kuopinghsu/jv32.dev/fpga/README.md

# jv32 SoC — FPGA Implementation (Kintex UltraScale+ KU5P)

**Tool:** Vivado ML Standard (free licence)
**Part:** `xcku5p-ffvb676-2-i` (Kintex UltraScale+, -2I speed grade, 676-pin FFVB)
**Default debug interface:** cJTAG / 2-wire OScan1 (`USE_CJTAG=1`)

---

## Directory layout

```
fpga/
├── Makefile                        # build orchestration
├── README.md
├── images/
│   └── jv32_bd.svg                 # IP Integrator block design diagram
├── jtag/
│   ├── jv32_fpga_cjtag.cfg         # OpenOCD config – USE_CJTAG=1 (2-wire)
│   └── jv32_fpga_jtag.cfg          # OpenOCD config – USE_CJTAG=0 (4-wire)
├── rtl/
│   ├── jv32_fpga_top.sv            # FPGA top-level wrapper (IOBUF, USE_CJTAG mux)
│   └── jv32_soc_fpga.v             # Plain-Verilog BD module reference wrapper
├── constrs/
│   ├── constraints.xdc             # Shared pin / clock constraints (both modes)
│   ├── constraints_cjtag.xdc       # Implementation-only: USE_CJTAG=1 clock + I/O
│   └── constraints_jtag.xdc        # Implementation-only: USE_CJTAG=0 I/O delays
├── scripts/
│   ├── create_project.tcl          # Vivado project / synth / impl script
│   └── create_bd.tcl               # IP Integrator block design script
├── tests/
│   ├── Makefile
│   ├── fpga_stress.c               # Long-running FreeRTOS stability stress test
│   ├── mem_connect_check.gdb       # Quick JTAG smoke test (SBA path, ~30 s)
│   ├── mem_test_iram.gdb           # IRAM word pattern test (abstract mem, ~10 min)
│   ├── mem_test_dram.gdb           # DRAM word + byte/halfword test (abstract mem, ~15 min)
│   └── mem_test_progbuf.gdb        # IRAM + DRAM word pattern test (progbuf path, ~20 min)
└── build/                          # Vivado project output (git-ignored)
    ├── jv32_ku5p_cjtag.bit         # USE_CJTAG=1 bitstream (default)
    ├── jv32_ku5p_cjtag.mcs         # USE_CJTAG=1 SPI flash image
    ├── jv32_ku5p_cjtag.prm         # USE_CJTAG=1 flash programming params
    ├── jv32_ku5p_jtag.bit          # USE_CJTAG=0 bitstream
    ├── jv32_ku5p_jtag.mcs          # USE_CJTAG=0 SPI flash image
    └── jv32_ku5p_jtag.prm          # USE_CJTAG=0 flash programming params
```

---

## Prerequisites

| Requirement | Notes |
|---|---|
| Vivado ML Standard 2023.x or later | Free licence — no cost for KU5P devices |
| RISC-V GNU toolchain (`riscv64-unknown-elf-`) | For building `fpga/tests/` firmware |
| FT2232H-based JTAG/cJTAG probe | e.g. Digilent HS2, FTDI FT2232H mini-module |
| OpenOCD ≥ 0.12 with `oscan1_mode` support | Required for USE_CJTAG=1 |

Add `RISCV_PREFIX` to `env.config` if your toolchain prefix differs from the default.

---

## Quick start

```bash
cd fpga/

# Create Vivado project (cJTAG default, no synthesis yet)
make project

# Run synthesis only
make synth

# Full implementation + bitstream generation
make impl

# 4-wire JTAG variant
make impl USE_CJTAG=0
```

Bitstream and MCS files land in `build/`.

---

## Block Design

jv32 Block Design

The IP Integrator block design `jv32_bd` contains three cells:

| Cell | IP / Type | Role |
|---|---|---|
| `clk_wiz_0` | Clocking Wizard (MMCM) | 50 MHz board clock → 50 MHz clean `clk_out1`; exports `locked` |
| `proc_sys_reset_0` | Processor System Reset | Holds `rst_n` (active-low) low until MMCM `locked` asserts |
| `u_soc` | `jv32_soc_fpga` (RTL module ref) | jv32 SoC — plain-Verilog wrapper around `jv32_soc.sv` |

The `IOBUF` primitive (bidirectional TMSC pad) and the `USE_CJTAG` I/O mux are
**not** inside the block design — they live in `jv32_fpga_top.sv` because
Vivado's IP Integrator does not support inout ports on RTL module references.

The generated wrapper `jv32_bd_wrapper` is instantiated in `jv32_fpga_top.sv`,
which remains the synthesis and implementation top module.

### Block design external ports

| Port | Dir | Connected to (jv32_fpga_top.sv) |
|---|---|---|
| `clk_in1` | I | `clk_50m` (FPGA pin E18) |
| `jtag_tck_i` | I | `jtag_tck_i` port |
| `jtag_tmsc_in` | I | `tmsc_in` — IOBUF output (pad → fabric) |
| `jtag_tdi_i` | I | `jtag_tdi_i` port (muxed to `0` inside `jv32_soc_fpga` when `USE_CJTAG=1`) |
| `soc_tms_o` | O | `tmsc_out` — IOBUF input (fabric → pad, cJTAG only) |
| `soc_tms_oe` | O | `tmsc_oe_n` — IOBUF tristate (`T`), active-low |
| `soc_tdo_o` | O | `jtag_tdo_o` port (4-wire JTAG only) |
| `uart_rx_i` | I | `uart_rx_i` port |
| `uart_tx_o` | O | `uart_tx_o` port |

---

## I/O Pin Assignment

All user I/O is on the **HR (High Range) bank**, 3.3 V LVCMOS33, except the
system clock which is on an **HP (High Performance) bank**, 1.8 V LVCMOS18.

| Signal | Pin | Bank / Std | Direction | Function |
|---|---|---|---|---|
| `clk_50m` | E18 | HP / LVCMOS18 | I | 50 MHz system clock |
| `jtag_tck_i` | D11 | HR / LVCMOS33 | I | TCK (4-wire) / TCKC (cJTAG) |
| `jtag_tmsc_io` | E12 | HR / LVCMOS33 | I/O | TMS (4-wire) / TMSC (cJTAG, bidir) |
| `jtag_tdi_i` | C12 | HR / LVCMOS33 | I | TDI — 4-wire JTAG only; tie to GND in cJTAG |
| `jtag_tdo_o` | J12 | HR / LVCMOS33 | O | TDO — driven by TAP in both modes; not connected in cJTAG (TDO is read back via TMSC/E12) |
| `uart_tx_o` | G12 | HR / LVCMOS33 | O | UART TX |
| `uart_rx_i` | J14 | HR / LVCMOS33 | I | UART RX |
| `heartbeat_o` | H9 | HR / LVCMOS33 | O | LED6 — toggles every 2²⁴ retired instructions |
| `led1_o` | J11 | HR / LVCMOS33 | O | LED3 — 1 Hz blink (1 s on / 1 s off, from clk/rst_n) |
| `led2_o` | J10 | HR / LVCMOS33 | O | LED4 — invert of led1_o for cJTAG, 0 for JTAG |

---

## USE_CJTAG Configuration

`USE_CJTAG` selects the debug interface. The default is **`USE_CJTAG=1`** (2-wire cJTAG).

| `USE_CJTAG` | Interface | Wires used | `jtag_tmsc_io` (E12) | `jtag_tdi_i` (C12) | `jtag_tdo_o` (J12) |
|:---:|---|:---:|---|---|---|
| **1 (default)** | 2-wire cJTAG (IEEE 1149.7 OScan1) | TCKC + TMSC | **bidir** — IOBUF driven by SoC | tie to GND on PCB | driven by TAP (not connected in cJTAG wiring) |
| 0 | 4-wire JTAG (IEEE 1149.1) | TCK + TMS + TDI + TDO | input only — IOBUF permanently tristated | TDI data in | TDO data out |

The parameter is set at synthesis time:

```bash
make impl USE_CJTAG=1   # default: cJTAG (2-wire)
make impl USE_CJTAG=0   # 4-wire JTAG
```

Vivado passes it as a generics override on the fileset:
```tcl
set_property generic "USE_CJTAG=1'b${use_cjtag}" [current_fileset]
```

### IOBUF behaviour per mode

```
              USE_CJTAG=1 (cJTAG)          USE_CJTAG=0 (JTAG)
              ─────────────────────────    ────────────────────
IOBUF.T    =  soc_tms_oe (1=input, 0=drive)   1'b1  (always input)
IOBUF.I    =  soc_tms_o  (TMSC drive data)    1'b0  (unused)
IOBUF.O    =  tmsc_in  ──► SoC TMS/TMSC input (both modes)
jtag_tdo_o =  1'b0        (TDO unused)        soc_tdo_o
```

---

## Clock Architecture

### Shared constraints (`constraints.xdc`)

The 50 MHz system clock on E18 and the `create_clock` for it are owned by the
`clk_wiz_0` IP XDC (redefining it here would cause XDCC-1/XDCC-7 methodology
warnings).  The shared XDC only sets the pin and I/O standard, adds input
jitter, and declares the UART false paths:

```xdc
set_property PACKAGE_PIN E18 [get_ports clk_50m]
set_property IOSTANDARD LVCMOS18 [get_ports clk_50m]
set_input_jitter clk_50m 0.200

create_clock -period 100.000 -name jtag_tck [get_ports jtag_tck_i]
set_clock_groups -asynchronous \
    -group [get_clocks -include_generated_clocks clk_50m] \
    -group [get_clocks jtag_tck]
```

### USE_CJTAG=1 — `constraints_cjtag.xdc` (implementation only)

In cJTAG mode the TAP clock (`tap_tck`) is generated **inside the SoC** by
`cjtag_bridge` as a registered pulse, buffered through a `BUFG`
(`u_bufg_tck`).  The primary clock must be created on the **BUFG output pin**
to avoid TIMING-1 ("inappropriate pin for clock") and follow Xilinx UG949
recommendations for internally-generated clocks.

```xdc
create_clock -period 100.000 -name tap_tck -waveform {0.000 50.000} \
    [get_pins {u_bd/jv32_bd_i/u_soc/inst/u_soc/gen_jtag.u_jtag/
               gen_pin_mux_cjtag.u_cjtag_bridge/u_bufg_tck/O}]

set_clock_groups -asynchronous \
    -group [get_clocks tap_tck] \
    -group [get_clocks -include_generated_clocks clk_50m]

# tap_tck is downstream of clk_out1 (BUFG driven by an MMCM-clocked FF)
# → declare physically_exclusive to suppress TIMING-3 (AR#63774).
set_clock_groups -physically_exclusive \
    -group [get_clocks -include_generated_clocks clk_50m] \
    -group [get_clocks tap_tck]

set_false_path -from [get_ports jtag_tmsc_io]
set_false_path -to   [get_ports jtag_tmsc_io]
set_false_path -from [get_ports jtag_tdi_i]
set_false_path -to   [get_ports jtag_tdo_o]
```

Maximum TCKC frequency: **50 MHz ÷ 6 ≈ 8.3 MHz** (cjtag_bridge requirement:
`f_sys ≥ 6 × f_tckc`).  The OpenOCD config uses **5 MHz** for margin.

### USE_CJTAG=0 — `constraints_jtag.xdc` (implementation only)

In 4-wire JTAG mode the external `jtag_tck_i` pin is the primary clock source
(declared in `constraints.xdc`).  TDI is captured on the rising edge of TCK;
TDO is launched on the **falling** edge.

```xdc
set_false_path -from [get_ports jtag_tmsc_io]
set_false_path -to   [get_ports jtag_tmsc_io]

set_input_delay  -clock jtag_tck -max 10.0            [get_ports jtag_tdi_i]
set_input_delay  -clock jtag_tck -min  0.0 -add_delay [get_ports jtag_tdi_i]

set_output_delay -clock jtag_tck -clock_fall -max 10.0            [get_ports jtag_tdo_o]
set_output_delay -clock jtag_tck -clock_fall -min  0.0 -add_delay [get_ports jtag_tdo_o]
```

Maximum TCK frequency: **10 MHz** (100 ns period, `constraints.xdc`).
The OpenOCD config uses **10 MHz**; reduce to 1 MHz if signal integrity is poor.

### Clock domain summary

| Clock | Source | Frequency | Domain |
|---|---|---|---|
| `clk_out1_*` (system) | MMCM (`clk_wiz_0`) from E18 | 50 MHz | `jv32_soc`, AXI peripherals, UART, CLIC |
| `tap_tck` | Internal BUFG in `cjtag_bridge` | ≤ 8.3 MHz | TAP, DTM (`USE_CJTAG=1`) |
| `jtag_tck` | External pin D11 | ≤ 10 MHz | TAP, DTM (`USE_CJTAG=0`) |

The two clock domains are fully asynchronous; CDC is handled by the
multi-stage synchroniser chains in `jv32_dtm`.

---

## Vivado project variables

| Variable | Default | Description |
|---|---|---|
| `VIVADO` | `vivado` | Path to Vivado executable |
| `PROJ_NAME` | `jv32_ku5p` | Vivado project name |
| `PROJ_DIR` | `fpga/build` | Project output directory (repo-relative) |
| `TOP_MODULE` | `jv32_fpga_top` | Synthesis/implementation top module |
| `FPGA_PART` | `xcku5p-ffvb676-2-i` | Xilinx device part number |
| `JV32_CLK_HZ` | `50000000` | System clock frequency (Hz) — passed to SoC |
| `FLASH_PART` | `mt25qu256-spi-x1_x2_x4` | SPI flash part for MCS generation |
| `USE_CJTAG` | **`1`** | `1` = 2-wire cJTAG (default); `0` = 4-wire JTAG |

RTL `define` macros enabled in Vivado:

| Macro | Effect |
|---|—|
| `XILINX_URAM` | Selects UltraRAM inference path in `sram_1rw.sv` (XCKU5P has URAMs) |

---

## Connecting a debug probe

### Physical wiring (FPGA board)

The physical connector on the FPGA board exposes all four JTAG signals on a
standard 2×5 or 1×5 header.  **The same four-wire connection is used for both
JTAG and cJTAG on this FPGA board** — just select the matching OpenOCD config.

```
 FT2232H                         XCKU5P (LVCMOS33)
 Channel A

 ADBUS0 ──── TCK / TCKC ────────► D11  jtag_tck_i
 ADBUS1 ──── TDI        ────────► C12  jtag_tdi_i   (unused / don't-care in cJTAG)
 ADBUS2 ◄─── TDO        ◄──────── J12  jtag_tdo_o
 ADBUS3 ──── TMS / TMSC ◄──────►  E12  jtag_tmsc_io (IOBUF: input-only in JTAG,
 GND    ──── GND                   GND               bidir in cJTAG)
```

| ADBUS | Signal | Dir | FPGA pin | Note |
|---|---|---|---|---|
| ADBUS0 | TCK / TCKC | → | D11 | clock |
| ADBUS1 | TDI | → | C12 | JTAG data in; ignored in cJTAG |
| ADBUS2 | TDO | ← | J12 | TAP TDO in both modes |
| ADBUS3 | TMS / TMSC | ↔ | E12 | input-only in JTAG; bidir IOBUF in cJTAG |

---

### Mode 1 — 4-wire JTAG (`USE_CJTAG=0` bitstream)

```bash
openocd -f fpga/jtag/jv32_fpga_jtag.cfg
```

Standard IEEE 1149.1.  E12 IOBUF is permanently tristated (input only).

---

### Mode 2 — cJTAG OScan1 on FPGA (`USE_CJTAG=1` bitstream)

```bash
openocd -f fpga/jtag/jv32_fpga_cjtag.cfg
```

IEEE 1149.7 OScan1.  `cjtag_bridge.sv` drives TMSC (E12) and handles all
activation/escape sequencing.  ADBUS3 drives TMSC; ADBUS2 reads TDO from J12.

> **FPGA emulation only — no board modification needed.**
> `jv32_fpga_top.sv` routes `soc_tdo_o` to J12 even in cJTAG mode so that a
> standard four-wire probe can read TDO on ADBUS2/J12 directly.  This is an
> FPGA verification convenience; a real cJTAG silicon device does **not** have
> a separate TDO pin.

---

### Connecting to a real cJTAG chip (silicon)

On actual silicon, TDO is not available on a separate pin — it is embedded in
the TMSC bit stream (OScan1 phase 2).  Two options:

**Option A — Native cJTAG DTS (recommended)**

Use a debug tool station (DTS) with built-in IEEE 1149.7 support.  Only two
wires are needed:

```
 DTS / cJTAG probe

 TCKC ───────────────────────────  TCKC pin of target
 TMSC ◄──────────────────────────► TMSC pin of target (bidir)
 GND  ───────────────────────────  GND
```

**Option B — FT2232H probe board modification**

FTDI MPSSE hardwires TDO capture to ADBUS2 (cannot be remapped in software).
In OScan1 mode TDO is on the TMSC line, so ADBUS2 must be connected to TMSC.
Bridge ADBUS2 and ADBUS3 together on the probe board, both to the TMSC pin:

```
 FT2232H (modified probe)         Target chip
 Channel A

 ADBUS0 ──── TCKC ──────────────► TCKC
             TMSC ◄─────────────► TMSC (bidir)
 ADBUS3 ─────┘ ↑  drive nTDI/TMS
 ADBUS2 ───────┘    read TDO       (ADBUS2 + ADBUS3 bridged on probe board)
 GND    ──── GND  ───────────────  GND
```

Use `fpga/jtag/jv32_fpga_cjtag.cfg` with this wiring (the OpenOCD config is
the same; the difference is only on the probe board).

---

## Debugging with GDB on FPGA

The GDB test scripts in `openocd/` work against the FPGA unchanged. The only
difference from the VPI simulation tests is the adapter: use the FPGA OpenOCD
config instead of `jv32.cfg` (which targets the VPI TCP socket).

**1. Start OpenOCD with GDB server enabled**

```bash
# cJTAG (default bitstream)
openocd -f fpga/jtag/jv32_fpga_cjtag.cfg \
        -c "gdb port 3333" \
        -c "tcl port disabled" \
        -c "telnet port disabled" \
        -c init

# 4-wire JTAG (USE_CJTAG=0 bitstream)
openocd -f fpga/jtag/jv32_fpga_jtag.cfg \
        -c "gdb port 3333" \
        -c "tcl port disabled" \
        -c "telnet port disabled" \
        -c init
```

**2. Connect GDB**

```bash
# Interactive session
riscv64-unknown-elf-gdb -ex "target extended-remote :3333" -ex "load" build/hello.elf

# Run a test script non-interactively (same scripts as the VPI tests)
riscv64-unknown-elf-gdb --batch \
    -ex "set pagination off" \
    -ex "set confirm off" \
    -ex "set remotetimeout 30" \
    -ex "target extended-remote :3333" \
    -ex "load" \
    -x openocd/test_gdb_breakpoint.gdb \
    build/hello.elf
```

**3. Required GDB session setup**

Two settings must be applied at the start of every interactive GDB session (the
`openocd/test_gdb_*.gdb` scripts already include them):

```
# (a) Allow GDB to access memory outside the ELF LOAD segments.
#     Without this, any access to DRAM, bare IRAM scratch, or stack
#     regions not covered by the ELF fails with
#     "Cannot access memory at address 0x...".
set mem inaccessible-by-default off
mem 0x80000000 0x80020000 rw    # IRAM  128 KB
mem 0x90000000 0x90020000 rw    # DRAM  128 KB

# (b) Switch OpenOCD to progbuf memory-access mode.
#     The config files default to "sysbus abstract" mode.  progbuf mode
#     is required for: software breakpoints, "load", "set {int}addr = val",
#     and any GDB memory-write packet.  Register read/write and hardware
#     breakpoints work in any mode.
monitor riscv set_mem_access progbuf
```

Recommended interactive session startup:

```bash
riscv64-unknown-elf-gdb \
    -ex "set mem inaccessible-by-default off" \
    -ex "mem 0x80000000 0x80020000 rw" \
    -ex "mem 0x90000000 0x90020000 rw" \
    -ex "target extended-remote :3333" \
    -ex "monitor riscv set_mem_access progbuf" \
    build/hello.elf
```

**4. Notes**

- All `openocd/test_gdb_*.gdb` scripts work against the FPGA without modification;
  they already include both settings above.
- If your FT2232H probe has a non-default VID/PID (e.g. Digilent HS2 uses
  `0x0403 0x6014`), update the `ftdi vid_pid` line in the relevant `.cfg` file.
- The GDB port (`3333`) and VPI port (`5555`) are only used in simulation;
  on FPGA there is no VPI process to start.

---

## Loading firmware via OpenOCD

```bash
# Load and run ELF (built by make -C fpga/tests)
openocd -f fpga/jtag/jv32_fpga_cjtag.cfg \
        -c "program build/fpga-stress.elf verify reset exit"
```

UART output is on `uart_tx_o` (G12), **921600 8N1**:

```bash
# Linux
stty -F /dev/ttyUSBx 921600 raw && cat /dev/ttyUSBx
# Windows / macOS: PuTTY / CoolTerm at 921600 8N1
```

---

## FPGA stress test

`fpga/tests/fpga_stress.c` is a long-running FreeRTOS stability test designed
to run for days/weeks on the FPGA, exercising CPU execution, memory, UART,
queues, semaphores, event groups, and a recursive mutex.

```bash
make -C fpga/tests          # build/fpga-stress.elf (output goes to top-level build/)
openocd -f fpga/jtag/jv32_fpga_cjtag.cfg \
        -c "program build/fpga-stress.elf verify reset exit"
```

One status line is printed over UART every 5 seconds:
```
[HHH:MM:SS] A=<cpu_iters> B=<q_sent> C=<ev_rounds> D=<sem_rounds>
            E=<mtx_iters> F=<mem_allocs> err=<total> heap=<free> wdf=<wdog_faults>
```

---

## JTAG connection verification

Three GDB scripts in `fpga/tests/` verify the JTAG debug path after programming
a new bitstream, without requiring any firmware to be built.

| Script | Path tested | Region | Time |
|---|---|---|---|
| `mem_connect_check.gdb` | **SBA** (`SBADDRESS0`/`SBDATA0`) | 8 words × 2 @ end of IRAM/DRAM | ~30 s |
| `mem_test_iram.gdb` | **Abstract memory** (`CMD_ACCESS_MEM`) | 4 KB @ `0x8001E000` | ~10 min |
| `mem_test_dram.gdb` | **Abstract memory** + byte/hw lanes | 4 KB + 64 B @ `0x9001E000` | ~15 min |
| `mem_test_progbuf.gdb` | **Program buffer** (hart-executed lw/sw) | 4 KB each: IRAM + DRAM | ~20 min |

Run them in order — `mem_connect_check` first to confirm basic connectivity,
then the pattern tests to exercise the full memory path.

```bash
# Terminal 1 — start OpenOCD (pick the matching config for your bitstream)
openocd -f fpga/jtag/jv32_fpga_jtag.cfg     # USE_CJTAG=0 bitstream
# or
openocd -f fpga/jtag/jv32_fpga_cjtag.cfg    # USE_CJTAG=1 bitstream (default)

# Terminal 2 — run the scripts
riscv64-unknown-elf-gdb -q -x fpga/tests/mem_connect_check.gdb
riscv64-unknown-elf-gdb -q -x fpga/tests/mem_test_iram.gdb
riscv64-unknown-elf-gdb -q -x fpga/tests/mem_test_dram.gdb
riscv64-unknown-elf-gdb -q -x fpga/tests/mem_test_progbuf.gdb
```

Each script halts the hart, runs its tests, prints a `[PASS]` / `[FAIL]` summary,
and exits with code 0 on success or 1 on failure.  The hart is left halted.

### What each test covers

**`mem_connect_check.gdb`** — Uses `monitor mww` / `monitor mdw` (OpenOCD SBA
commands) to write and read back 8 fixed patterns in IRAM and DRAM.  Also reads
`misa` and `mhartid` CSRs and warns if they do not match the expected values
(`0x40001105` = RV32IMAC, `0x00000000`).

**`mem_test_iram.gdb`** — Uses GDB native `{unsigned int}addr` memory access
(routes through the abstract memory command in `jv32_dtm`) to run six patterns
over a 4 KB window at `0x8001E000` (last 8 KB of the 128 KB IRAM):

| Phase | Pattern | Words | Passes | Detects |
|---|---|---|---|---|
| 1 | Walking-1 | 32 | 1 | Stuck-at-0 bit faults |
| 2 | Walking-0 | 32 | 1 | Stuck-at-1 bit faults |
| 3 | Address unique | 1024 | 4 | Address aliasing / stuck address lines |
| 4 | Checkerboard | 1024 | 4 | Inter-cell coupling |
| 5 | Inv-address | 1024 | 1 | Complement of address pattern |
| 6 | Pseudo-random | 1024 | 1 | Broad data pattern coverage (XOR-shift hash) |

**`mem_test_dram.gdb`** — Same six word patterns over `0x9001E000`, then two
additional sub-tests at `0x9001F000` that exercise the byte-enable generation
logic in `jv32_dtm` (the `CMD_ACCESS_MEM` aamsize field):

| Phase | Access | Region | What is verified |
|---|---|---|---|
| 1–6 | Word (`{int}`) | 4 KB @ `0x9001E000` | Same six patterns as IRAM |
| 7 | Byte (`{char}`) | 64 B @ `0x9001F000` | All 4 byte lanes: write one lane, confirm others are zero, read back byte (16 words) |
| 8 | Halfword (`{short}`) | 64 B @ `0x9001F000` | Both halfword lanes: write one lane, confirm other is zero, read back halfword (16 words) |

**`mem_test_progbuf.gdb`** — Forces `monitor riscv set_mem_access progbuf` after
halt, then runs the same six word patterns over both IRAM and DRAM.  This
exercises the hart-executed path (OpenOCD writes `lw`/`sw` + `ebreak` into the
2-word program buffer) rather than the DM-internal abstract command or SBA
paths.  Memory access is restored to `sysbus abstract` on exit.

| Region | Base | Phases | Words |
|---|---|---|---|
| IRAM | `0x8001E000` | 6 (same patterns as `mem_test_iram.gdb`) | 1024 |
| DRAM | `0x9001E000` | 6 (same patterns as `mem_test_iram.gdb`) | 1024 |
