kuopinghsu/jv32.dev/docs/jv32_soc_datasheet.adoc

= JV32 System-on-Chip Datasheet
:doctype: book
:author: JV32 Development Team
:revnumber: 1.4
:revdate: 2026-09-15
:toc: left
:toclevels: 4
:sectnums:
:sectnumlevels: 4
:icons: font
:source-highlighter: rouge
:table-caption: Table
:figure-caption: Figure
:appendix-caption: Appendix
:title-logo-image: JV32 Logo

[abstract]
--
JV32 is a compact 32-bit RISC-V System-on-Chip (SoC) for RTL simulation and FPGA prototyping. It integrates a single-issue 3-stage processor core, instruction and data TCM, AXI4-Lite interfaces, UART, a project-specific local interrupt controller with CLINT-style timer/software-interrupt registers, simulation support, and JTAG/cJTAG debug connectivity.

This datasheet describes the implemented RTL behavior. Unless stated otherwise, addresses, reset values, timing, and feature descriptions refer to the default RTL parameters.
--

<<<

== Introduction

=== SoC Overview

The JV32 SoC is a compact embedded processor system. The default configuration implements RV32IMAC with M-mode (M-mode). The main blocks are:

* **Processor core** (`jv32_core`): single-issue 3-stage pipeline (IF → EX → WB), RVC expansion, configurable multiply/divide/shift units, branch prediction, and atomic-operation support
* **Tightly Coupled Memories (TCM)**: 128 KB IRAM at `0x8000_0000` and 128 KB DRAM at `0x9000_0000` by default, with 1-cycle read latency
* **Merged AXI4-Lite Master**: Out-of-TCM accesses from both I-fetch and D-bus share one master port; D-bus has priority over I-fetch
* **AXI4-Lite Slave**: External agents (debug master, testbench DPI) can read/write TCM; core has absolute priority
* **Peripheral Subsystem** (4-target AXI crossbar): UART, local interrupt controller, Magic device, external catch-all
* **Interrupt System**: local interrupt controller with CLINT-style 64-bit timer (`mtime`/`mtimecmp`), software interrupt (`msip`), and 16 prioritized external interrupt lines. The register model is implementation-specific and must not be described as full RISC-V CLIC compliance.

=== Document Conventions

This datasheet describes the behavior implemented by the supplied RTL. Unless a section explicitly states otherwise:

* Address ranges and reset values refer to the default RTL parameters unless explicitly marked as parameter-dependent.
* `R/O`, `R/W`, and `W/O` mean read-only, read/write, and write-only.
* Multi-byte values use little-endian byte order.
* AXI response names use the AXI4-Lite encodings `OKAY`, `SLVERR`, and `DECERR`.
* Signal names and RTL parameter names are shown in monospace, for example `ext_irq_i` and `IRAM_SIZE`.
* Optional features are identified by the RTL parameter that enables them.
* Software must not rely on undocumented or reserved register bits. Unless explicitly stated otherwise, software should write zero to reserved bits and ignore reserved bits when reading.
* “Implemented” means that an active RTL path provides the stated behavior; a declared constant or unused encoding alone is not treated as an implemented feature.
* `must` identifies a software or integration requirement. `should` identifies a recommended practice. Descriptive statements define RTL behavior.
* Reset values apply to the corresponding RTL state after reset has been asserted. Software-visible state may change immediately after reset is released as counters, timers, or execution begin.

=== Scope and Implementation Notes

The datasheet is an RTL functional specification. It does not define FPGA- or ASIC-specific timing closure, maximum clock frequency, power, area, or electrical characteristics. Those values depend on the target technology, synthesis constraints, and physical implementation.

Unless stated otherwise, sizes, counts, base addresses, and enabled features use the RTL default parameters. If an integration changes a parameter, the corresponding feature, memory size, or ISA capability may also change.

Behavior outside the documented address ranges, register encodings, access sizes, or enabled feature set is not part of the software interface unless the relevant section explicitly defines it.

Microarchitectural details such as pipeline timing, arbitration timing, and internal state transitions describe the current RTL implementation. Software must not depend on cycle-exact behavior unless a section explicitly defines that behavior as part of the interface.

=== Compliance Status and Verification Boundary

This revision distinguishes *implemented behavior* from *standards conformance*. The RTL was statically reviewed against the programmer-visible requirements described in this datasheet and against the relevant RISC-V architectural concepts. Static source review can establish what the RTL decodes and exposes, but it cannot prove complete ISA, privileged-architecture, debug, AXI, or cJTAG compliance.

The following terminology is used throughout this document:

* **Implemented** — directly supported by the supplied RTL.
* **RISC-V architectural behavior** — behavior intended to follow the cited RISC-V ISA or privileged architecture.
* **Subset / implementation-specific** — only the documented functions are provided; software must not assume unimplemented optional features.
* **Compliance not established** — requires directed testbenches, architectural compliance suites, protocol assertions, or external debugger interoperability tests.

Important implementation boundaries found during review:

* `axi_clic` is a JV32 local interrupt controller with CLINT-style timer/software-interrupt registers and a compact external-interrupt array. It is **not documented as a complete standard CLIC implementation**.
* The debug block implements a useful subset of RISC-V Debug Specification 1.0 behavior, but this datasheet does **not** claim formal Debug Spec compliance.
* `AMO_EN=0` makes all AMO-opcode instructions illegal, including LR.W and SC.W. Verified by `sw/amo_config` in both atomic configurations and by the disabled-decoder sweep; the RTL parameter comment matches this behavior.
* AXI4-Lite behavior is implementation-specific to the documented channels and ordering restrictions. Protocol compliance should be verified with AXI assertions/testbench coverage.

=== Default Configuration

The table below summarizes the principal RTL defaults. Parameters remain the authoritative source when an integration overrides these values.

[cols="2,2,4"]

.Default RTL Configuration
|===
|Item |Default |Notes

|XLEN
|32
|32-bit RISC-V implementation.

|Privilege mode
|M-mode
|The core implements M-mode operation.

|Base ISA
|RV32I
|RV32E can be selected when enabled by the corresponding RTL parameter.

|ISA extensions enabled by default
|M, A, C, Zicsr, Zifencei, Zba, Zbb, Zbs, Zcmp
|`RV32M_EN`, `AMO_EN`, `RV32B_EN`, and `ZCMP_EN` control parameterized extension groups. C, Zicsr, and Zifencei are implemented by the supplied core configuration.

|System clock parameter
|100 MHz
|Functional default only; not a defined implementation Fmax.

|External interrupts
|16
|Handled by the local interrupt-controller path.

|UART
|115200 baud
|Reset/default baud rate; software can change the divisor at runtime.
|===

=== Key Features

[cols="1,3"]
|===
|Feature |Specification

|ISA
|Default configuration: RV32IMAC with Zicsr, Zifencei, Zba, Zbb, Zbs, and Zcmp enabled. `misa = 0x4000_1105` reports the standard MISA-visible I/M/A/C capabilities; Zba/Zbb/Zbs and Zcmp are controlled separately by RTL parameters.

|Pipeline
|Single-issue 3-stage in-order (Fetch, Execute, Writeback); WB→EX same-cycle forwarding; 1-cycle load-use stall; optional single-slot non-blocking MUL scoreboard (`SCOREBOARD_EN`); BTFNT static branch predictor (`BP_EN=1`): no EX-stage correction flush on correct prediction, one EX-stage correction/flush cycle on misprediction

|Instruction Memory
|128 KB IRAM (TCM, 1-cycle access); out-of-TCM I-fetch via shared AXI4-Lite master

|Data Memory
|128 KB DRAM (TCM, 1-cycle access); IRAM is also D-accessible (IRAM address range); out-of-TCM via shared AXI4-Lite master

|Privilege Modes
|Machine (M-mode) only

|Bus Protocol
|AXI4-Lite (32-bit address, 32-bit data)

|Clock Frequency
|100 MHz default; parameterized

|Boot Address
|`0x8000_0000` (IRAM base, parameterized)

|TCM Sizes
|128 KB IRAM, 128 KB DRAM (each independently parameterized, power-of-2)

|Peripherals
|UART (8N1, 16-deep FIFOs), local interrupt controller (CLINT-style timer/software interrupt plus 16 external IRQs), Magic (simulation I/O)

|Interrupts
|Machine timer, machine software, and 16 local-controller external interrupt lines (`ext_irq_i[15:0]`)

|Multiply Latency
|1 cycle (`FAST_MUL=1`), 1–32 cycles (`FAST_MUL=0`, CLZ-reduced on multiplier)

|Divide Latency
|1 cycle (`FAST_DIV=1`), 1–32 cycles (`FAST_DIV=0`, CLZ-reduced on dividend)

|Implementation
|RTL simulation (Verilator), FPGA synthesis supported
|===

<<<

== System Architecture

=== Block Diagram

[ditaa, format="svg", width=400, font="Arial", align="center"]
....
 +------------------------------------------------------------------------+
 |                        JV32 SoC Top Level                              |
 |                                                                        |
 |  +-------------------------------------------------------------------+ |
 |  |                        jv32_top                                   | |
 |  |                                                                   | |
 |  |  +------------+  I fetch  +===========+                           | |
 |  |  |            +---------->| IRAM TCM  |<-+ D access (IRAM range)  | |
 |  |  | jv32_core  |           | (128 KB)  |  |                        | |
 |  |  |            |           +===========+  |                        | |
 |  |  |  3 stage   +--D access-----------+----+                        | |
 |  |  |  pipeline  |                     |                             | |
 |  |  |            |                     +-->+===========+             | |
 |  |  |            |                         | DRAM TCM  | (128 KB)    | |
 |  |  |            |  out of TCM miss        +===========+             | |
 |  |  |            +----------I fetch------->+----------+              | |
 |  |  |            +----------D access------>| AXI Mstr |              | |
 |  |  +------------+       D > I priority    +-----+----+              | |
 |  |                                               |                   | |
 |  |  s_axi <-- AXI Slave (debug/DPI TCM access)   |                   | |
 |  +-----------------------------------------------+-------------------+ |
 |                                                  |  m_axi              |
 |                                         +--------v---------+           |
 |                                         |   AXI4 Lite      |           |
 |                                         |   Crossbar (1:4) |           |
 |                                         +--+---+---+-------+           |
 |                                            |   |   |                   |
 |                 Slave 0: UART  0x2001_0000-+   |   |                   |
 |                   +--------------------------+ |   |                   |
 |                   | TX/RX FIFOs (16 deep)    | |   |                   |
 |                   | 8N1, prog baud rate      |---->uart_tx             |
 |                   | irq (rx/tx FIFO level)   |<----uart_rx             |
 |                   | uart_irq (IRQ output)    +-+   |                   |
 |                   +--------------------------+ |   |                   |
 |                                                |   |                   |
 |                 Slave 1: CLIC  0x0200_0000-----+   |                   |
 |                   +--------------------------+     |                   |
 |                   | mtime / mtimecmp (64 bit)|     |                   |
 |                   | msip (software IRQ)      +---->timer_irq           |
 |                   | 16 ext IRQ lines         +---->software_irq        |
 |                   +--------------------------+---->external_irq        |
 |                     ^  ^                           |                   |
 |                     |  +-- uart_irq (ORed [0])     |                   |
 |                     +----- ext_irq_i[15:0]         |                   |
 |                 Slave 2: Magic  0x4000_0000--------+                   |
 |                   +--------------------------+                         |
 |                   | Console stdout write     |                         |
 |                   | Simulation exit control  |                         |
 |                   +--------------------------+                         |
 |                 Slave 3: External (catch-all)                          |
 |                   ext_axi_* ---- forwarded to SoC top-level ports      |
 |                                                                        |
 +------------------------------------------------------------------------+
    External Pins:
      clk, rst_n
      uart_tx_o, uart_rx_i
      ext_irq_i[15:0]
      s_tcm_axi_* (optional debug/DMA slave access to TCM)
....

=== System Components

==== Processor and Memory Integration

The processor and integrated memory-mapped interfaces use little-endian byte ordering. Bit numbering follows the RISC-V convention: bit 0 is the least-significant bit. Addresses are byte addresses.

The `jv32_core` processor implements a single-issue 3-stage in-order pipeline:

* **Instruction Fetch (IF)**: PC generation, RVC expansion, instruction fetch request
* **Execute (EX)**: Decode, register read, ALU, address calculation, CSR operations, hazard detection
* **Writeback (WB)**: Memory result, register writeback, branch redirect, exception handling

The core supports:

* Single-issue in-order execution; Slot-A all instructions; no dual-issue
* WB→EX same-cycle forwarding for RAW hazard resolution
* 1-cycle load-use stall (EX→WB stall + IF hold)
* 1-cycle branch/jump flush (EX squashes IF on misprediction or unconditional redirect)
* Multi-cycle stall for slow divide/shift and for multiply when scoreboard dispatch is not active
* Optional single-slot non-blocking scoreboard (`SCOREBOARD_EN`) for multi-cycle `MUL`: independent younger instructions may issue while preserving in-order retirement
* AMO (LR/SC and AMO operations) via a 3-state machine (IDLE → LOAD_WAIT → STORE_WAIT)
* Configurable branch predictor (`BP_EN`, static not-taken fallback when disabled)
* CLIC-aware CSR unit with CLIC interrupt-level threshold (`mintthresh`), current level (`mintstatus`), vectored-trap base (`mtvt`), next-interrupt fast-claim (`mnxti`), and hardware tail-chaining on `mret`

==== TCM: IRAM and DRAM (`jv32_top`)

Both TCM regions are instantiated inside `jv32_top` as a single 32-bit wide `sram_1rw` primitive per region, with byte-enable write support:

* **IRAM**: instance `u_iram`, base `IRAM_BASE` (default `0x8000_0000`), size `IRAM_SIZE` (default 128 KB); 32-bit data word, 4-bit write-byte-enable
* **DRAM**: instance `u_dram`, base `DRAM_BASE` (default `0x9000_0000`), size `DRAM_SIZE` (default 128 KB); same arrangement
* **1-cycle read latency**: Address presented at cycle N returns data at cycle N+1
* **Contention resolution**: When I-fetch and D-access both target IRAM, D-access wins; I-fetch stalls 1 cycle
* **SRAM arbitration priority**: Core-D > Core-I > AXI Slave

==== Merged AXI4-Lite Master

Out-of-TCM accesses from I-fetch and D-bus share one AXI4-Lite master (`m_axi_*`):

* D-bus has priority over I-bus when both miss TCM simultaneously
* Both are served sequentially (not simultaneously)
* I-fetch AXI transaction is cancelled/replaced if a branch redirect arrives during the outstanding fetch

==== AXI4-Lite Slave

External agents (debug master, pre-simulation ELF loader via DPI) access TCM through the slave port (`s_axi_*`):

* Core has absolute priority; slave stalls until the target SRAM is idle for the current cycle
* The slave read-data register latches SRAM output on the first granted cycle and holds it until the bus handshake completes
* For pre-simulation ELF loading, the recommended method is DPI `mem_write_byte` (direct SRAM array access), which is faster than AXI slave transactions

==== Peripheral AXI Crossbar

A 1-to-4 AXI4-Lite crossbar routes out-of-TCM transactions from `jv32_top`'s merged master to three named peripheral slaves (UART, CLIC, Magic) plus a fourth external catch-all slave. Address decode uses base/mask comparison (see <<_memory_map>>).

<<<

=== Register Table Conventions

Register tables use byte offsets relative to the peripheral base address unless an absolute address is explicitly shown. Reset values describe the RTL reset state before software modifies the register. For reserved fields, software should write zero and ignore the read value unless a section explicitly defines different behavior.

== Memory Map

=== Address Space Overview

The JV32 SoC implements a 32-bit address space (4 GB). The table lists the default address map. TCM region sizes follow the `IRAM_SIZE` and `DRAM_SIZE` parameters. The `0x6000_0000` and `0x7000_0000` regions are aliases of the canonical IRAM and DRAM regions; they do not provide additional storage. Software should normally use the canonical `0x8000_0000` and `0x9000_0000` addresses unless an alias is specifically required by the integration or debug flow.

[cols="2,2,1,4"]
.Default Memory Map
|===
|Address Range |Device |Size |Description

|`0x0200_0000` – `0x021F_FFFF`
|CLIC
|2 MB
|Project-specific local interrupt controller with CLINT-style timer/software-interrupt offsets; only the implemented offsets in the first 64 KB are meaningful

|`0x2001_0000` – `0x2001_00FF`
|UART
|256 B
|Serial communication peripheral (8N1, 16-deep FIFOs); 7 registers used (0x00–0x18); 0x1C–0xFF return `SLVERR`

|`0x4000_0000` – `0x4FFF_FFFF`
|Magic Device
|256 MB (aperture)
|Simulation console and exit control; only two 32-bit registers are implemented at offsets `0x0000` and `0x0004`

|`0x6000_0000` – `0x6001_FFFF`
|IRAM alias
|128 KB
|Alias of the default IRAM TCM region; internally mapped to `0x8000_0000` – `0x8001_FFFF`

|`0x7000_0000` – `0x7001_FFFF`
|DRAM alias
|128 KB
|Alias of the default DRAM TCM region; internally mapped to `0x9000_0000` – `0x9001_FFFF`

|`0x8000_0000` – `0x8001_FFFF`
|IRAM (TCM)
|128 KB
|Tightly-coupled instruction + data RAM (inside `jv32_top`)

|`0x9000_0000` – `0x9001_FFFF`
|DRAM (TCM)
|128 KB
|Tightly-coupled data RAM (inside `jv32_top`)
|===

NOTE: The canonical TCM regions and their aliases are decoded before the peripheral crossbar. They are decoded inside `jv32_top` before the AXI master port. Only accesses that miss TCM are forwarded to the crossbar.

=== Address Decode Rules

==== TCM Decode (inside `jv32_top`)

TCM is decoded combinatorially using power-of-2 masking:

[cols="1,2,3"]
.TCM Address Decode Functions
|===
|Region |Condition |Default

|IRAM
|`(addr & ~(IRAM_SIZE-1)) == IRAM_BASE`
|`IRAM_BASE=0x8000_0000`, `IRAM_SIZE=131072`

|DRAM
|`(addr & ~(DRAM_SIZE-1)) == DRAM_BASE`
|`DRAM_BASE=0x9000_0000`, `DRAM_SIZE=131072`
|===

The SoC also accepts the default alias windows at `0x6000_0000` (IRAM) and `0x7000_0000` (DRAM). Alias accesses are converted to the corresponding canonical TCM address. Accesses that do not match a canonical or alias TCM region are forwarded to the merged AXI master and peripheral crossbar.

==== Peripheral Crossbar Decode

The AXI crossbar (`axi_xbar`) decodes using base/mask:

[cols="1,1,1,1,3"]
.Peripheral Crossbar Address Decode
|===
|Slave |Device |Base |Mask |Notes

|0
|UART
|`0x2001_0000`
|`0xFFFF_FF00`
|256-byte aperture; 7 registers (DATA, STATUS, IE, IS, LEVEL, CTRL, CAPABILITY at 0x00–0x18)

|1
|Local interrupt controller
|`0x0200_0000`
|`0xFFE0_0000`
|2 MB aperture; CLINT-style timer/software registers plus implementation-specific external-interrupt array

|2
|Magic
|`0x4000_0000`
|`0xF000_0000`
|256 MB aperture; only two 32-bit registers are implemented (`0x0000` and `0x0004`)

|3
|External catch-all
|`0x0000_0000`
|`0x0000_0000`
|Matches all addresses not decoded by UART, CLIC, or Magic and forwards them to the `ext_axi_*` SoC ports. The final response is provided by the connected external target.
|===

In the default SoC map, addresses outside the internal TCM and named peripheral regions are forwarded to the external AXI target. They do not automatically produce `DECERR`; the external target determines the response.

<<<

== Processor Core Specification

=== Data Representation

The core uses 32-bit little-endian data representation. Bit 0 is the least-significant bit, and all addresses are byte addresses. Instruction alignment follows the enabled RISC-V compressed-instruction configuration.

=== ISA Support

=== RV32E Configuration

When `RV32E_EN=1`, the architectural integer register set is reduced to x0–x15. The decoder checks register fields according to the instruction format rather than blindly checking every encoded five-bit field:

* `rs1` is checked only for formats that actually use `rs1`.
* `rs2` is checked for OP, STORE, BRANCH, and AMO formats.
* `rd` is checked only when the decoded instruction writes a GPR.

An instruction that actually references x16–x31 is illegal. Immediate fields that happen to contain bit 4 in the same bit positions are not incorrectly rejected.

The core also forces Zba/Zbb/Zbs inactive and disables the RAS and instruction prefetch buffer when `RV32E_EN=1`. Compressed register-prime encodings use x8–x15 and remain within the RV32E register set.

[cols="1,4"]
.Supported ISA Extensions
|===
|Extension |Description

|RV32I
|Base integer instruction set (32-bit)

|M
|Integer multiply and divide, including MULH, MULHU, MULHSU, DIV, DIVU, REM, REMU

|A
|Atomic instructions: LR.W/SC.W, AMO{SWAP,ADD,XOR,AND,OR,MIN,MAX,MINU,MAXU}.W

|C (Zca)
|16-bit compressed base instructions; expanded to 32-bit by `jv32_rvc` before the Execute stage

|Zcb-style compressed operations
|`jv32_rvc` also expands the implemented compressed byte/halfword load/store and compact ALU encodings controlled by its internal `RVM23_EN=1` configuration. These operations are part of the supplied RTL configuration; individual expanded instructions still depend on the corresponding base/M capability being enabled.

|Zcmp (optional, `ZCMP_EN=1`)
|Implements `cm.push`, `cm.pop`, `cm.popret`, `cm.popretz`, `cm.mvsa01`, and `cm.mva01s`; enabled in the default configuration

|Zicsr
|CSR access instructions: CSRRW, CSRRS, CSRRC, CSRRWI, CSRRSI, CSRRCI

|Zifencei
|Instruction-fetch fence (`FENCE.I`): flushes the IF stage and re-fetches from PC+4

|Zba (optional, `RV32B_EN=1`)
|Address generation: `SH1ADD`, `SH2ADD`, `SH3ADD` — shift-and-add for scaled pointer arithmetic

|Zbb (optional, `RV32B_EN=1`)
|Basic bit manipulation: `CLZ`, `CTZ`, `CPOP`, `ANDN`, `ORN`, `XNOR`, `MIN`/`MAX`/`MINU`/`MAXU`, `SEXT.B`, `SEXT.H`, `ZEXT.H`, `REV8`, `ORC.B`, `ROL`, `ROR`, `RORI`

|Zbs (optional, `RV32B_EN=1`)
|Single-bit instructions: `BCLR`, `BEXT`, `BINV`, `BSET` and their immediate variants (`BCLRI`, `BEXTI`, `BINVI`, `BSETI`)
|===

NOTE: M-mode (M-mode) only. User mode and Supervisor mode are not implemented.

=== Pipeline Architecture

The core uses a single-issue 3-stage in-order pipeline:

[cols="1,2,4"]
.Pipeline Stages
|===
|Stage |Name |Function

|IF
|Instruction Fetch
|Generate PC; present address to TCM or AXI master; pass fetched instruction through `jv32_rvc` RVC expander

|EX
|Execute
|Decode opcode; read register file; execute ALU/branch/load-address/store-address/CSR; detect hazards; compute branch target; AMO state machine

|WB
|Writeback
|Receive memory response; write result to register file; handle exceptions; redirect pipeline on branch/jump/exception/MRET/interrupt
|===

=== Forwarding and Hazards

[cols="1,1,3"]
.Pipeline Hazard Handling
|===
|Hazard |Type |Description

|RAW (register read-after-write)
|Forwarding
|WB result forwarded to EX operand inputs in the same cycle. No stall required for ALU→ALU dependency.

|Load-use
|Stall (1 cycle)
|Load in EX presents address; data arrives in WB. The following EX-stage instruction must stall 1 cycle waiting for WB to complete. IF is also held.

|Branch / Jump misprediction
|Flush (1 cycle)
|When EX detects a taken branch or unconditional jump, the IF instruction in flight is squashed (1 pipeline bubble).

|Multi-cycle ALU (mul/div/shift)
|Stall / partial overlap
|Without scoreboard dispatch, multi-cycle operations stall EX/IF until completion. With scoreboard active (`SCOREBOARD_EN=1` and multiply actually multi-cycle), one outstanding `MUL` can run in a dedicated slot while younger independent, non-commit-sensitive instructions continue. `DIV/REM` remain blocking.

|Scoreboard issue gating (`MUL` non-blocking path)
|Issue stall (selective)
|Issue is blocked on RAW (`rs1`/`rs2` busy), WAW (`rd` busy), structural (slot already occupied), or commit-sensitive younger instruction while slot is active. Retirement remains strictly in-order through WB arbitration.

|AMO (LR/SC, AMO operations)
|Stall
|Two-phase read-modify-write sequence: EX issues AXI read, waits for response (LOAD_WAIT), then issues AXI write, waits for B-channel (STORE_WAIT). Pipeline stalls throughout.

|FENCE / FENCE.I
|No-op / Fetch synchronization
|`FENCE` is decoded but treated as a no-op. `FENCE.I` redirects to the sequential PC, flushes the RVC/instruction-prefetch path, discards an in-flight stale AXI instruction response, and suppresses the first stale registered TCM response after the redirect.
|===

NOTE: `FENCE.I` is the instruction-fetch synchronization mechanism implemented by this core. `jv32_top` contains a FENCE.I-specific stale-response suppressor so that an IRAM instruction modified by a preceding TCM store is re-fetched instead of consuming the registered pre-write SRAM response. `FENCE.I` does not add general data-memory ordering semantics; `FENCE` remains a no-op. `sw/fencei_smc` verifies that every store before `FENCE.I` — including sub-word writes and writes issued while the TCM store queue is full — is visible to the subsequent instruction fetch. `sw/mem_ordering` verifies that `FENCE` never needs to add ordering on the current configuration (program order is already preserved across TCM↔TCM and TCM↔MMIO).

NOTE: `WFI` is also decoded but treated as a no-op in `jv32_core`. It does not stall the hart or enter a physical low-power state.

=== Atomic Operation Semantics

When `AMO_EN=1`, the decoder accepts the AMO opcode with `funct3=010` and the core executes LR.W, SC.W, and the implemented AMO.W operations through the atomic state machine.

==== LR/SC Reservation

The RTL uses a single reservation consisting of `lr_valid` and the exact 32-bit address captured when LR.W completes successfully.

* LR.W returns the loaded word and records the LR address.
* SC.W succeeds only when `lr_valid=1` and the SC address exactly matches the saved LR address.
* Successful SC.W returns `0`.
* SC.W without a matching reservation returns `1` and does not issue the store.
* Executing *any* SC.W invalidates the reservation, whether it succeeds or fails. A failing SC.W (address mismatch, or no live reservation) clears `lr_valid` in the same cycle; a matching SC.W clears it when the store transaction completes. This matches the RISC-V A-extension requirement that "regardless of success or failure, executing an SC.W instruction invalidates any reservation held by this hart".
* Ordinary loads, stores, traps, interrupts, and unrelated AMO operations by the hart itself do not clear `lr_valid`. For a single-hart system this is a legal implementation choice; a later SC.W is still bounded because the first SC.W in program order clears the reservation.
* A debug-module memory write — SBA or an abstract Access Memory command — to the reserved word invalidates the reservation on the next cycle, so an SC.W paired with an LR.W that the debugger overwrote fails. The comparison is word-granular and on canonical (de-aliased) addresses.

`aq` / `rl` bits on atomics are decoded but do not change core behaviour: the in-order single-issue pipeline and store queue already retire memory and I/O operations in an order at least as strong as every acquire/release case on this single-hart configuration (verified by `sw/mem_ordering`).

==== AMO Encoding Scope

The supported AMO.W operations are `AMOSWAP`, `AMOADD`, `AMOXOR`, `AMOAND`, `AMOOR`, `AMOMIN`, `AMOMAX`, `AMOMINU`, and `AMOMAXU`, plus LR.W and SC.W.

The decoder validates `AMO_EN`, requires `funct3=010`, and WARL-checks `funct5`: only the eleven architecturally defined encodings above are accepted. Every other `funct5` value under the AMO opcode raises an illegal-instruction exception and issues no memory transaction.

==== Atomic Alignment

All implemented atomic operations are word operations and require a naturally aligned 32-bit address. A misaligned LR.W / SC.W / AMO.W address is detected in the EX stage and raises an address-misaligned exception before any memory transaction is issued: cause 4 (load address misaligned) for LR.W, and cause 6 (store/AMO address misaligned) for SC.W and every AMO.W. `mtval` holds the faulting address.

=== Control-Flow Prediction

When `BP_EN=1` (default), the front end combines static BTFNT conditional-branch prediction, one-entry last-branch reuse, JAL predecode, and the optional Return Address Stack (RAS). `BP_EN=0` disables these speculative front-end redirects.

==== Conditional Branch Prediction

For a conditional branch, the front end applies the following prediction rules:

. A valid one-entry last-branch (`L0`) hit for the same branch PC reuses the most recently resolved taken target.
. Otherwise, a backward branch (negative B-immediate) is predicted taken.
. A forward branch is predicted not taken.
. EX resolves the actual branch condition. A mismatch between the prediction and the resolved result redirects the fetch PC and flushes the speculative path.

The L0 entry is updated whenever a branch resolves and records that branch PC, resolved target, and whether the branch was taken. This allows a recently observed forward-taken branch to be predicted taken even though the normal BTFNT rule predicts forward branches as not taken.

When `BP_EN=0`, conditional branches are predicted not taken and a taken branch redirects from EX.

==== JAL

The front end recognizes JAL after RVC expansion and computes its PC-relative target before the instruction reaches EX. When front-end prediction is active, the fetch path redirects directly to that target. EX still computes the architectural JAL target and link value.

The architectural link address is `PC + 2` for a compressed call expanded by the RVC front end and `PC + 4` for a 32-bit JAL/JALR instruction.

==== JALR

JALR computes the architectural target in EX as:

----
target = (rs1 + immediate) & ~1
----

Bit 0 of the target is therefore always cleared.

A general JALR is not target-predicted by BTFNT. Eligible return patterns can instead be predicted by the RAS. If a RAS prediction is absent or does not match the EX-computed target, EX redirects to the computed JALR target.

==== Return Address Stack

The RAS is active only when `BP_EN=1`, `RAS_EN=1`, and `RV32E_EN=0`. It is a two-entry circular structure.

* **Push**: JAL or JALR with `rd` equal to `x1` (`ra`) or `x5` (`t0`) pushes the sequential return address.
* **Pop**: JALR with `rs1` equal to `x1` or `x5` and `rd` not equal to either link register uses and removes the current RAS top when the stack is non-empty.
* **Push + pop**: a JALR pattern that both reads and writes a link register is treated as a coroutine-style operation; the current top entry is replaced while the RAS pointer is unchanged.
* **Empty RAS**: no speculative return redirect is made.
* **Non-speculative redirect**: exception, MRET, or interrupt redirect clears the RAS state.
* **Branch correction and FENCE.I**: these redirects do not clear the RAS.

A RAS prediction is only speculative. EX always computes the JALR target and corrects the fetch path if the predicted return address is wrong.

=== RTL Operation Timing

The following timing statements are derived from the current RTL. They are not benchmark results and do not define a system-level performance guarantee.

[cols="2,4"]
.RTL Operation Timing
|===
|Operation |RTL Behavior

|TCM read
|The SRAM uses a registered read path. A granted read returns data on the following clock cycle.

|Load-use dependency
|The dependent instruction incurs one pipeline stall cycle.

|Conditional branch
|A correct BTFNT prediction requires no EX-stage correction flush. A misprediction causes one EX-stage correction/flush cycle.

|`BP_EN=0` taken branch
|A taken branch requires an EX-stage redirect because no taken prediction is made.

|Multiply
|`FAST_MUL=1` selects the fast multiply datapath. `FAST_MUL=0` selects the iterative implementation. `MUL_MC` further controls the fast multiply implementation.

|Divide
|`FAST_DIV=1` selects the fast divide datapath. `FAST_DIV=0` selects the iterative implementation.

|Shift
|`FAST_SHIFT=1` selects the barrel shifter. `FAST_SHIFT=0` selects the iterative shifter.

|IRAM contention
|A D-side IRAM access has priority over instruction fetch when both require the shared IRAM port.

|External AXI transaction
|No fixed latency is specified. Completion depends on the connected interconnect and target.
|===

This datasheet does not define typical CPI, benchmark performance, interrupt-entry latency, or maximum clock frequency. Those values depend on the selected RTL parameters, software workload, memory placement, external-system latency, synthesis target, and physical implementation.

=== CSR (Control and Status Registers)

CSR instructions are checked by the decoder before execution. Access to an unknown CSR is illegal. A write attempt to a read-only CSR is illegal; CSRRS/CSRRC and their immediate forms remain read-only accesses when the source value is zero. The core implements only the CSR addresses listed in this datasheet.

The core implements M-mode CSRs and CLIC-related CSRs. `misa` reports the MISA-visible base/standard extension bits implemented by `jv32_csr`; separately parameterized Zba/Zbb/Zbs and Zcmp support is not encoded in `misa`.

[cols="1,2,1,3"]
.Implemented CSRs
|===
|Address |Name |Access |Description

|0x300
|mstatus
|R/W
|Machine status: MIE[3], MPIE[7], MPP[12:11]=11 (M-mode always)

|0x301
|misa
|R/O
|ISA and extensions. Default value: `0x4000_1105` (RV32IMAC). The value changes with the configured ISA parameters.

|0x304
|mie
|R/W
|Machine interrupt-enable. Only MSIE[3], MTIE[7], and MEIE[11] are writable; other bits read as zero.

|0x305
|mtvec
|R/W
|Machine trap-handler base. The RTL preserves only mode bit 0: `0` = Direct and `1` = Vectored. Bit 1 is forced to zero. CLIC vectoring uses `mtvt` independently.

|0x307
|mtvt
|R/W
|CLIC vector table base address. The RTL forces bits [5:0] to zero, giving 64-byte alignment.

|0x310
|mstatush
|R/O
|Upper machine-status view; returns zero in this RV32 implementation

|0x320
|mcountinhibit
|R/W
|Counter control: CY[0] inhibits `mcycle`; IR[2] inhibits `minstret`

|0x340
|mscratch
|R/W
|Machine scratch register (software use)

|0x341
|mepc
|R/W
|Machine exception program counter. Bit 0 is forced to zero on CSR writes.

|0x342
|mcause
|R/W
|Machine trap cause: bit[31]=interrupt flag, bits[30:0]=cause code

|0x343
|mtval
|R/W
|Machine trap value (faulting address for memory exceptions, 0 otherwise)

|0x344
|mip
|R/O
|Machine interrupt-pending: MSIP[3], MTIP[7], MEIP[11]

|0x345
|mnxti
|R/W
|CLIC next-interrupt: reads the vector address (`mtvt + 4*id`) of the highest-priority pending CLIC interrupt with level > `mintthresh`; returns 0 if no such interrupt is pending. A write (e.g. `csrrsi mnxti, 0`) also atomically claims the interrupt: updates `mcause`, sets `mintstatus.mil`, and re-enables `MIE`, allowing the handler to branch directly to the returned address (software-assisted tail-chain).

|0x347
|mintthresh
|R/W
|CLIC interrupt threshold (8-bit): only CLIC interrupts with level > mintthresh are taken

|0xB00
|mcycle
|R/W
|Machine cycle counter (lower 32 bits)

|0xB02
|minstret
|R/W
|Machine instructions-retired counter (lower 32 bits)

|0xB80
|mcycleh
|R/W
|Machine cycle counter (upper 32 bits)

|0xB82
|minstreth
|R/W
|Machine instructions-retired counter (upper 32 bits)

|0xC00
|cycle
|R/O
|Unprivileged alias of mcycle (lower 32 bits)

|0xC01
|time
|R/O
|Unprivileged alias (lower 32 bits; maps to CLIC mtime)

|0xC02
|instret
|R/O
|Unprivileged alias of minstret (lower 32 bits)

|0xC80
|cycleh
|R/O
|Unprivileged alias of `mcycleh`

|0xC81
|timeh
|R/O
|Upper 32 bits of CLIC `mtime`

|0xC82
|instreth
|R/O
|Unprivileged alias of `minstreth`

|0xF11
|mvendorid
|R/O
|Vendor ID (returns `0x0000_0000`)

|0xF12
|marchid
|R/O
|Architecture ID (returns `0x0000_0000`)

|0xF13
|mimpid
|R/O
|Implementation ID (returns `0x0000_0001`)

|0xF14
|mhartid
|R/O
|Hardware thread ID (returns `0x0000_0000`)

|0xFB1
|mintstatus
|R/O
|CLIC interrupt status: bits[31:24] = mil (machine interrupt level currently servicing)
|===

=== Exception and Interrupt Handling

==== Exception Types

The table lists exceptions that are actively generated by the current RTL. The core uses 16-bit instruction alignment when compressed instructions are enabled.

[cols="1,2,4"]
.Exception Causes (mcause[31]=0)
|===
|Code |Name |Description

|1
|Instruction access fault
|I-fetch AXI error response (`SLVERR` or `DECERR` from the AXI master)

|2
|Illegal instruction
|Undefined, unsupported, disabled-by-parameter, or otherwise rejected instruction encoding. `mtval` receives `orig_instr`; for compressed instructions this preserves the original compressed encoding supplied by the RVC front end.

|3
|Breakpoint
|EBREAK instruction executed

|4
|Load address misaligned
|Load address not naturally aligned to the access size, including a misaligned LR.W address

|5
|Load access fault
|Load AXI error response

|6
|Store address misaligned
|Store address not naturally aligned to the access size, including a misaligned SC.W or AMO.W address

|7
|Store/AMO access fault
|Store, SC, or AMO write-side AXI error response. Atomic read-side failures are reported through the memory-fault path based on the active AMO transaction phase.

|11
|Environment call from M-mode
|ECALL executed in M-mode
|===

Instruction-address-misaligned exceptions cannot arise from ordinary control transfers in the supported configurations: compressed instructions are always present (`IALIGN=16`), JAL/branches encode halfword offsets, and JALR clears bit 0. Integrators must provide a halfword-aligned reset vector. The CSR test separately verifies cause-0 trap-state capture.

NOTE: The EX-stage misalignment check covers normal loads and stores and, in this RTL, also LR.W / SC.W / AMO.W. A misaligned atomic raises cause 4 (LR.W) or cause 6 (SC.W, AMO.W) with `mtval` = faulting address, and no memory transaction is issued.

==== Exception Detection Priority

For an instruction reaching EX, the core checks synchronous conditions in this order:

. instruction-fetch access fault;
. illegal instruction (includes reserved AMO `funct5` encodings);
. EBREAK that is not redirected into Debug Mode;
. ECALL;
. load/store/AMO address misalignment (normal loads and stores, and LR.W / SC.W / AMO.W).

The first matching condition is recorded in the EX/WB pipeline state. Data-memory AXI faults are detected later in WB and become load/store access-fault exceptions. Because illegal-instruction ranks above the misalignment check, a reserved AMO encoding with a misaligned address reports illegal instruction.

==== Redirect and Trap Priority

At the WB redirect point, the current RTL applies the following priority:

. synchronous exception or data-memory access fault;
. MRET;
. pending interrupt;
. EX-stage control-flow redirect such as a branch correction, JALR correction, or FENCE.I.

A pending interrupt therefore does not override an older synchronous exception or an MRET already in WB. When an interrupt is accepted, the WB instruction is canceled rather than retired; its PC is saved as the interrupt `mepc` so that it is re-executed after MRET.

During single-step execution, normal interrupt acceptance is suppressed while the step is pending. CLIC MRET tail chaining is handled separately: if MRET executes while a CLIC interrupt above `mintthresh` is pending, the core redirects directly to the next CLIC vector instead of first returning to `mepc`.

==== Interrupt Types

[cols="1,2,4"]
.Interrupt Causes (mcause[31]=1)
|===
|Code |Name |Source

|3
|Machine software interrupt
|CLIC MSIP register (`msip[0]`)

|7
|Machine timer interrupt
|CLIC: `mtime >= mtimecmp`

|11
|Machine external interrupt
|CLIC: any enabled pending external IRQ (`ext_irq_i[15:0]`) with level > `mintthresh`
|===

==== Trap Handling Sequence

On exception or interrupt:

1. `mstatus.MPIE ← mstatus.MIE`; `mstatus.MIE ← 0` (disable interrupts)
2. `mstatus.MPP ← 2'b11` (M-mode)
3. `mepc ← PC of interrupted/excepted instruction`
4. `mcause ← {1'b1/1'b0, cause_code}`
5. `mtval ← faulting_address` (or 0)
6. PC redirected to `mtvec` (direct mode) or `mtvec + 4*cause` (vectored mode)

CLIC vectored interrupts redirect to `mtvt + 4*clic_id` (vector table indexed by the winning interrupt's ID) and set `mintstatus.mil` to the claimed interrupt level.

Normal MRET restores: `mstatus.MIE ← mstatus.MPIE`; `mstatus.MPIE ← 1`; PC ← `mepc`.

==== Tail-Chaining (Hardware)

If, at the moment `mret` retires, a CLIC external interrupt is pending with level > `mintthresh`, the core performs a **tail-chain** rather than a full context restore:

* Fetch is redirected to `mtvt + 4*clic_id` (the next handler) — zero overhead cycles.
* `mstatus.MIE` remains 0 (already in a new handler).
* `mstatus.MPIE` is set to 1 (so the eventual chain-terminating `mret` re-enables MIE).
* `mepc` is unchanged (still holds the preempted task's return address).
* `mcause` is updated to `0x8000_000B` (machine external interrupt).
* `mintstatus.mil` is updated to the new interrupt's level.

Tail-chaining eliminates the push/pop overhead between consecutive ISRs of equal or lower priority and is fully transparent to software: the same trap handler is re-entered for each chained interrupt.

==== Software-Assisted Tail-Chain (`mnxti`)

Within a CLIC handler, software can voluntarily tail-chain to the next pending interrupt by reading `mnxti`:

[source,c]
----
uintptr_t next_pc = csr_swap(mnxti, 0);
if (next_pc) goto (void *)next_pc;   // chain to next handler
----

When `mnxti` is written (any write, e.g. `csrrsi mnxti, 0`) and a qualifying interrupt is pending:

* `mcause` and `mintstatus.mil` are atomically updated to the new interrupt.
* `mstatus.MIE` is re-enabled (nested interrupt within the handler).
* The read value is `mtvt + 4*clic_id` of the newly claimed interrupt (or 0 if none).

Software branches to the returned address to begin serving the next interrupt without an `mret`/re-entry cycle.

<<<

== TCM Specification

=== Overview

Both IRAM and DRAM are physically located inside `jv32_top` as a single 32-bit wide `sram_1rw` instance per region, with 4-bit byte-enable write support:

[cols="1,3"]
.TCM Configuration
|===
|Parameter |Default Value

|IRAM base address
|`IRAM_BASE = 32'h8000_0000`

|IRAM size
|`IRAM_SIZE = 131072` bytes (128 KB); power-of-2

|DRAM base address
|`DRAM_BASE = 32'h9000_0000`

|DRAM size
|`DRAM_SIZE = 131072` bytes (128 KB); power-of-2

|Read latency
|1 cycle (registered output: addr at cycle N → data at cycle N+1)

|Write behavior
|Selected byte lanes are written on the active clock edge. `sram_1rw` uses NO_CHANGE read-during-write behavior: the registered read output is not updated on a write cycle.

|Data width
|32 bits; 4-bit byte-enable write (`we[3:0]`); each byte lane independently writable

|DPI hierarchy (IRAM)
|`u_soc.u_jv32.u_iram.mem[word_index]` (byte access: `[byte_lane*8+:8]`, lane = 0..3)

|DPI hierarchy (DRAM)
|`u_soc.u_jv32.u_dram.mem[word_index]` (byte access: `[byte_lane*8+:8]`, lane = 0..3)
|===

=== Access Priorities

When multiple requestors target the same SRAM in the same cycle:

[cols="1,1,3"]
.SRAM Arbitration Priority
|===
|Priority |Requestor |Notes

|1 (highest)
|Core D-path
|D-access (load, store, AMO) always wins

|2
|Core I-path (I-fetch)
|If D-path does not need the SRAM this cycle

|3 (lowest)
|AXI Slave
|Only granted when neither I-path nor D-path accesses the target SRAM
|===

=== TCM Timing

[cols="1,3"]
.Timing Summary
|===
|Transaction |Behaviour

|I-fetch (IRAM hit)
|Addr presented at cycle N; instruction available at cycle N+1 (1-cycle latency)

|D-read (IRAM or DRAM hit)
|Addr presented at cycle N; data available at cycle N+1; pipeline inserts 1-cycle load stall

|Core D-write (IRAM or DRAM hit)
|Selected byte lanes are written on the active clock edge. This is a core-local TCM access, not an AXI transaction.

|IRAM contention (D + I both need IRAM)
|D-path wins; I-fetch stalls 1 extra cycle

|Stale I-fetch after redirect
|`imem_flush` signal (= `rvc_flush`) gates the TCM response; cycle N+1 response is suppressed when a branch/exception redirect occurred at cycle N
|===

=== TCM AXI Slave Semantics

The TCM slave path uses `axi_ram_ctrl` and the shared single-port SRAM.

* AW and W may arrive independently; each channel is held until both parts of the write transaction are available.
* `WSTRB[3:0]` directly controls the four SRAM byte write enables.
* The address presented to SRAM is `addr >> 2`; low address bits `[1:0]` are not checked. Software and external masters must therefore issue naturally aligned accesses.
* A read returns AXI `OKAY`; no address-alignment error is generated by `axi_ram_ctrl`.
* If a RAM controller instance is configured with `WR_EN=0`, writes return `SLVERR`; writable TCM instances return `OKAY`.
* SRAM contents are not initialized by `sram_1rw` reset. Program/data initialization is supplied by the simulation/FPGA integration flow.

=== ELF Loading (Pre-Simulation)

For Verilator simulation, program images are loaded directly into TCM SRAM arrays via DPI-C before simulation starts. The testbench `tb_jv32_soc.cpp` calls `load_program()` from `elfloader.cpp`:

[source,cpp]
----
// Load ELF into TCM via DPI mem_write_byte
void mem_write_byte(uint32_t addr, uint8_t data) {
    if (addr >= IRAM_BASE && addr < IRAM_BASE + IRAM_SIZE) {
        uint32_t offset = addr - IRAM_BASE;
        uint32_t word   = offset >> 2;
        uint32_t bank   = offset & 3;
        // Writes: u_soc.u_jv32.u_iram.mem[word][bank*8+:8]
    } else if (addr >= DRAM_BASE && addr < DRAM_BASE + DRAM_SIZE) {
        uint32_t offset = addr - DRAM_BASE;
        uint32_t word   = offset >> 2;
        uint32_t bank   = offset & 3;
        // Writes: u_soc.u_jv32.u_dram.mem[word][bank*8+:8]
    }
}
----

<<<

== Peripheral Specifications

=== UART (Universal Asynchronous Receiver/Transmitter)

==== UART Overview

The UART peripheral provides serial communication with configurable baud rate and 8N1 format.

[cols="1,3"]
.UART Features
|===
|Feature |Specification

|Base Address
|`0x2001_0000`

|Aperture
|256 B (`0x2001_0000`–`0x2001_00FF`); valid register offsets are `0x00`–`0x18`. Accesses from `0x1C` to `0xFF` return `SLVERR`.

|Data Format
|8 bits, no parity, 1 stop bit (8N1)

|Baud Rate
|The reset/default baud rate is selected by `CLK_FREQ` and `BAUD_RATE`. Software can change the runtime divisor by writing offset `0x10`.

|TX FIFO Depth
|16 entries (parameterized: `FIFO_DEPTH`, must be power-of-2)

|RX FIFO Depth
|16 entries (same as TX)

|Interrupt
|Level-triggered; asserted when `(IE & IS) != 0`
|===

==== UART Register Map

Reset clears IE, CTRL, and FIFO counts. STATUS reads zero and IS reads `0x2` (TX empty). BAUDDIV resets to `CLK_FREQ / BAUD_RATE - 1`; CAPABILITY reflects the configured FIFO depth and version 1. Reading an empty DATA register does not provide a defined byte.

[cols="1,2,1,4"]
.UART Registers (base `0x2001_0000`)
|===
|Offset |Name |Access |Description

|0x00
|DATA
|R/W
|**Write**: pushes `wdata[7:0]` to the TX FIFO only when `WSTRB[0]=1` and the FIFO is not full. A write while the FIFO is full is silently dropped and still receives `OKAY`. +
**Read**: returns the byte at the RX FIFO read pointer and pops it only when the RX FIFO is non-empty. Software must check `STATUS.rx_ready` before reading DATA; the value returned while the FIFO is empty is not a defined data value.

|0x04
|STATUS
|R/O
|**[0]** `tx_busy` — TX FIFO full / cannot accept data (same signal as `tx_full`) +
**[1]** `tx_full` — TX FIFO full flag +
**[2]** `rx_ready` — RX FIFO has data available (not empty) +
**[3]** `rx_full` — RX FIFO full. An incoming received byte is silently dropped while this condition is true.

NOTE: bits[1:0] reflect the same underlying `txf_full` signal. Bit 0 is therefore not a transmitter-shift-register busy indication; it only indicates that the TX FIFO cannot accept another byte.

|0x08
|IE (Interrupt Enable)
|R/W
|**[0]** `rx_ready_ie` — enable RX-ready interrupt +
**[1]** `tx_empty_ie` — enable TX empty interrupt. +
Only `WSTRB[0]` enables an IE write; the implemented value is `wdata[1:0]`.

|0x0C
|IS (Interrupt Status)
|R/O
|**[0]** `rx_ready` — RX FIFO not empty (level-triggered) +
**[1]** `tx_empty` — TX FIFO empty (level-triggered)

|0x10
|LEVEL / BAUDDIV
|R/W
|**Read**: **[15:0]** `rx_count` — number of bytes in RX FIFO; **[31:16]** `tx_count` — number of bytes in TX FIFO. +
**Write**: **[15:0]** runtime baud-rate divisor (`CLKS_PER_BIT − 1`); upper 16 bits are ignored. `WSTRB[0]` enables bits [7:0] and `WSTRB[1]` enables bits [15:8]; a zero-strobe write leaves the divisor unchanged. The divisor takes effect immediately, so changing it during an active TX or RX character can corrupt that character.

|0x14
|CTRL
|R/W
|**[0]** `loopback_en` — internal TX→RX loopback. Only `WSTRB[0]` enables a CTRL write.

|0x18
|CAPABILITY
|R/O
|**[7:0]** TX FIFO depth (= `FIFO_DEPTH` parameter, default 16) +
**[15:8]** RX FIFO depth (= `FIFO_DEPTH` parameter, default 16) +
**[31:16]** UART version (`0x0001`); combined: `{16'h0001, 8'(FIFO_DEPTH), 8'(FIFO_DEPTH)}`
|===

NOTE: Interrupt asserts when `(IE & IS) != 0`. There is no explicit interrupt-clear register; the interrupt de-asserts automatically when the FIFO condition clears (e.g. RX FIFO drained, TX FIFO refilled).

NOTE: The UART performs range checking using address bits `[7:2]`. Software should use the documented naturally aligned word offsets. Misaligned addresses within a valid word range are not part of the programming interface and may return `OKAY` without accessing the intended register.

==== Baud Rate Configuration

The reset value of the baud-rate divisor is derived at elaboration time:

----
CLKS_PER_BIT = CLK_FREQ / BAUD_RATE
baud_div_r   = CLKS_PER_BIT - 1
----

After reset, software may change `baud_div_r` by writing the lower 16 bits of UART offset `0x10`. The new bit period is `baud_div_r + 1` system-clock cycles.

**RTL elaboration constraint**: `CLKS_PER_BIT >= 4`. The non-synthesis assertion in `axi_uart.sv` rejects smaller values.

This datasheet does not define a production baud-rate margin beyond that RTL constraint. Board-level clock tolerance, UART peer tolerance, and implementation timing must be verified for the target system.

[cols="1,1,1"]
.Common Baud Rates at 100 MHz
|===
|Baud Rate |CLKS_PER_BIT |Notes

|9600
|10417
|Very slow, large margin

|115200
|868
|Standard; large margin

|921600
|109
|Fast; good margin

|1 Mbaud
|100
|Round number; good margin

|12.5 Mbaud
|8
|Example configuration

|25 Mbaud
|4
|Minimum divisor accepted by the RTL elaboration check
|===

WARNING: Configurations with `CLKS_PER_BIT < 4` violate the RTL elaboration constraint.

==== Interrupt Behavior

* **RX interrupt** (`IS[0]`): Fires whenever RX FIFO is non-empty. Stays asserted until all bytes are consumed.
* **TX interrupt** (`IS[1]`): Fires whenever TX FIFO is empty. Stays asserted until software writes more data.

==== External Pins

[cols="1,1,4"]
.UART Pins
|===
|Signal |Direction |Description

|`uart_tx_o`
|Output
|UART transmit data

|`uart_rx_i`
|Input
|UART receive data (asynchronous to system clock)
|===

---

=== Local Interrupt Controller (`axi_clic`)

==== Overview

The `axi_clic` block combines CLINT-style timer/software-interrupt registers with a 16-line implementation-specific external interrupt controller. It provides the internal sideband signals required by JV32 (`clic_irq`, `clic_id`, `clic_level`, and `clic_prio`), but it does not implement the complete standard RISC-V CLIC memory-mapped register model. Software should use the register map defined in this datasheet, not a generic CLIC driver.

[cols="1,3"]
.CLIC Features
|===
|Feature |Specification

|Base Address
|`0x0200_0000`

|Aperture
|2 MB crossbar aperture. The RTL implements MSIP, MTIME, MTIMECMP, and `NUM_IRQ` CLICINT words; with the default `NUM_IRQ=16`, only CLICINT[0]–CLICINT[15] are implemented.

|Timer/software-interrupt layout
|Implements the JV32 `msip`, `mtime`, and `mtimecmp` offsets documented below; treat these as the platform ABI for this RTL

|Timer Counter
|64-bit free-running `mtime`, increments every clock cycle

|Timer Compare
|64-bit `mtimecmp`; timer IRQ fires when `mtime >= mtimecmp`

|Software Interrupt
|`msip[0]`: write 1 to assert, write 0 to clear

|External Interrupt Lines
|16 (`NUM_IRQ=16`), routed from `ext_irq_i[15:0]`, each with individual enable/level/priority via `CLICINT[n]`

|Interrupt Outputs
|`timer_irq_o`, `software_irq_o`, `clic_irq_o` (aggregated external), `clic_level_o[7:0]`, `clic_prio_o[7:0]`, `clic_id_o[4:0]` (winning IRQ index; used by CPU to compute `mtvt + 4*id`)
|===

==== Register Map

[cols="1,2,1,4"]
.Local Interrupt Controller Registers (base `0x0200_0000`)
|===
|Offset |Name |Access |Description

|0x0000
|MSIP
|R/W
|Machine Software Interrupt Pending. `[0]=msip`: write 1 to assert software interrupt; write 0 to clear. A write changes this bit only when `WSTRB[0]=1`; other byte lanes and zero-strobe writes leave it unchanged. Verified by `tb_clic`.

|0x4000
|MTIME_LO
|R/W
|`mtime[31:0]` — lower 32 bits of 64-bit free-running timer

|0x4004
|MTIME_HI
|R/W
|`mtime[63:32]` — upper 32 bits

|0x4008
|MTIMECMP_LO
|R/W
|`mtimecmp[31:0]` — lower 32 bits of timer compare

|0x400C
|MTIMECMP_HI
|R/W
|`mtimecmp[63:32]` — upper 32 bits. Timer IRQ fires when `mtime >= mtimecmp`.

|0x1000 + n×4
|CLICINT[n] (n=0..15)
|R/W
|Per-interrupt control word (32-bit): +
**[0]** `ip` (read-only) — interrupt pending; reflects `ext_irq_i[n]` (ORed with `uart_irq` for n=0) +
**[1]** `ie` — interrupt enable (1=enabled) +
**[7:2]** reserved — read as 0, writes ignored +
**[15:8]** reserved — read as 0, writes ignored (CLIC `attr` field **not implemented** in this RTL) +
**[23:16]** `ctl` — interrupt control value (8-bit; higher value wins arbitration and is also reported as the current level/priority) +
**[31:24]** reserved — read as 0. +
Writes to `ie` are applied only when `WSTRB[0]=1`; writes to `ctl` are applied only when `WSTRB[2]=1`.
|===

NOTE: MSIP, MTIME, and MTIMECMP use the familiar single-hart CLINT-style offsets used by this design.

NOTE: `axi_clic` always returns AXI `OKAY` for reads and writes. Unsupported offsets read as zero and writes have no effect. Software therefore must not use the AXI response code to discover whether a CLIC offset is implemented.

==== Timer Operation

The 64-bit `mtime` counter increments by 1 every system clock cycle. The timer interrupt fires when `mtime >= mtimecmp` (unsigned 64-bit comparison), **unless `mtimecmp` equals its reset sentinel value `0xFFFF_FFFF_FFFF_FFFF`** (startup guard — prevents a spurious interrupt before software programs a compare value). Software clears the timer interrupt by writing a new, larger value to `mtimecmp`. MTIME and MTIMECMP writes honor byte strobes. A zero-strobe MTIME write does not pause the counter. These behaviors are checked by `tb_clic`.

[source,c]
----
// Coherent 64-bit read on RV32; retry if the low word rolls over.
uint32_t hi, lo, hi_again;
do {
    hi = CLIC_MTIME_HI;
    lo = CLIC_MTIME_LO;
    hi_again = CLIC_MTIME_HI;
} while (hi != hi_again);
uint64_t now = ((uint64_t)hi << 32) | lo;
uint64_t cmp = now + 100000;   // 1 ms at 100 MHz
// Comparator write order exercised by tb_clic:
CLIC_MTIMECMP_LO = 0xFFFFFFFFu;
CLIC_MTIMECMP_HI = (uint32_t)(cmp >> 32);
CLIC_MTIMECMP_LO = (uint32_t)cmp;
----

Use volatile MMIO accesses. The low-word sentinel, high-word update, and final
low-word update avoid exposing a partially assembled compare value. Changing
an already expired deadline does not erase an interrupt already accepted by
the processor.

==== Software Interrupt Operation

Write `MSIP[0] = 1` to assert machine software interrupt immediately, `0` to clear.

==== External Interrupt Operation

Each `ext_irq_i[n]` input is gateable via `CLICINT[n].ie`. When any enabled and pending external interrupt has `ctl` (priority level) greater than the current `mintthresh` CSR value, `clic_irq_o` is asserted to the core as an M-mode external interrupt.

When a CLIC interrupt is eligible (`clic_irq` asserted above `mintthresh`) and global machine interrupts are enabled, the CSR interrupt selector gives the CLIC path precedence over the conventional MEI/MTI/MSI inputs. The CLIC asserts `clic_id_o[4:0]` with the index of the winning pending enabled interrupt. Arbitration scans interrupt IDs in ascending order and replaces the current winner only when a strictly greater `clicint_ctl` value is found. Therefore, when two pending interrupts have the same `ctl` value, the lower interrupt ID wins. Both `clic_level_o[7:0]` and `clic_prio_o[7:0]` carry the same `clicint_ctl[winner]` value; this RTL does not implement separate level and priority fields. The CPU uses this to compute the handler address as `mtvt + 4*clic_id` (where `mtvt` is programmed to a 4-byte-pointer table). This happens automatically on interrupt entry and on hardware tail-chain at `mret`; software can also perform the same lookup by reading `mnxti`.

[NOTE]
**UART IRQ routing**: the UART `irq` output (asserted when `(IE & IS) != 0`) is OR'd into `ext_irq_i[0]` inside `jv32_soc` before being presented to the CLIC. The effective `CLICINT[0].ip` thus reflects `ext_irq_i[0] | uart_irq`. Software must enable `CLICINT[0].ie` and configure `CLICINT[0].ctl` to receive UART interrupts. The external `ext_irq_i[0]` SoC pin is still available and is ORed with the UART interrupt.

=== Magic Device (Simulation Only)

==== Magic Device Overview

The Magic Device provides simulation console I/O and simulation exit control.

WARNING: The Magic Device is for simulation only. It must not be synthesized for FPGA/ASIC production.

[cols="1,3"]
.Magic Device Features
|===
|Feature |Specification

|Base Address
|`0x4000_0000`

|Console Write
|Offset `0x0000`: write byte (bits[7:0]) to host `stdout`

|Exit Control
|Offset `0x0004`: HTIF-encoded exit. Write `(exit_code << 1) \| 1` to exit with the given code; `1` = pass (exit code 0). The RTL calls `sim_request_exit(value >> 1)`. Writing `0` is ignored.
|===

==== Magic Device Register Map

[cols="1,2,1,4"]
.Magic Device Registers (base `0x4000_0000`)
|===
|Offset |Name |Access |Description

|0x0000
|CONSOLE
|W/O
|Write character (low byte) to simulation `stdout`. Reads return 0.

|0x0004
|EXIT
|W/O
|HTIF-encoded exit control: `sim_request_exit(value >> 1)` is called when any non-zero value is written. Write `1` = pass (exit code 0); write `(code << 1) \| 1` = fail with `code`. Writing `0` has no effect.
|===

==== AXI Response Behavior

`axi_magic` compares addresses after clearing bits `[1:0]`; byte addresses within the 32-bit CONSOLE or EXIT word therefore select the same magic register. Recognized reads return zero with `OKAY`; unrecognized addresses return zero with `SLVERR`.

For writes, a one-hot `WSTRB` selects the corresponding byte from `WDATA`. Other strobe patterns use `WDATA[7:0]` for console-character extraction. EXIT uses the selected byte for one-hot byte writes and the full 32-bit `WDATA` for other write-strobe patterns.

==== Usage Example

[source,c]
----
#define MAGIC_CONSOLE  (*(volatile uint32_t *)0x40000000)
#define MAGIC_EXIT     (*(volatile uint32_t *)0x40000004)

void print_str(const char *s) {
    while (*s) MAGIC_CONSOLE = *s++;
}

void sim_pass(void) { MAGIC_EXIT = 1; }   // exit(0)
void sim_fail(int code) { MAGIC_EXIT = (code << 1) | 1; }
----

<<<

== AXI Interconnect and Bus Protocol

=== Protocol Scope

The integrated AXI interfaces implement the transaction behavior exposed by the supplied RTL. This datasheet documents the supported integration contract and does not imply support for AXI features that are absent from the module ports or control logic.

=== AXI4-Lite Overview

The JV32 SoC uses AXI4-Lite throughout (32-bit address, 32-bit data, no burst, no ID).

[cols="1,3"]
.AXI Protocol Summary
|===
|Feature |Specification

|Protocol
|AXI4-Lite (AMBA 4 subset: single-beat, no ARLEN/AWLEN/ARBURST, no IDs)

|Data Width
|32 bits

|Address Width
|32 bits

|Write Strobes
|4 bits (byte granularity)

|Response Codes
|`OKAY` (2'b00), `SLVERR` (2'b10), `DECERR` (2'b11)

|Crossbar Topology
|1 master and 4 decode targets in `jv32_soc`: UART, CLIC, Magic, and the external AXI catch-all target
|===

=== `jv32_top` AXI Master Port (`m_axi_*`)

The merged AXI master port carries all out-of-TCM traffic:

[cols="1,1,4"]
.AXI4-Lite Master Signals
|===
|Signal |Direction |Description

|`m_axi_araddr[31:0]`
|Output
|Read address channel: address

|`m_axi_arvalid`
|Output
|Read address valid

|`m_axi_arready`
|Input
|Read address ready (slave accepts)

|`m_axi_rdata[31:0]`
|Input
|Read data

|`m_axi_rresp[1:0]`
|Input
|Read response (`OKAY`/`SLVERR`/`DECERR`)

|`m_axi_rvalid`
|Input
|Read data valid

|`m_axi_rready`
|Output
|Read data ready (master accepts)

|`m_axi_awaddr[31:0]`
|Output
|Write address

|`m_axi_awvalid`
|Output
|Write address valid

|`m_axi_awready`
|Input
|Write address ready

|`m_axi_wdata[31:0]`
|Output
|Write data

|`m_axi_wstrb[3:0]`
|Output
|Write byte strobes

|`m_axi_wvalid`
|Output
|Write data valid

|`m_axi_wready`
|Input
|Write data ready

|`m_axi_bresp[1:0]`
|Input
|Write response

|`m_axi_bvalid`
|Input
|Write response valid

|`m_axi_bready`
|Output
|Write response ready
|===

=== `jv32_top` AXI Slave Port (`s_axi_*`)

The TCM slave port has the same signal set as the master port (with directions flipped). All `s_axi_*` signals are exposed as SoC-level ports (`s_tcm_*` prefix in `jv32_soc`).

=== Crossbar Architecture

The `axi_xbar` module implements a 1-to-N address-decoder crossbar:

* **Address decode**: `(addr & SLAVE_MASK[i]) == (SLAVE_BASE[i] & SLAVE_MASK[i])` for each slave in order; first match wins
* **Decode ordering**: slave indices are checked in ascending order and the first matching base/mask entry wins.
* **Crossbar-local decode error**: if no configured slave entry matches, the crossbar returns `DECERR` on both reads and writes.
* **SoC catch-all target**: the fourth `jv32_soc` decode entry uses base `0x0000_0000` and mask `0x0000_0000`, so every address not claimed by UART, CLIC, or Magic matches the external AXI target. In the default SoC integration, crossbar-local `DECERR` is therefore normally unreachable; the external target supplies the final response.
* **Protocol scope**: the exposed interconnect is AXI4-Lite and carries only single-beat transactions; there are no burst-length, burst-type, ID, or `RLAST` ports.

=== Bus State Machines (inside `jv32_top`)

The merged AXI master is implemented as a state machine with the following states:

[cols="1,3"]
.AXI Master State Machine
|===
|State |Description

|`BUS_IDLE`
|Both I-fetch and D-access in TCM or idle. In IDLE, D-bus out-of-TCM check has priority over I-bus.

|`DAR`
|D-bus AXI read address phase: `m_axi_araddr` set to D-bus address; wait for `arready`.

|`DR`
|D-bus AXI read data phase: wait for `m_axi_rvalid`; return data to core D-path.

|`DAW`
|D-bus AXI write address+data phase: issue both AW and W channels (simultaneous when possible).

|`DB`
|D-bus AXI write response: wait for `m_axi_bvalid`.

|`IAR`
|I-bus AXI read address phase: `m_axi_araddr` set to I-fetch PC; wait for `arready`.

|`IR`
|I-bus AXI read data phase: wait for `m_axi_rvalid`; return instruction to core I-path.
|===

<<<

== Debug and JTAG

=== Debug Architecture

When `JTAG_EN=1`, the SoC instantiates the JTAG TAP, RISC-V Debug Transport Module (DTM), Debug Module control logic, abstract-command engine, System Bus Access (SBA), and hardware trigger support.

The Debug Module implements a **RISC-V Debug Specification 1.0-oriented subset**. Static RTL review confirms the implemented register encodings and major flows listed below, but full specification conformance requires dedicated debug-compliance testing. In the current RTL, `dmstatus.version` reads 3 and `dtmcs.version` reads 1 (the DTM encoding shared by spec 0.13 and 1.0). Optional 1.0 features that JV32 does not implement read back as "absent": `dmstatus.hasresethaltreq` = 0 (no halt-on-reset), `dmstatus.confstrptrvalid` = 0 (no configuration string), `dtmcs.errinfo` = 0, and the `dmcs2`/`hawindow`/`confstrptr0-3` registers return 0. `dmstatus.ndmresetpending` tracks `dmcontrol.ndmreset`; `dmstatus.stickyunavail` = 0 (the single hart is always present). `nextdm` (DMI 0x1d) reads 0 — this is the only Debug Module.

The implementation spans two clock domains:

* The TAP and DMI register bank operate in the TAP clock domain.
* Debug command execution, register access, memory access, and core control operate in the system-clock domain.
* Clock-domain crossings use synchronizers, toggle handshakes, or stable-payload transfer mechanisms implemented in `jtag_tap.sv` and `jv32_dtm.sv`.

When `JTAG_EN=0`, the debug logic is not instantiated and the associated debug outputs are tied to inactive values.

=== JTAG TAP

The TAP uses a 5-bit instruction register.

[cols="1,1,3"]
.Supported JTAG Instructions
|===
|Instruction |IR Value |Behavior

|IDCODE
|`0x01`
|Shifts the 32-bit `IDCODE` value. The default RTL parameter is `0x1DEAD3FF`.

|DTMCS
|`0x10`
|Accesses the Debug Transport Module Control and Status register.

|DMI
|`0x11`
|Accesses the 41-bit DMI scan register: 7-bit address, 32-bit data, and 2-bit operation.

|BYPASS
|`0x1F`
|Selects the one-bit bypass register.

|Other IR values
|—
|Return zero on TDO and do not dispatch DMI operations. Only IR `0x1F` selects the one-bit BYPASS register.
|===

After TAP reset, the instruction register selects IDCODE.

=== DTMCS

The implemented DTMCS value reports:

[cols="2,2,3"]
.DTMCS Fields
|===
|Field |Value |Description

|`version`
|1
|DTM encoding used by RISC-V Debug Spec 0.13 and 1.0.

|`errinfo`
|0
|Optional; extended DMI error detail is not implemented.

|`abits`
|7
|DMI uses a 7-bit address field.

|`dmistat`
|0
|No persistent DMI status error is reported through this field.

|`idle`
|1
|The debugger should provide at least one Run-Test/Idle TCK cycle between DMI operations.
|===

`dmihardreset` and `dmireset` are decoded from the DTMCS scan register (not from the DMI shift register). Writing `dmihardreset` clears the TAP-domain DMI soft state, including the selected DMI address, DATA registers, COMMAND, abstract-command error state, ABSTRACTAUTO state, and SBA address/data shadow registers. It does not replace the SoC system reset. `dmireset` is accepted as a no-op: this DTM keeps `dmistat` constant at 0 and never reports a sticky DMI operation error, so there is no per-operation status for `dmireset` to clear.

=== DMI Register Map

Unlisted DMI addresses read as zero and ignore writes. Optional authentication, configuration-string pointers, halt-on-reset requests, multi-hart arrays, extra program-buffer words, and SBA address/data words above 32 bits are absent. `dmstatus.authenticated` is fixed at one. The directed test scans every unimplemented DMI address for read-as-zero/write-ignore behavior.

The DMI register bank implements the following addresses.

[cols="1,2,1,4"]
.Implemented DMI Registers
|===
|Address |Register |Access |Implemented Behavior

|`0x04`
|DATA0
|R/W
|Primary abstract-command data register and command result register.

|`0x05`
|DATA1
|R/W
|Secondary abstract-command data register. Access-memory commands use it as the memory address.

|`0x10`
|DMCONTROL
|R/W
|Implements `dmactive`, `ndmreset`, `haltreq`, `resumereq`, `hartreset`, `ackhavereset`, and `hartsello`. While `dmactive` is 0 the Debug Module is held in reset: the abstract-command and SBA engines return to idle and every DM register (DATA0/DATA1, COMMAND, PROGBUF, ABSTRACTAUTO, `abstractcs.cmderr`, the SBCS fields, SBADDRESS0/SBDATA0, and the DMCONTROL control bits `haltreq`/`resumereq`/`hartreset`/`ndmreset`/`hartsel`) takes its reset value. `dmactive` is the only DMCONTROL bit that can be written while `dmactive` is 0; other field writes in that same DMI transaction are discarded. The DMI transport itself (the selected DMI address and the TCK↔system-clock dispatch handshake) is not part of the Debug Module and is unaffected, so ordinary DMI reads keep working across a `dmactive` 0→1 cycle. The shadowed hart CSRs (`dcsr`/`dpc`/`dscratch*`) and the trigger CSRs (`tselect`/`tdata1`/`tdata2`) are also not affected by `dmactive`; they follow hart reset.

|`0x11`
|DMSTATUS
|R/O
|Reports single-hart halted/running/resume/nonexistent status, `authenticated`, `{any,all}havereset`, `ndmresetpending`, `impebreak`, and `version` = 3 (Debug Spec 1.0). `hasresethaltreq`, `confstrptrvalid`, and `stickyunavail` read 0.

|`0x12`
|HARTINFO
|R/O
|Returns the fixed RTL `HARTINFO_VALUE`.

|`0x16`
|ABSTRACTCS
|R/W1C fields
|Reports `progbufsize=2`, `datacount=2`, `busy`, and `cmderr`. Writing one to a `cmderr` bit clears the corresponding error state.

|`0x17`
|COMMAND
|R/W
|Dispatches a supported abstract command when the Debug Module is active and not busy.

|`0x18`
|ABSTRACTAUTO
|R/W
|Implements auto-execution controls for DATA0/DATA1 and PROGBUF0/PROGBUF1.

|`0x20`
|PROGBUF0
|R/W
|Program buffer word 0. Reset value is `0x0010_0073` (`EBREAK`).

|`0x21`
|PROGBUF1
|R/W
|Program buffer word 1. Reset value is `0x0010_0073` (`EBREAK`).

|`0x38`
|SBCS
|R/W
|System Bus Access (SBA) control/status. Implements 8-, 16-, and 32-bit access selection, read-on-address, read-on-data, autoincrement, busy, busy error, and SBA error reporting.

|`0x39`
|SBADDRESS0
|R/W
|32-bit System Bus Access (SBA) address.

|`0x3C`
|SBDATA0
|R/W
|32-bit System Bus Access (SBA) data register.

|`0x40`
|HALTSUM0
|R/O
|Bit 0 indicates that the implemented hart is halted.
|===

The RTL contains one hart. A non-zero `hartsello` value selects a non-existent hart and is reflected through the DMSTATUS `anynonexistent`/`allnonexistent` status. `hartsello` is only updated while no abstract command is in progress (`busy=0`); a write attempted during a command is ignored so hart selection stays stable for the running command.

`dmstatus.anyhavereset`/`allhavereset` reset to 1: any reset that reaches the Debug Module — power-on, the external reset pin, `ndmreset`, or `hartreset` — arms the bit, and it is cleared only by writing `ackhavereset`. It survives a `dmactive` 0→1 cycle.

=== Abstract Commands

The Debug Module implements Access Register and Access Memory command types.

==== Access Register

Supported register transfers use a 32-bit abstract access size.

The implemented register-number handling includes:

* Integer registers `x0`–`x31` through abstract register numbers `0x1000`–`0x101F`.
* `dpc` at CSR number `0x7B1`.
* Debug and machine CSRs below `0x1000` through the debug CSR path.
* `transfer=0, postexec=0` as a valid no-operation command.
* `postexec` execution through the two-word program buffer.

Commands requiring an unsupported access size report an abstract-command not-supported error (`cmderr=2`). Commands that require hart access while the hart is running report a halt/resume error (`cmderr=4`). An abstract access to a CSR the core does not implement fails with `cmderr=3` (exception) and performs no write — so a debugger probing for optional CSRs (e.g. vector `vlenb`, the AIA `mtopi`/`miselect` registers) is told the CSR is absent rather than receiving a spurious zero.

==== Access Memory

Access Memory supports 8-, 16-, and 32-bit transfers. `aamvirtual` is not implemented. Access sizes larger than 32 bits are reported as unsupported.

DATA1 supplies the address. DATA0 supplies or receives the transfer data. Address post-increment is supported by the RTL command engine.

=== System Bus Access (SBA)

SBA provides direct debug memory access independently of abstract Access Memory commands.

The RTL implements:

* 8-bit, 16-bit, and 32-bit accesses.
* `sbreadonaddr`.
* `sbreadondata`.
* `sbautoincrement`.
* `sbbusy` and `sbbusyerror`.
* SBA error reporting and write-one-to-clear error handling.

`sbbusyerror` is set whenever the debugger writes `SBADDRESS0` or `SBDATA0`, or
reads `SBDATA0`, while a system bus access is in progress (`sbbusy=1`); the
interfering `SBADDRESS0`/`SBDATA0` write is discarded (the shadow register keeps
its value). No SBA access is started while `sberror` or `sbbusyerror` is set;
both are cleared write-one-to-clear via `SBCS`.

The debug-bus response timeout (used by SBA and by abstract Access Memory) is a
counter of parameterized width `DBG_BUS_TIMEOUT_W` (default 12 → 4095 cycles,
about 41 µs at 100 MHz). A response later than the timeout reports `sberror=1`
(SBA) or `abstractcs.cmderr=5` (abstract memory). Integrators with very slow
debug targets can widen the parameter.

=== Debug CSRs

The Debug Module owns the debug CSRs listed below.

[cols="1,2,1,4"]
.Debug CSR Support
|===
|Address |CSR |Access |Behavior

|`0x7B0`
|dcsr
|R/W, WARL/RO fields
|Reports `xdebugver=4`. `prv` is forced to M-mode (`3`). Implemented writable controls include `ebreakm`, `stepie`, `stopcount`, `stoptime`, `mprven`, and `step`. `cause` is hardware-written and read-only to the debugger.

|`0x7B1`
|dpc
|R/W
|Debug program counter. Reset value is `0x8000_0000`.

|`0x7B2`
|dscratch0
|R/W
|Debug scratch register 0.

|`0x7B3`
|dscratch1
|R/W
|Debug scratch register 1.
|===

`dcsr` resets internally to `0x4000_0003`. Readback reconstructs read-only and WARL fields, including the hardware debug-entry cause.

=== Hardware Triggers

Trigger matching occurs in EX with timing-before behavior: a matching instruction is halted before it is promoted for normal execution. A trigger is eligible only when its type is 2, M-mode enable bit is set, and `action=1` requests Debug Mode entry.

The RTL supports:

* execute match against the instruction PC;
* load match against the effective data address;
* store match against the effective data address;
* exact address match (`match=0`);
* NAPOT address match (`match=1`) for load/store triggers.

Execute matching is exact-PC only in the current core. Unsupported `match` values fall back to exact comparison in the RTL helper.

If EBREAK debug-entry and a hardware trigger coincide, the debug-halt bookkeeping records the trigger as the halt cause (`trigger_halt`) and does not mark EBREAK as the separate halt cause. Multiple trigger slots may report hit simultaneously.

The default RTL implements two trigger slots (`N_TRIGGERS=2`). `N_TRIGGERS` is fully parameterized in both the core and the debug module: the trigger register bank, its reset values, the per-trigger hit-latch, and the `tselect` index are all generated from `N_TRIGGERS`, and the design elaborates for `N_TRIGGERS` = 1, 2, or 4. `tselect` is WARL to `[0, N_TRIGGERS)`.

[cols="1,2,4"]
.Trigger CSRs
|===
|Address |CSR |Behavior

|`0x7A0`
|tselect
|Selects a trigger slot. Writes outside the implemented trigger count are ignored.

|`0x7A1`
|tdata1
|Implements an mcontrol trigger. Every field is WARL-coerced on write to a value JV32 implements, so read-back reflects only supported behaviour: `type`=2, `action`=1 (enter Debug Mode), `match` ∈ {0 exact, 1 NAPOT} (other values read back 0), and `select`/`timing`/`sizelo`/`sizehi`/`chain`/`maskmax` = 0. `dmode`, the M-mode enable, and `execute`/`store`/`load` are stored as written. The hardware `hit` state is reported in bit 20 and is write-zero-to-clear.

|`0x7A2`
|tdata2
|Stores the trigger match value.

|`0x7A4`
|tinfo
|Returns `0x0000_0004`, indicating support for trigger type 2.
|===

The reset value of each implemented `tdata1` entry is `0x2000_0000`; `tdata2` resets to zero.

=== cJTAG Bridge

When `USE_CJTAG=1`, `cjtag_bridge.sv` converts the external two-wire TCKC/TMSC interface to the internal JTAG TAP signals.

The bridge implements:

* Two-stage synchronization of TCKC and TMSC into the system-clock domain.
* TCKC edge detection.
* TMSC escape-sequence detection.
* OScan1 serialized scan transport.
* TAP.7 star-2 activation behavior implemented by the state machine.
* Registered generation of the internal TAP clock and JTAG data/control signals.

The RTL requires each TCKC high and low phase to remain stable long enough to pass through the two-stage synchronizer and edge detector. The source comments specify the design requirement `f_sys >= 6 × f_tckc`. This is a functional sampling requirement, not an FPGA/ASIC timing-closure guarantee.

<<<

== Clock, Reset, and RTL Timing

=== Clock and Reset

==== Clock Domains

The SoC has two independent clock domains.

[cols="1,1,1,3"]
.Clock Domain Summary
|===
|Domain |Source |Nominal Frequency |Clocks

|System (`clk`)
|External pin
|100 MHz (parameterized via `CLK_FREQ`)
|`jv32_core`, TCM SRAM, AXI crossbar, UART, CLIC, Magic, debug system clock path

|TAP (`tck` / `tap_tck`)
|External TCK (`USE_CJTAG=0`) or bridge-generated TAP clock (`USE_CJTAG=1`)
|Integration-dependent
|`jtag_tap` and the TAP-domain DMI register bank. In cJTAG mode, the bridge samples TCKC using `clk`.
|===

The TAP and system-clock domains are asynchronous in 4-wire JTAG mode. CDC handling is split between `jtag_tap` and the system-clock debug engine: toggle/stable-payload handshakes and synchronizer stages are used at the boundary. `jv32_dtm` itself is a system-clock-domain module; it is not the sole location of the CDC synchronizers.

==== System Clock (`clk`)

The system clock drives the processor pipeline, TCM, peripherals, and the
system-clock half of the debug transport module.

[cols="1,1,3"]
.System Clock Specifications
|===
|Parameter |Value |Description

|Pin
|`clk`
|Single-ended clock input

|Nominal frequency
|100 MHz RTL default
|Parameterized via `CLK_FREQ`; affects UART baud divisor computation. The RTL default is a functional configuration value, not a defined implementation frequency.

|Minimum frequency
|No lower limit specified
|Must satisfy `CLK_FREQ / BAUD_RATE ≥ 4` for correct UART operation

|Maximum frequency
|Technology-dependent
|Not defined by the RTL. Use synthesis, static timing analysis, and implementation results for the selected FPGA or ASIC target.
|===

==== TAP Clock — `USE_CJTAG=0` (4-wire JTAG)

In 4-wire JTAG mode, `jtag_pin0_tck_i` directly clocks the TAP. TCK is asynchronous to the system clock. Status and command information crossing between the TAP and system-clock domains is synchronized in the debug logic.

The RTL does not define a universal maximum external TCK frequency. The usable TCK frequency depends on the implementation timing and on the clock-domain-crossing handshake latency. The DTMCS `idle=1` field requires the debugger to insert at least one Run-Test/Idle TCK cycle between DMI operations.

==== TAP Clock — `USE_CJTAG=1` (2-wire cJTAG)

In 2-wire cJTAG mode, `jtag_pin0_tck_i` carries TCKC and `jtag_pin1_tms_i/o` carries TMSC. `cjtag_bridge` samples both external signals using the system clock, detects synchronized TCKC edges, and generates the internal TAP clock and JTAG scan signals.

The bridge source defines the functional sampling requirement:

----
f_sys >= 6 × f_tckc
----

This corresponds to at least three system-clock cycles for each TCKC high or low phase, allowing the two-stage synchronizer and edge detector to observe the signal reliably at the RTL interface level.

The ratio above is a functional design requirement. Actual board-level and FPGA/ASIC timing margins must be established by the target implementation.

==== Reset Architecture

The SoC implements an **asynchronous-assert / synchronous-deassert** reset
pattern.  Two independent sources can assert reset: the external `rst_n` pin
and the debug non-debug-module reset (`dbg_ndmreset`) asserted by the RISC-V
Debug Module via JTAG.

===== Reset signal flow

[source,systemverilog]
----
// jv32_soc.sv
assign rst_n_pre = rst_n & ~dbg_ndmreset;   // (1) OR of both reset sources

always_ff @(posedge clk or negedge rst_n_pre) begin
    if (!rst_n_pre) begin
        rst_sync_ff1 <= 1'b0;               // (2) async assert: both FFs cleared immediately
        rst_sync_ff2 <= 1'b0;
    end else begin
        rst_sync_ff1 <= 1'b1;               // (3) synchronous deassert: propagates over 2 clk cycles
        rst_sync_ff2 <= rst_sync_ff1;
    end
end

assign soc_rst_n = rst_sync_ff2;            // (4) clean synchronised reset to all SoC logic
----

.Reset de-assertion timing (2-cycle synchroniser)
[wavedrom, format="svg"]
....
{
  "signal": [
    { "name": "rst_n_pre",    "wave": "0..1......", "node": "...A" },
    { "name": "clk",          "wave": "pppppppppp" },
    {},
    { "name": "rst_sync_ff1", "wave": "0....1....", "node": ".....B" },
    { "name": "rst_sync_ff2", "wave": "0.....1...", "node": "......C" },
    { "name": "soc_rst_n",    "wave": "0.....1..." }
  ],
  "edge": ["A~>B +1 clk", "B~>C +1 clk"],
  "config": { "hscale": 2 }
}
....

===== Reset source behavior

[cols="1,1,3"]
.Reset Sources
|===
|Source |Assertion |Description

|`rst_n`
|Asynchronous (active-low)
|External system reset pin; asserted immediately by hardware; de-asserted synchronously through the 2-FF chain

|`dbg_ndmreset`
|Asynchronous (active-high) from `jv32_dtm`
|Non-debug-module reset issued over JTAG (`dmcontrol.ndmreset`); resets the SoC while the debug module itself remains active; `rst_n_pre = rst_n & ~dbg_ndmreset`

|`dbg_hartreset`
|Core-local reset request
|`dbg_hartreset` is a TAP-domain level passed through the debug engine and combined into `core_rst_n = rst_n & ~dbg_hartreset_i`. It resets the core without resetting the peripheral subsystem or TAP. Unlike `ndmreset`, its release does not pass through the SoC two-flop reset synchronizer. Reset recovery/removal timing must be checked during physical integration.
|===

===== Reset domain coverage

`soc_rst_n` (the synchronised output of the 2-FF chain) is distributed to:

* `jv32_top` — processor pipeline, TCM SRAM control registers, AXI master/slave
* `axi_clic` — CLIC/CLINT registers (`mtime`, `mtimecmp`, `msip`, interrupt pending)
* `axi_uart` — UART TX/RX FIFOs and baud rate generator
* `axi_xbar` — AXI crossbar state

The JTAG TAP (`jtag_tap`) and `jv32_dtm` are reset by `rst_n` **directly** (not
through the synchroniser), so debug infrastructure is available as soon as the
external reset is released, independent of the 2-cycle delay on `soc_rst_n`.
`jtag_ntrst_i` provides an additional TAP-domain reset. System reset now clears both the TAP dispatch toggles and their receiving engine, preventing completed commands from replaying after reset. `ndmreset` leaves both debug domains active.

===== Reset timing requirements

[cols="2,1,3"]
.Reset Timing Requirements
|===
|Parameter |Minimum |Description

|`rst_n` assertion
|Asynchronous
|The RTL asynchronously clears the reset synchronizer when `rst_n_pre` is low. Minimum external reset pulse width is an implementation/electrical requirement and is not specified by the RTL.

|`rst_n` deassert hold (before first `clk` rising edge used for computation)
|2 clock cycles
|Two `clk` rising edges are required before `soc_rst_n` deasserts and SoC logic begins operating

|`rst_n` setup before `clk` rising edge
|Not required
|Deassertion is sampled synchronously; no setup requirement on the deassert edge

|`dbg_ndmreset` assertion
|Clock-domain generated
|The signal is a TAP-domain register level passed through the debug engine to the asynchronous assertion path of the SoC reset synchronizer. No independent external pulse-width requirement is defined by this RTL interface.
|===

[IMPORTANT]
The `rst_n_pre` net is a 2-input LUT driving the asynchronous clear (`CLR`) of
`rst_sync_ff1` and `rst_sync_ff2`.  In FPGA implementations this is an
intentional asynchronous-reset pattern; the path is marked as a false path to
suppress the Vivado LUTAR-1 methodology warning
(`fpga/scripts/constraints.xdc`).

=== Timing Parameters

The RTL does not define FPGA/ASIC setup time, hold time, clock-to-output time, or maximum operating frequency. Any numerical implementation timing values must come from a named synthesis/place-and-route target and timing report. Values in this section therefore describe protocol or RTL-cycle requirements only.

[cols="2,1,1,3"]
.Timing Characteristics (100 MHz, Tclk = 10 ns)
|===
|Parameter |Min |Max |Description

|Setup time (AXI inputs)
|2.0 ns
|—
|Input setup before clock edge

|Hold time (AXI inputs)
|1.0 ns
|—
|Input hold after clock edge

|Clock-to-output (AXI outputs)
|—
|8.0 ns
|Output valid after clock edge

|TCM read latency
|1 cycle
|—
|Registered SRAM output

|Load-to-use latency
|2 cycles
|—
|1 EX cycle + 1 stall cycle

|Branch flush penalty
|0 / 1 cycle
|—
|0 cycles on correct BTFNT prediction; 1 cycle on misprediction or when `BP_EN=0` and branch is taken

|===

=== Top-Level Parameters

[cols="1,1,3"]
.`jv32_soc` Configurable Parameters
|===
|Parameter |Default |Description

|`CLK_FREQ`
|`100_000_000`
|System clock frequency in Hz; used to compute UART baud divisor

|`BAUD_RATE`
|`115_200`
|UART baud rate (must satisfy `CLK_FREQ / BAUD_RATE >= 4`)

|`UART_FIFO_DEPTH`
|`16`
|TX and RX FIFO depth (same value for both; must be a power-of-2)

|`RV32E_EN`
|`0`
|`1`=RV32E reduced register file (x0–x15); `0`=RV32I register file (x0–x31). In RV32E mode, the decoder traps an instruction as illegal when an actually-used `rs1`, `rs2`, or written `rd` selects x16–x31. RV32E mode also disables the Zba/Zbb/Zbs datapath, RAS, and instruction prefetch buffer in `jv32_core`, and changes the `misa` base-ISA indication.

|`RV32M_EN`
|`1`
|`1`=M-extension enabled (MUL/DIV/REM instructions legal); `0`=all multiply/divide instructions trap as illegal

|`JTAG_EN`
|`1`
|`1`=JTAG debug port and RISC-V Debug Module instantiated; `0`=all debug outputs tied off, JTAG pins ignored

|`USE_CJTAG`
|`0`
|`0`=4-wire JTAG (TCK/TMS/TDI/TDO); `1`=2-wire cJTAG IEEE 1149.7 OScan1 (TCKC/TMSC); see <<_clock_and_reset>> for clock architecture

|`JTAG_IDCODE`
|`32'h1DEAD3FF`
|JTAG TAP `IDCODE` register value returned by the DTM on IR=`IDCODE` (0x01) scan

|`N_TRIGGERS`
|`2`
|Number of hardware breakpoint/watchpoint trigger registers (`tdata1`/`tdata2` pairs); verified for 1, 2, and 4

|`DBG_BUS_TIMEOUT_W`
|`12`
|Width of the debug-bus (SBA and abstract Access Memory) response-timeout counter. Default 12 → 4095 cycles (~41 µs at 100 MHz). Increase for slower external debug targets.

|`AMO_EN`
|`1`
|`1`=A-extension enabled (LR.W/SC.W and AMO{SWAP,ADD,XOR,AND,OR,MIN,MAX,MINU,MAXU}.W); `0`=all atomic instructions using the AMO opcode, including LR.W/SC.W, trap as illegal. Verified by `sw/amo_config` and `testbench/compliance/tb_disabled_isa.sv`.

|`FAST_MUL`
|`1`
|`1`=fast multiplier selected (mode set by `MUL_MC`); `0`=multi-cycle serial shift-and-add multiply (CLZ-reduced; 1–32 cycles)

|`MUL_MC`
|`1`
|When `FAST_MUL=1`: `1`=2-stage pipelined multiplier (2-cycle result), `0`=1-cycle combinatorial multiplier. Ignored when `FAST_MUL=0`.

|`SCOREBOARD_EN`
|`1`
|`1`=enable single-slot non-blocking scoreboard for multi-cycle `MUL` with ordered WB retirement. Blocks issue on RAW/WAW/structural/commit-sensitive hazards. `0`=disable scoreboard (all multi-cycle ALU ops use blocking path). In `jv32_top`, it is auto-gated off when `FAST_MUL=1`, `MUL_MC=0`, `FAST_DIV=1`, and `FAST_SHIFT=1` (all arithmetic single-cycle).

|`FAST_DIV`
|`0`
|`1`=single-cycle combinatorial divide; `0`=CLZ-reduced serial divide (1–32 cycles)

|`FAST_SHIFT`
|`1`
|`1`=single-cycle barrel shift; `0`=iterative shift (up to 31 cycles)

|`BP_EN`
|`1`
|`1`=BTFNT static branch predictor enabled (backward branches predicted taken, forward branches predicted not-taken); `0`=all branches predicted not-taken. EX-stage correction behavior is described in the branch-prediction section.

|`RAS_EN`
|`1`
|`1`=2-entry Return Address Stack enabled for eligible return prediction; `0`=return prediction through the RAS is disabled. The RAS is automatically disabled when `RV32E_EN=1`.

|`IBUF_EN`
|`1`
|`1`=2-entry instruction prefetch buffer enabled; `0`=disabled. The buffer is automatically disabled when `RV32E_EN=1`.

|`ZCMP_EN`
|`1`
|`1`=Zcmp extension enabled (`cm.push`, `cm.pop`, `cm.popret`, `cm.popretz`, `cm.mvsa01`, `cm.mva01s`); `0`=these instructions trap as illegal.

|`RV32B_EN`
|`1`
|`1`=Zba/Zbb/Zbs B-extension enabled (`SH1ADD`/`SH2ADD`/`SH3ADD`, bit-manipulation, etc.); `0`=all B-extension instructions trap as illegal (synthesized away).

|`IRAM_SIZE`
|`131072`
|IRAM size in bytes (power-of-2; also sets TCM address decode mask)

|`DRAM_SIZE`
|`131072`
|DRAM size in bytes (power-of-2)

|`BOOT_ADDR`
|`32'h8000_0000`
|Reset PC (word-aligned). Must equal `IRAM_BASE` for the core to boot from IRAM.

|`IRAM_BASE`
|`32'h8000_0000`
|IRAM TCM base address and address-decode base. Normally equals `BOOT_ADDR`.

|`DRAM_BASE`
|`32'h9000_0000`
|DRAM base address and TCM address decode start
|===

<<<

== Programming Guide

=== MMIO Access Rules

Peripheral registers are 32-bit memory-mapped registers unless a register description states otherwise. Software should use naturally aligned 32-bit accesses for control and status registers. Reserved offsets must not be used as part of the programming interface.

For device programming sequences, software should complete required configuration writes before enabling the corresponding interrupt or operation. The current RTL treats `FENCE` as a no-op, so software must not rely on it to create an additional hardware data-memory barrier. `FENCE.I` is implemented separately and flushes/refetches the instruction path for instruction-memory synchronization.

=== Access and Error Handling

Software must treat an AXI error response as a failed access. Error behavior is target-specific: UART and Magic can return `SLVERR` for unsupported addresses, while CLIC returns `OKAY` and zero/no-effect behavior for unsupported offsets. Addresses routed to the external AXI interface may return any response permitted by the connected target or interconnect.

Software and external masters should use naturally aligned accesses. Several RTL blocks select registers or SRAM words using upper address bits and do not independently reject all misaligned accesses.

=== Boot Sequence

The processor boots from `BOOT_ADDR` (default `0x8000_0000` = IRAM base). The reset vector is hardwired to `BOOT_ADDR & ~3` (word-aligned).

For simulation, the typical boot flow is:

1. ELF loaded into TCM via DPI (`mem_write_byte`) before simulation starts
2. Simulation starts, core fetches from `BOOT_ADDR` (mapped to IRAM, 1-cycle latency)
3. Startup code (`startup.S`) initialises stack pointer to top of DRAM
4. Hardware CSRs initialized: `mstatus`, `mtvec`, `mie`
5. Peripherals initialized (UART starts with the parameter-derived baud divisor; software may change it at runtime; CLIC `mtimecmp` is programmed as required)
6. `mstatus.MIE` set to enable interrupts
7. Jump to `main()`

=== Stack Configuration

Default linker script maps DRAM to data/BSS/stack:

----
Stack top: DRAM_BASE + DRAM_SIZE - 4    (e.g. 0x9001_FFFC)
Stack grows downward into DRAM
Data/BSS:  DRAM_BASE (loaded by startup.S from IRAM)
----

=== Interrupt Handling

==== Setting Up Interrupts

[source,c]
----
#include "csr.h"

extern void trap_entry(void);  // defined in startup.S

void setup_interrupts(void) {
    // Set trap vector (direct mode: mtvec points to handler)
    write_csr(mtvec, (uint32_t)trap_entry);

    // Enable M-mode interrupts in mstatus
    set_csr(mstatus, 0x8);  // MIE bit

    // Enable timer + external + software interrupts in mie
    set_csr(mie, (1<<7) | (1<<11) | (1<<3));  // MTIE | MEIE | MSIE

    // Program CLIC mtimecmp for periodic 1ms timer (100 MHz)
    volatile uint32_t *mtime_lo    = (uint32_t *)0x02004000;
    volatile uint32_t *mtime_hi    = (uint32_t *)0x02004004;
    volatile uint32_t *mtimecmp_lo = (uint32_t *)0x02004008;
    volatile uint32_t *mtimecmp_hi = (uint32_t *)0x0200400C;

    // Set mtimecmp_hi first to avoid spurious IRQ
    *mtimecmp_hi = 0xFFFFFFFF;
    uint64_t now = ((uint64_t)*mtime_hi << 32) | *mtime_lo;
    uint64_t cmp = now + 100000;  // 1 ms @ 100 MHz
    *mtimecmp_lo = (uint32_t)cmp;
    *mtimecmp_hi = (uint32_t)(cmp >> 32);
}
----

==== Trap Handler

[source,c]
----
void trap_handler(uint32_t mcause_val) {
    if (mcause_val & 0x80000000) {
        // Interrupt
        uint32_t cause = mcause_val & 0x7FFFFFFF;
        switch (cause) {
        case 7:   // Machine timer interrupt
            handle_timer_irq();
            break;
        case 11:  // Machine external interrupt (CLIC)
            handle_clic_irq();
            break;
        case 3:   // Machine software interrupt
            handle_sw_irq();
            break;
        }
    } else {
        // Synchronous exception
        handle_exception(mcause_val);
    }
}

void handle_timer_irq(void) {
    // Clear by advancing mtimecmp
    volatile uint32_t *cmp_lo = (uint32_t *)0x02004008;
    volatile uint32_t *cmp_hi = (uint32_t *)0x0200400C;
    uint64_t cmp = ((uint64_t)*cmp_hi << 32) | *cmp_lo;
    cmp += 100000;  // next 1 ms
    *cmp_hi = 0xFFFFFFFF;  // prevent spurious IRQ during update
    *cmp_lo = (uint32_t)cmp;
    *cmp_hi = (uint32_t)(cmp >> 32);
}

void handle_clic_irq(void) {
    // CLIC vectored entry: mcause = 0x8000_000B, mintstatus.mil = this IRQ's level.
    // Scan CLICINT[n].ip to identify the source; IP auto-clears when ext_irq_i[n] deasserts.
    for (int n = 0; n < 16; n++) {
        volatile uint32_t *clicint = (uint32_t *)(0x02001000 + n * 4);
        if (*clicint & 0x1) {
            // Source n is pending — handle it here.
        }
    }
    // Software-assisted tail-chain: check for next pending IRQ via mnxti.
    // If a higher-priority IRQ arrived during this handler, chain directly to it.
    uintptr_t next = read_csr(mnxti);
    if (next) {
        // Claim it (sets mcause, mintstatus.mil, re-enables MIE) and branch.
        write_csr(mnxti, 0);
        ((void (*)(void))next)();
    }
    // Hardware tail-chain: if another CLIC IRQ above mintthresh is pending
    // when this handler's mret executes, the CPU redirects to mtvt+4*id
    // automatically — no code change needed.
}
----

=== UART Usage

[source,c]
----
#define UART_DATA   (*(volatile uint32_t *)0x20010000)
#define UART_STATUS (*(volatile uint32_t *)0x20010004)
#define UART_IE     (*(volatile uint32_t *)0x20010008)
#define UART_IS     (*(volatile uint32_t *)0x2001000C)

// Poll-mode transmit
void uart_putc(char c) {
    while (UART_STATUS & 0x1);  // wait until TX not full
    UART_DATA = c;
}

// Poll-mode receive
char uart_getc(void) {
    while (!(UART_STATUS & 0x4));  // wait until RX not empty
    return (char)(UART_DATA & 0xFF);
}

// Print string
void uart_puts(const char *s) {
    while (*s) uart_putc(*s++);
}
----

=== Simulation Debugging

==== Magic Device Console

[source,c]
----
#define MAGIC_CON (*(volatile uint32_t *)0x40000000)
#define MAGIC_EXIT (*(volatile uint32_t *)0x40000004)

void debug_putc(char c) { MAGIC_CON = c; }
void debug_puts(const char *s) { while (*s) debug_putc(*s++); }
void sim_pass(void) { MAGIC_EXIT = 1; }              // HTIF: exit(0)
void sim_fail(int code) { MAGIC_EXIT = (code << 1) | 1; }  // HTIF: exit(code)
----

==== Waveform Capture

Generate VCD waveform for GTKWave analysis:

----
make WAVE=1 rtl-hello
gtkwave build/tb_jv32_soc.vcd
----

Key signals to observe:

* **Pipeline**: `jv32_core.pc_if`, `jv32_core.pc_ex`, `jv32_core.pc_wb`
* **TCM**: `jv32_top.imem_req_valid`, `jv32_top.imem_resp_valid`, `jv32_top.dmem_req_valid`
* **AXI master**: `jv32_top.m_axi_arvalid`, `jv32_top.m_axi_rvalid`
* **Interrupts**: `jv32_soc.timer_irq`, `jv32_soc.clic_irq`
* **Heartbeat**: `jv32_soc.heartbeat_o` — toggles every 2^24 retired instructions; a slow square wave indicating the core is making forward progress

==== Instruction Trace

Software and RTL traces can be compared for regression:

----
make compare-hello
diff sim_trace.txt rtl_trace.txt
----

Trace format: `<cycle> <pc> <hex_instruction> <disassembly>`

=== Performance-Oriented Programming Considerations

The following items are implementation-aware guidance, not architectural requirements:

* Place latency-sensitive code and data in TCM when deterministic local-memory access is desired.
* Schedule independent instructions between a load and its first consumer when practical to avoid a load-use stall.
* Select `FAST_MUL`, `FAST_DIV`, and `FAST_SHIFT` according to the required area/latency trade-off.
* Avoid unnecessary D-side accesses to IRAM when instruction-fetch contention matters.
* Measure complete workloads on the target configuration; this datasheet does not define a typical CPI or system performance target.
<<<

== Register Reference Index

The following block sections contain the register definitions. Use these definitions for access rules, side effects, parameter dependencies, and reset behavior:

* <<_csr_control_and_status_registers,Machine CSRs>>
* <<_register_map,Local interrupt controller and timer registers>>
* <<_uart_register_map,UART registers>>
* <<_magic_device_register_map,Magic simulation registers>>
* <<_dmi_register_map,Debug Module registers>>

<<<

[appendix]

== Trap Cause Reference

This section summarizes trap cause encodings implemented or recognized by the current RTL. See <<_exception_and_interrupt_handling>> for behavior and trap-entry sequencing.

[cols="1,2,3,2"]
.Implemented Machine-Mode Trap Causes (`mcause` encoding)
|===
|Code |Type |Description |Source

|1
|Exception
|Instruction access fault
|I-fetch AXI `SLVERR`/`DECERR`

|2
|Exception
|Illegal instruction
|Core decode

|3
|Exception
|Breakpoint
|EBREAK

|4
|Exception
|Load address misaligned
|Core; normal loads and misaligned LR.W

|5
|Exception
|Load access fault
|D-bus AXI `SLVERR`/`DECERR`

|6
|Exception
|Store address misaligned
|Core; normal stores and misaligned SC.W / AMO.W

|7
|Exception
|Store/AMO access fault
|D-bus AXI `SLVERR`/`DECERR`

|11
|Exception
|ECALL from M-mode
|ECALL instruction

|`0x8000_0003`
|Interrupt
|Machine software interrupt
|CLIC MSIP[0]

|`0x8000_0007`
|Interrupt
|Machine timer interrupt
|CLIC `mtime >= mtimecmp`

|`0x8000_000B`
|Interrupt
|Machine external interrupt
|CLIC any `CLICINT[n].ie & ip` with level > mintthresh
|===

NOTE: `mcause[31]=1` indicates interrupt; `mcause[30:0]` is the cause code.

<<<

[appendix]

== Pin Descriptions

This section is the integration-facing signal reference. Signal behavior is defined in the corresponding functional sections; this section provides direction, width, and interface-level purpose.

=== Clock and Reset Pins

[cols="1,1,1,3"]
.Clock and Reset Pins
|===
|Signal |I/O |Width |Description

|`clk`
|Input
|1
|System clock (100 MHz nominal)

|`rst_n`
|Input
|1
|Asynchronous active-low reset signal
|===

=== UART Interface

[cols="1,1,1,3"]
.UART Pins
|===
|Signal |I/O |Width |Description

|`uart_tx_o`
|Output
|1
|UART transmit data

|`uart_rx_i`
|Input
|1
|UART receive data (asynchronous)
|===

=== External Interrupt Interface

[cols="1,1,1,3"]
.External Interrupt Pins
|===
|Signal |I/O |Width |Description

|`ext_irq_i[15:0]`
|Input
|16
|External interrupt request lines, routed to CLIC `CLICINT[n].ip`; active-high, level-sensitive
|===

=== TCM AXI Slave Interface

[cols="1,1,1,3"]
.TCM Slave Port Pins (exposed as `s_tcm_*` on `jv32_soc`)
|===
|Signal |I/O |Width |Description

|`s_tcm_araddr[31:0]`
|Input
|32
|Read address

|`s_tcm_arvalid`
|Input
|1
|Read address valid

|`s_tcm_arready`
|Output
|1
|Read address ready

|`s_tcm_rdata[31:0]`
|Output
|32
|Read data

|`s_tcm_rresp[1:0]`
|Output
|2
|Read response

|`s_tcm_rvalid`
|Output
|1
|Read data valid

|`s_tcm_rready`
|Input
|1
|Read data ready

|`s_tcm_awaddr[31:0]`
|Input
|32
|Write address

|`s_tcm_awvalid`
|Input
|1
|Write address valid

|`s_tcm_awready`
|Output
|1
|Write address ready

|`s_tcm_wdata[31:0]`
|Input
|32
|Write data

|`s_tcm_wstrb[3:0]`
|Input
|4
|Write byte strobes

|`s_tcm_wvalid`
|Input
|1
|Write data valid

|`s_tcm_wready`
|Output
|1
|Write data ready

|`s_tcm_bresp[1:0]`
|Output
|2
|Write response

|`s_tcm_bvalid`
|Output
|1
|Write response valid

|`s_tcm_bready`
|Input
|1
|Write response ready
|===

=== JTAG / cJTAG Debug Interface

Active only when `JTAG_EN=1`. Pin roles differ between `USE_CJTAG=0` (4-wire JTAG) and `USE_CJTAG=1` (2-wire cJTAG).

[cols="1,1,1,3"]
.JTAG / cJTAG Debug Pins
|===
|Signal |I/O |Width |Description

|`jtag_ntrst_i`
|Input
|1
|TAP reset (active-low); resets the JTAG TAP state machine independently of `rst_n`. Tie high if not used.

|`jtag_pin0_tck_i`
|Input
|1
|`USE_CJTAG=0`: TAP clock (TCK), driven by debug probe, asynchronous to `clk`. +
`USE_CJTAG=1`: cJTAG serial clock (TCKC); asynchronous to `clk`; internally sampled by 2-stage synchroniser in `cjtag_bridge`. Maximum frequency = f~sys~/6.

|`jtag_pin1_tms_i`
|Input
|1
|`USE_CJTAG=0`: TAP Mode Select (TMS). +
`USE_CJTAG=1`: cJTAG data (TMSC) input direction; driven by probe during scan-in.

|`jtag_pin1_tms_o`
|Output
|1
|`USE_CJTAG=0`: not driven (tie `jtag_pin1_tms_oe` low). +
`USE_CJTAG=1`: TMSC output direction; valid when `jtag_pin1_tms_oe=1` (SoC driving TMSC during scan-out).

|`jtag_pin1_tms_oe`
|Output
|1
|TMSC output-enable (active-high). Drive the `OE` of an external IOBUF on TMSC. In `USE_CJTAG=0` mode this is always 0.

|`jtag_pin2_tdi_i`
|Input
|1
|`USE_CJTAG=0`: TAP Data In (TDI). +
`USE_CJTAG=1`: not used (internal cJTAG shift path is fully serialised over TMSC).

|`jtag_pin3_tdo_o`
|Output
|1
|`USE_CJTAG=0`: TAP Data Out (TDO); valid on falling edge of TCK. +
`USE_CJTAG=1`: not used; cJTAG scan-out uses TMSC.

|`jtag_pin3_tdo_oe`
|Output
|1
|TDO output-enable (active-high). Drive the `OE` of an external tristate buffer on TDO. In `USE_CJTAG=0` mode this follows the TAP shift state.
|===

=== Trace Interface

Present in simulation only (excluded from synthesis via `` `ifndef SYNTHESIS ``). All outputs change on the rising edge of `clk` and are qualified by `trace_valid`. Connect to the testbench trace logger.

[cols="1,1,1,3"]
.Trace Output Pins
|===
|Signal |I/O |Width |Description

|`trace_en`
|Input
|1
|Run-time trace enable gate; when low, `trace_valid` stays deasserted

|`trace_valid`
|Output
|1
|Strobe: high for one `clk` cycle when a new instruction has retired

|`trace_reg_we`
|Output
|1
|Register file write enable for the retired instruction

|`trace_pc`
|Output
|32
|PC of the retired instruction

|`trace_rd`
|Output
|5
|Destination register index of the retired instruction

|`trace_rd_data`
|Output
|32
|Value written to `rd` (valid when `trace_reg_we=1`)

|`trace_instr`
|Output
|32
|32-bit expanded instruction word (after RVC expansion)

|`trace_mem_we`
|Output
|1
|Memory write-enable for the retired instruction (store)

|`trace_mem_re`
|Output
|1
|Memory read-enable for the retired instruction (load)

|`trace_mem_addr`
|Output
|32
|Memory address of the load/store

|`trace_mem_data`
|Output
|32
|Data written to memory (store) or loaded from memory (load)

|`trace_irq_taken`
|Output
|1
|Strobe: high for one cycle when an interrupt is taken (pipeline redirected to handler)

|`trace_irq_cause`
|Output
|32
|`mcause` value captured at interrupt entry

|`trace_irq_epc`
|Output
|32
|`mepc` value captured at interrupt entry (pre-empted PC)

|`trace_irq_store_we`
|Output
|1
|Interrupt pipeline — memory write-enable for interrupt-triggered store (e.g. stack save)

|`trace_irq_store_addr`
|Output
|32
|Interrupt pipeline — store address

|`trace_irq_store_data`
|Output
|32
|Interrupt pipeline — store data
|===

=== Branch Predictor Observability (`perf_bp_*`)

One-cycle pulse outputs that count branch-predictor events.  Active only with `BP_EN=1`; tied to `0` otherwise.  Intended for performance counters in a testbench or external logic analyzer.

[cols="1,1,1,3"]
.Branch Predictor Observability Pins
|===
|Signal |I/O |Width |Description

|`perf_bp_branch`
|Output
|1
|A conditional branch retired this cycle

|`perf_bp_taken`
|Output
|1
|The conditional branch was taken

|`perf_bp_mispred`
|Output
|1
|Branch prediction was wrong (EX-stage redirect)

|`perf_bp_jal`
|Output
|1
|A JAL instruction retired this cycle

|`perf_bp_jal_miss`
|Output
|1
|JAL was not pre-decoded (caused an EX-stage redirect)

|`perf_bp_jalr`
|Output
|1
|A JALR instruction retired this cycle (is resolved in EX; eligible returns may already have a RAS prediction)
|===

=== Heartbeat Output

`heartbeat_o` is a single-bit observability output derived from bit 24 of the `minstret` counter in `jv32_csr`. It changes state as instructions retire and can be connected to an LED, logic analyzer, or testbench monitor.

[cols="1,1,1,3"]
.Heartbeat Pin
|===
|Signal |I/O |Width |Description

|`heartbeat_o`
|Output
|1
|`minstret[24]`. The output toggles every `2^24` retired instructions. One complete low-to-high-to-low period spans `2 × 2^24` retired instructions.
|===

The period depends on the average cycles per retired instruction (CPI):

----
T = (2 × 2^24 × CPI_avg) / f_clk
----

For example, at the default 100 MHz system clock and `CPI_avg = 1.0`, one complete period is approximately 336 ms. Real software may have a longer period because stalls, memory accesses, branches, and multi-cycle operations increase CPI.

=== External AXI Master Interface (`ext_axi_*`)

The external AXI master port carries transactions that fall outside all TCM and peripheral apertures (crossbar slave 3 catch-all). Connect to an external memory or MMIO fabric, or tie `ext_axi_arready`, `ext_axi_rvalid`, `ext_axi_awready`, `ext_axi_wready`, `ext_axi_bvalid` all to 0 if no external master is needed (the core will stall until reset).

[cols="1,1,1,3"]
.External AXI Master Pins
|===
|Signal |I/O |Width |Description

|`ext_axi_araddr[31:0]`
|Output
|32
|Read address

|`ext_axi_arvalid`
|Output
|1
|Read address valid

|`ext_axi_arready`
|Input
|1
|Read address ready

|`ext_axi_rdata[31:0]`
|Input
|32
|Read data

|`ext_axi_rresp[1:0]`
|Input
|2
|Read response (`OKAY`/`SLVERR`/`DECERR`)

|`ext_axi_rvalid`
|Input
|1
|Read data valid

|`ext_axi_rready`
|Output
|1
|Read data ready

|`ext_axi_awaddr[31:0]`
|Output
|32
|Write address

|`ext_axi_awvalid`
|Output
|1
|Write address valid

|`ext_axi_awready`
|Input
|1
|Write address ready

|`ext_axi_wdata[31:0]`
|Output
|32
|Write data

|`ext_axi_wstrb[3:0]`
|Output
|4
|Write byte strobes

|`ext_axi_wvalid`
|Output
|1
|Write data valid

|`ext_axi_wready`
|Input
|1
|Write data ready

|`ext_axi_bresp[1:0]`
|Input
|2
|Write response

|`ext_axi_bvalid`
|Input
|1
|Write response valid

|`ext_axi_bready`
|Output
|1
|Write response ready
|===

== Release and Integration Checklist

Before releasing an RTL configuration or software package, verify:

* ISA feature parameters and the resulting programmer-visible instruction set.
* `misa` against the enabled MISA-visible extensions.
* IRAM/DRAM sizes, linker-script regions, and canonical/alias address use.
* UART clock assumptions and the reset/default baud divisor.
* CLIC interrupt count, vector base, `mintthresh`, and enabled interrupt controls.
* External AXI address ownership and expected responses for non-internal addresses.
* JTAG/cJTAG mode selection, TAP connectivity, debug reset behavior, and supported DMI flow.
* SRAM/TCM initialization mechanism for the selected simulation, FPGA, or ASIC environment.
* Software headers and register definitions against the detailed block sections in this datasheet.
* Verification results for ISA compliance, privileged-architecture behavior, debug interoperability, AXI protocol compliance, target timing closure, and target-specific electrical requirements.

Any parameter change that affects software-visible behavior should update the RTL, this datasheet, software headers, linker configuration, and verification environment together.

[[verification-status]]
== Verification and Compliance Status

Measured on 2026-09-17. Commands, configuration boundaries, and remaining
requirements are recorded in `verif/COMPLIANCE_RESULTS.md`. The final regression passed all 42 commands. A passing test
establishes the tested behavior, not complete specification conformance.

[cols="2,3,3,3"]
|===
|Area |Implementation |Verification |Compliance claim
|Base ISA and extensions
|Parameterized RV32I/E with optional M/A/B/Zcmp groups
|24 effective ISA configurations passed 2,120 applicable architectural-test executions; Zcmp has separate project-model and directed coverage
|Configured tests verified; not independent certification of every extension
|CSRs, traps, interrupts
|Machine-mode subset and project-specific CLIC-like sideband
|82 cycle-level CSR checks and CPU-generated fault checks verify exact cause, PC, and trap value; trap/nested-interrupt regressions passed
|Tested behavior verified; no full privileged-architecture claim
|Local interrupt controller and timer
|CLINT-style registers and CLIC-like external control
|100 randomized transactions and AXI response stability assertions passed (1,176 checks at the default seed)
|No full CLIC or CLINT claim
|AXI and memory
|Implemented slave/master paths and TCM aliases
|RAM, UART, Magic, CLIC, both TCM slave ports, and crossbar tests; all-channel external-memory stalls; 34 address-boundary probes
|Implemented single-beat paths tested with stability assertions; not AXI certification
|JTAG and Debug Module
|RISC-V Debug Specification 1.0-oriented subset
|Directed checks include unsupported DMI/IR values, independent resets, slow/fast/jittered TCK; OpenOCD and GDB interoperability tested
|Tested interoperability verified; no complete Debug Spec conformance claim
|Reset and CDC
|Distributed synchronizers and debug transfer protocols
|Two-edge SoC reset release, TCM retention, independent debug resets, and bundled-payload assertions tested; crossing inventory in `verif/CDC_REVIEW.md`
|Simulation evidence only; exhaustive reset-phase and structural CDC signoff remain open
|===

== Revision History

[cols="1,2,5"]
.Revision History
|===
|Revision |Date |Summary

|1.4
|2026-09-17
|Fixed AXI response retention, independent UART write channels and strobes, TCM concurrent-request arbitration, crossbar duplicate reads, and debug command replay after system reset. Added the 24-configuration ISA matrix, address-boundary tests, reset checks, and CDC inventory. Added directed compliance regressions and measured verification status. Corrected MSIP byte strobes, zero-strobe MTIME writes, and AMO parameter documentation. Reviewed against the supplied RTL and reorganized the SoC datasheet to match the current RTL. Clarified ISA and CSR behavior, memory map and TCM aliases, CLIC, UART, AXI, debug/JTAG, atomic operations, exceptions, control-flow behavior, and integration requirements.
|===

== References

=== Verification Boundary

This document is intended to match the supplied RTL source set. Functional correctness, ISA compliance, AXI compliance, timing closure, and target-specific electrical behavior require their respective verification and implementation flows. The datasheet does not replace those verification results.

The RTL is the implementation source of truth for this datasheet. When modifying programmer-visible behavior, update the RTL and this document in the same change set.

Within this document, each detailed block section is authoritative for that block's behavior. The register index links to these definitions, and appendices are summaries only. If a summary omits a restriction, side effect, parameter dependency, or error condition, use the detailed block specification.

The following specifications provide background for the interfaces and architecture described in this datasheet:

* **RISC-V Specifications**: https://riscv.org/technical/specifications/
* **AMBA AXI4-Lite Specification**: https://developer.arm.com/documentation/ihi0022/latest/

<<<

[appendix]
