kuopinghsu/jv32.dev/syn/README.md

# jv32 SoC — Synthesis & P&R with OpenRAM + OpenLane2 (Nangate 45nm)

## Overview

This directory implements the full physical implementation flow for `jv32_soc`:

1. **OpenRAM** compiles the TCM SRAM macros with the Nangate 45nm (FreePDK45) process.
2. **OpenLane2** runs the Classic flow: synthesis → floorplan → placement → CTS → routing → signoff.

## Directory layout

```
syn/
├── Makefile                          # build orchestration
├── README.md
├── REPORT.md                         # latest synthesis/P&R results summary
├── layout.png                        # KLayout screenshot of completed GDS
├── requirements.txt                  # Python deps for scripts
├── slpp_all/                         # Yosys SLPP intermediate files
├── common/
│   ├── rtl_filelist.f                # ordered RTL file list for synthesis
│   ├── gen_openram_config.py         # generates OpenRAM Python config from Makefile vars
│   ├── fix_openram_lef_grid.py       # fixes LEF grid alignment for OpenROAD
│   └── openram_sitecustomize.py      # OpenRAM site-customization shim
├── lib/
│   ├── sram_1rw.sv                   # synthesis black-box wrapper (maps to OpenRAM macros)
│   ├── clockgate_map.v               # Yosys ICG mapping → CLKGATE_X1
│   ├── clockgate_hier_map.v          # hierarchical ICG mapping
│   ├── clockgate_dft_map.v           # DFT ICG mapping → CLKGATETST_X1
│   ├── clockgate_hier_dft_map.v      # hierarchical DFT ICG mapping
│   ├── scan_map.v                    # DFT scan-FF mapping → SDFF_X1/SDFFR_X1
│   ├── NangateOpenCellLibrary_ff_map.v  # Nangate FF-type mapping for Yosys dfflibmap
│   └── openram/                      # generated by 'make gen-mem' (git-ignored)
│       ├── sram_1rw_1024x64.lef
│       ├── sram_1rw_1024x64.gds
│       ├── sram_1rw_1024x64.v
│       ├── sram_1rw_1024x64_TT_1p1V_25C.lib
│       ├── sram_1rw_1024x64_FF_1p0V_25C.lib
│       └── sram_1rw_1024x64_SS_1p0V_25C.lib
├── openlane/
│   ├── config.yaml                   # OpenLane2 design configuration
│   ├── config_gate_count.yaml        # OpenLane2 config for gate-count-only run
│   ├── jv32_soc_pnr.sdc             # PnR timing constraints
│   └── macro_placement.cfg           # fixed SRAM macro placement coordinates
├── scripts/
│   ├── openlane_nix.sh               # OpenLane2 Nix shell launcher
│   ├── openroad_nix.sh               # OpenROAD Nix shell launcher
│   ├── gen_report.py                 # synthesis report generator
│   ├── gen_gate_count.py             # gate-count extractor
│   ├── gen_layout_gds.py             # GDS layout generation helper
│   ├── gen_icg_clocks.py             # ICG clock-signal lister
│   ├── hier_synth.sh                 # hierarchical Yosys synthesis runner
│   ├── extract_from_log.py           # log-data extractor
│   ├── openlane_resume_step.py       # OpenLane resume-from-step helper
│   ├── patch_verilog_nc_ports.py     # Verilog port patching for LVS
│   ├── strip_physical_cells_verilog.py  # strip physical cells from netlist
│   ├── fix_spice_power_nets.py       # fix SPICE power-net names
│   ├── normalize_spice_hiernames.py  # normalise SPICE hierarchical names
│   ├── normalize_spice_power.py      # normalise SPICE power declarations
│   ├── normalize_before_lvs.sh       # pre-LVS netlist normalisation
│   └── openroad/
│       ├── report_timing.tcl         # post-route timing report helper
│       └── run_pnr.tcl               # standalone OpenROAD P&R script
└── pdk/
    ├── NangateOpenCellLibrary_typical.lib   # Nangate std-cell timing lib
    └── freepdk45/
        └── libs.tech/
            ├── klayout/
            │   └── freepdk45.map            # KLayout layer map
            ├── magic/
            │   ├── freepdk45.magicrc
            │   └── freepdk45.tcl
            ├── netgen/
            │   └── freepdk45.tcl
            └── openlane/
                ├── config.tcl               # PDK-level OpenLane2 config
                └── NangateOpenCellLibrary/
                    ├── config.tcl           # SCL-level OpenLane2 config
                    ├── tracks.info          # metal track table (legacy format)
                    ├── drc_exclude.cells    # cells excluded from DRC
                    └── no_synth.cells       # cells excluded from synthesis
```

## Prerequisites

### 1. Tools

| Tool | Source | Required for |
|---|---|---|
| OpenRAM 1.2.48 | `$HOME/opt/OpenRAM` | SRAM macro compilation |
| OpenLane 2.x | `$HOME/opt/openlane2` | Synthesis + P&R |
| Python 3.8+ | system | running OpenRAM scripts |

### 2. Nangate 45nm Open Cell Library (FreePDK45)

The full Nangate OpenCellLibrary is required for P&R (LEF + GDS).
The timing lib (`NangateOpenCellLibrary_typical.lib`) is already checked in to `syn/pdk/`.

Download the complete FreePDK45 release from NC State University:
<https://www.eda.ncsu.edu/wiki/FreePDK45>

After download, set `NANGATE_HOME` in `env.config`:

```
NANGATE_HOME=/path/to/FreePDK45/NangateOpenCellLibrary
```

Expected files under `NANGATE_HOME`:
- `NangateOpenCellLibrary.tech.lef`
- `NangateOpenCellLibrary.macro.lef` (or `.macro.mod.lef`)
- `NangateOpenCellLibrary.gds`
- `lib/NangateOpenCellLibrary_typical.lib` *(optional; local copy is used otherwise)*

### 3. env.config

Add the following to `$PROJECT_ROOT/env.config`:

```makefile
# ── ASIC flow tools ──────────────────────────────────────────────────────────
OPENRAM      = $(HOME)/opt/OpenRAM
OPENLANE     = $(HOME)/opt/openlane2
OPENROAD     = $(SYN_DIR)/scripts/openroad_nix.sh
NANGATE_HOME = /path/to/FreePDK45/NangateOpenCellLibrary
```

## Quick start

```bash
cd syn/

# 1. Create the local Python venv for OpenRAM
make openram-setup

# 2. Pre-fetch Nix packages for OpenLane2 / OpenROAD (~500 MB, once only)
make syn-setup

# 3. Compile the SRAM macros (Nangate 45nm, 16 KB IRAM + DRAM — evaluation)
make gen-mem

# 4. Run OpenLane2 (synthesis + place + route + signoff)
make synth
```

Results land in `build/openlane_run/`.

## SRAM macro details

jv32 TCM memories are currently configured for **16 KB** each (evaluation).
Each TCM is decomposed into 2 × `sram_1rw_1024x64` sub-banks:

```
IRAM (16 KB) = 2 × sram_1rw_1024x64   (1024 words × 64-bit,  addr[10] = bank select)
DRAM (16 KB) = 2 × sram_1rw_1024x64   (same macro,  4 instances total)
```

### Macro physical parameters (`words_per_row = 4`)

| Parameter | Value |
|---|---|
| Configuration | 1024 words × 64-bit, 8 write-mask bits |
| `words_per_row` | 4 — 256 rows, 256 bits/row (~1:1.6 W:H aspect ratio) |
| LEF SIZE | **247.88 × 386.12 µm** |
| 4-macro footprint | 1249.02 µm wide × 406.12 µm tall (at y = 20 µm) |

The RTL source (`rtl/jv32_soc.sv`, `rtl/jv32/jv32_top.sv`) retains 128 KB as its
module-parameter default; the synthesis build overrides to 16 KB via
`SYNTH_PARAMETERS` in `openlane/config.yaml` and `IRAM_BANKS`/`DRAM_BANKS` in
`syn/Makefile` (each bank is one `sram_1rw_1024x64` = 8 KB).

To switch to a different TCM size, update both those two locations and
add/select the matching generate-branch in `syn/lib/sram_1rw.sv`:

```bash
# Example: 64 KB each (8 banks × 8 KB)
make gen-mem IRAM_BANKS=8 DRAM_BANKS=8
```

## OpenLane2 flow details

The `openlane/config.yaml` targets:
- **PDK**: `freepdk45` (Nangate 45nm Open Cell Library)
- **Clock**: 80 MHz (12.5 ns period)
- **Core utilisation**: 45% placement density (`PL_TARGET_DENSITY: 0.45`)
- **Global routing**: up to Metal9

The custom PDK configuration lives in `pdk/freepdk45/libs.tech/openlane/`.
OpenLane2 is invoked with `--pdk-root $(CURDIR)/pdk --pdk freepdk45`.

### Current synthesised configuration

The parameters below are written to `build/tcm_params.yaml` by `make synth` /
`make gen-mem` and are passed to Yosys via `SYNTH_PARAMETERS`:

| Parameter | Value | Description |
|---|---|---|
| `IRAM_BANKS` | `2` (16 KB) | IRAM sub-bank count (1 bank = 8 KB) |
| `DRAM_BANKS` | `2` (16 KB) | DRAM sub-bank count (1 bank = 8 KB) |
| `FAST_MUL` | **`1`** | Multiplier enable (1 = fast path) |
| `MUL_MC` | **`1`** | 2-stage pipelined multiplier (requires `FAST_MUL=1`) |
| `FAST_DIV` | **`0`** | Serial restoring divider (variable latency) |
| `FAST_SHIFT` | **`1`** | Barrel shifter (1-cycle) |
| `BP_EN` | **`1`** | Branch predictor enabled |
| `IBUF_EN` | **`1`** | Instruction buffer enabled |
| `ZCMP_EN` | **`1`** | Zcmp extension enabled |

To change any parameter pass it on the `make` command line, e.g.:

```bash
make synth FAST_MUL=1 FAST_SHIFT=1
```

## Variables reference

| Variable | Default | Description |
|---|---|---|
| `OPENRAM` | `$(HOME)/opt/OpenRAM` | OpenRAM root |
| `OPENLANE` | `$(HOME)/opt/openlane2` | OpenLane2 root |
| `OPENROAD` | `$(SYN_DIR)/scripts/openroad_nix.sh` | OpenROAD binary / wrapper |
| `NANGATE_HOME` | *(must be set)* | Nangate 45nm library root |
| `IRAM_BANKS` | `2` (→ 16 KB) | IRAM sub-bank count; 1 bank = one `sram_1rw_1024x64` = 8 KB |
| `DRAM_BANKS` | `2` (→ 16 KB) | DRAM sub-bank count; same macro |
| `OPENRAM_OPTIMIZE` | `speed` | `speed` or `area` |
| `FAST_MUL` | `1` | `1` = enable fast multiplier path; `0` = serial shift-and-add |
| `MUL_MC` | `1` | `1` = 2-stage pipelined multiplier (requires `FAST_MUL=1`); `0` = 1-cycle combinatorial |
| `FAST_DIV` | `0` | `1` = combinatorial divider; `0` = serial restoring divider (variable latency) |
| `FAST_SHIFT` | `1` | `1` = barrel shifter (1 cycle); `0` = 1-bit-per-cycle serial shifter |
| `BP_EN` | `1` | `1` = enable branch predictor; `0` = always-not-taken |
| `IBUF_EN` | `1` | `1` = enable instruction buffer; `0` = disable |
| `ZCMP_EN` | `1` | `1` = enable Zcmp extension; `0` = disable |
| `CG_EN` | `1` | `1` = insert CLKGATE_X1 ICG cells; `0` = data-path enable muxes |
| `DFT_EN` | `0` | `1` = DFT scan-test mode (CLKGATETST_X1 + SDFF scan FFs); implies `CG_EN=1` |

## Synthesis Results — RV32EC=1

> Source: `build/gate_count.rpt` (hierarchical Yosys synthesis, Nangate 45 nm OCL).
> Reference cell: NAND2\_X1 = 0.7980 µm².  SRAM macros treated as black-boxes (area excluded).
>
> Configuration: `RV32EC=1  RV32E_EN=1  RV32M_EN=0  JTAG_EN=0  AMO_EN=0`
> `FAST_MUL=0  FAST_DIV=0  FAST_SHIFT=0  BP_EN=0`

### Area Hierarchy (Gate Count)

| Module | NAND2-eq | Area (µm²) |
|---|---:|---:|
| **jv32_soc** | **42,328** | **33,778.01** |
| ↳ jv32_top | 31,713 | 25,306.71 |
| &nbsp;&nbsp;↳ jv32_core | 27,658 | 22,071.35 |
| &nbsp;&nbsp;&nbsp;&nbsp;↳ jv32_csr | 4,966 | 3,963.13 |
| &nbsp;&nbsp;&nbsp;&nbsp;↳ jv32_regfile | 4,780 | 3,814.71 |
| &nbsp;&nbsp;&nbsp;&nbsp;↳ jv32_rvc | 3,759 | 2,999.42 |
| &nbsp;&nbsp;&nbsp;&nbsp;↳ jv32_alu | 1,541 | 1,229.98 |
| &nbsp;&nbsp;&nbsp;&nbsp;↳ jv32_decoder | 443 | 353.78 |
| &nbsp;&nbsp;↳ sram_1rw | 253 | 202.16 |
| ↳ axi_clic | 5,464 | 4,360.54 |
| ↳ axi_uart | 3,699 | 2,951.80 |
| ↳ axi_xbar | 568 | 453.00 |

### Clock Gating Summary

> ICG cell: `CLKGATE_X1` / `CLKGATETST_X1` (Nangate 45 nm).
> Gated% = Gated\_FFs / Total\_FFs (FF clock driven by a CLKGATE GCK output).

| Module | Total FFs | Gated FFs | Gated% |
|---|---:|---:|---:|
| **jv32_soc** | **2,931** | **2,665** | **90.9%** |
| ↳ jv32_top | 2,105 | 1,911 | 90.8% |
| &nbsp;&nbsp;↳ jv32_core | 1,754 | 1,639 | 93.4% |
| &nbsp;&nbsp;&nbsp;&nbsp;↳ jv32_csr | 336 | 336 | 100.0% |
| &nbsp;&nbsp;&nbsp;&nbsp;↳ jv32_regfile | 480 | 480 | 100.0% |
| &nbsp;&nbsp;&nbsp;&nbsp;↳ jv32_rvc | 129 | 123 | 95.3% |
| &nbsp;&nbsp;&nbsp;&nbsp;↳ jv32_alu | 79 | 78 | 98.7% |
| &nbsp;&nbsp;&nbsp;&nbsp;↳ jv32_decoder | 0 | 0 | 0.0% |
| &nbsp;&nbsp;↳ sram_1rw | 2 | 0 | 0.0% |
| ↳ axi_clic | 361 | 297 | 82.3% |
| ↳ axi_uart | 386 | 382 | 99.0% |
| ↳ axi_xbar | 69 | 67 | 97.1% |

---

## Synthesis Results — RV32EC=0

> Source: `build/gate_count.rpt` (hierarchical Yosys synthesis, Nangate 45 nm OCL).
> Reference cell: NAND2\_X1 = 0.7980 µm².  SRAM macros treated as black-boxes (area excluded).
>
> Configuration: `RV32EC=0  RV32E_EN=0  RV32M_EN=1  JTAG_EN=1  AMO_EN=1`
> `FAST_MUL=1  MUL_MC=1  FAST_DIV=0  FAST_SHIFT=1  BP_EN=1  IBUF_EN=1`

### Area Hierarchy (Gate Count)

| Module | NAND2-eq | Area (µm²) |
|---|---:|---:|
| **jv32_soc** | **81,098** | **64,716.47** |
| ↳ jv32_top | 55,687 | 44,437.96 |
| &nbsp;&nbsp;↳ jv32_core | 51,630 | 41,200.47 |
| &nbsp;&nbsp;&nbsp;&nbsp;↳ jv32_alu | 17,431 | 13,909.94 |
| &nbsp;&nbsp;&nbsp;&nbsp;↳ jv32_regfile | 9,712 | 7,750.18 |
| &nbsp;&nbsp;&nbsp;&nbsp;↳ jv32_csr | 4,986 | 3,978.56 |
| &nbsp;&nbsp;&nbsp;&nbsp;↳ jv32_rvc | 3,798 | 3,030.54 |
| &nbsp;&nbsp;&nbsp;&nbsp;↳ jv32_decoder | 433 | 345.53 |
| &nbsp;&nbsp;↳ sram_1rw | 253 | 202.16 |
| ↳ jtag_top | 12,928 | 10,316.54 |
| &nbsp;&nbsp;↳ jtag_tap | 12,928 | 10,316.54 |
| &nbsp;&nbsp;&nbsp;&nbsp;↳ jv32_dtm | 7,911 | 6,313.24 |
| ↳ axi_clic | 5,472 | 4,366.92 |
| ↳ axi_uart | 3,755 | 2,996.22 |
| ↳ axi_xbar | 568 | 453.00 |

### Clock Gating Summary

> ICG cell: `CLKGATE_X1` / `CLKGATETST_X1` (Nangate 45 nm).
> Gated% = Gated\_FFs / Total\_FFs (FF clock driven by a CLKGATE GCK output).

| Module | Total FFs | Gated FFs | Gated% |
|---|---:|---:|---:|
| **jv32_soc** | **5,385** | **4,787** | **88.9%** |
| ↳ jv32_top | 3,201 | 3,039 | 94.9% |
| &nbsp;&nbsp;↳ jv32_core | 2,850 | 2,767 | 97.1% |
| &nbsp;&nbsp;&nbsp;&nbsp;↳ jv32_alu | 403 | 402 | 99.8% |
| &nbsp;&nbsp;&nbsp;&nbsp;↳ jv32_regfile | 992 | 992 | 100.0% |
| &nbsp;&nbsp;&nbsp;&nbsp;↳ jv32_csr | 336 | 336 | 100.0% |
| &nbsp;&nbsp;&nbsp;&nbsp;↳ jv32_rvc | 129 | 123 | 95.3% |
| &nbsp;&nbsp;&nbsp;&nbsp;↳ jv32_decoder | 0 | 0 | 0.0% |
| &nbsp;&nbsp;↳ sram_1rw | 2 | 0 | 0.0% |
| ↳ jtag_top | 1,248 | 886 | 71.0% |
| &nbsp;&nbsp;↳ jtag_tap | 1,248 | 886 | 71.0% |
| &nbsp;&nbsp;&nbsp;&nbsp;↳ jv32_dtm | 747 | 661 | 88.5% |
| ↳ axi_clic | 361 | 297 | 82.3% |
| ↳ axi_uart | 386 | 382 | 99.0% |
| ↳ axi_xbar | 69 | 67 | 97.1% |

The overall 88.9% gating rate is close to the theoretical maximum; the remaining ungated FFs are the CDC synchronizer chains in `jtag_top` described below.

#### Why `jtag_top` is lower (~71%)

`jtag_top` contains all CLK ↔ TCK clock-domain crossing (CDC) logic for the debug
interface.  Two-stage synchronizer chains on both sides of the domain boundary
**must sample on every clock edge** to guarantee metastability resolution; gating
their clock would violate the synchronizer setup time and defeat the purpose.

The 362 ungated FFs (1,248 − 886) are split across two modules:

**CLK → TCK** (in `jtag_tap`, clocked by `tck_i` — ~92 bits)
Status and result signals driven by `jv32_dtm` in the CLK domain are captured into
the TCK domain so the JTAG probe can read them during DMI scans:

| Synchronizer | Bits | Purpose |
|---|---:|---|
| `busy_tck_chain[1:0]`, `sba_busy_tck_chain[1:0]` | 4 | cmd-busy / SBA-busy back to probe |
| `halted_tck_chain[1:0]`, `resumeack_tck_chain[1:0]` | 4 | hart halted / resume-ack status |
| `cmderr_sync[1:0]` (3-bit) | 6 | abstract-command error code |
| `sb_err_tck_chain[1:0]` (3-bit) | 6 | SBA error bits |
| `data0_result_sync[1:0]` (32-bit) | 64 | abstract-command read-back data |
| `data0/1/sbdata0/sbaddress0_result_valid_sync[1:0]` | 8 | result-valid handshake bits |

**TCK → CLK** (in `jv32_dtm`, clocked by `clk` — ~270 bits)
JTAG-written payloads and toggle handshakes are captured from the TCK domain into
the CLK domain so the debug module can act on them:

| Synchronizer | Bits | Purpose |
|---|---:|---|
| `command_reg_tck_sync[1:0]` (32-bit) | 64 | command register payload |
| `data0_tck_sync[1:0]`, `data1_tck_sync[1:0]` (32-bit each) | 128 | abstract-command write data |
| `sbaddress0_stable_sync[1:0]` (32-bit) | 64 | SBA address payload |
| `sb_access_tck_sync[1:0]` (3-bit), `sb_autoincr_tck_sync[1:0]` | 8 | SBA control bits |
| Toggle handshakes (cmd\_wr, sba\_wr/rd, cmderr\_clr, sb\_err\_clr, …) | ~16 | write-valid and clear toggles |

These synchronizer FFs must toggle freely during debug accesses.  This is
**architecturally correct** — CDC synchronizers require free-running clocks.

## GDS Layout

KLayout view of the completed place-and-route GDS (`build/openlane_run/*/final/gds/jv32_soc.gds`), Nangate 45 nm FreePDK45.

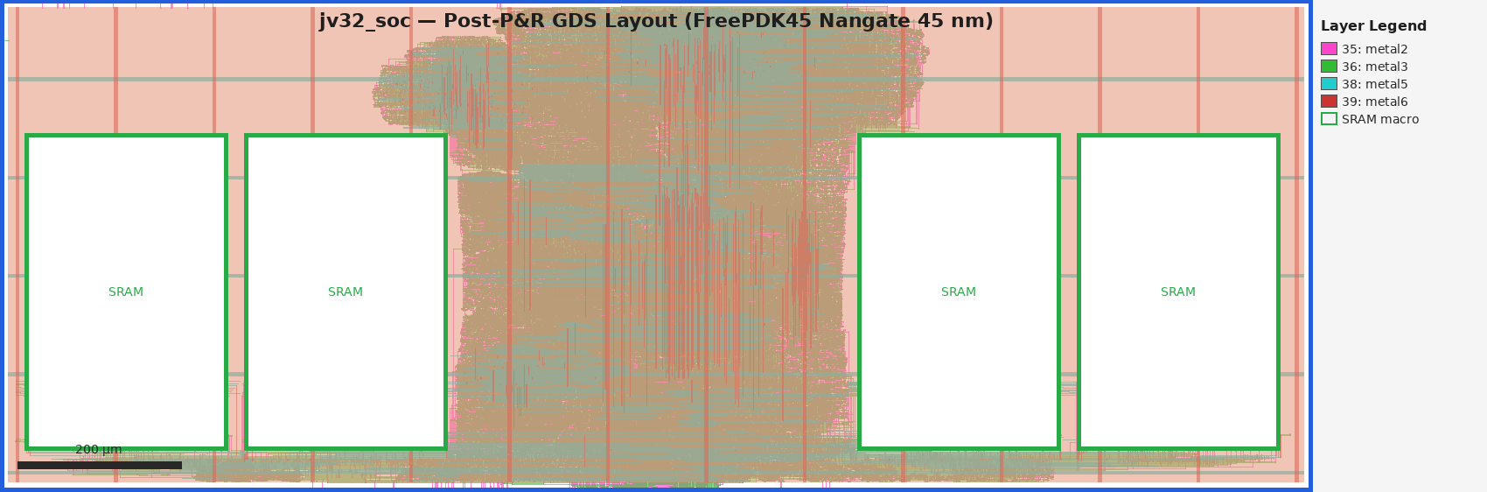
[picture p1: syn/layout.png]
jv32 SoC GDS layout — KLayout view


The four white rectangles at the bottom are the hardened SRAM macros (`sram_1rw_1024x64`, 4× for the TCM — 2 IRAM + 2 DRAM banks, 247.88 × 386.12 µm each, `words_per_row=4`).  The dense salmon-coloured region above is the placed standard-cell logic (jv32_core + JTAG/DTM + AXI peripherals); the blue horizontal stripes are metal power/ground rails.  Die: 1100 × 680 µm.
