kuopinghsu/jv32.dev/docs/performance_analysis.adoc

= JV32 Performance Analysis
:doctype: article
:toc: left
:toc-title: Table of Contents
:toclevels: 3
:sectnums:
:source-highlighter: rouge
:icons: font
:imagesdir: .

== Part I: Architecture for Performance

This section describes the microarchitectural features of the JV32 3-stage in-order
pipeline that are directly responsible for performance. Each feature is paired with the
parameter that controls it and a summary of the performance impact it provides.

=== Pipeline Overview

JV32 implements a 3-stage in-order pipeline: *IF → EX → WB*.

[cols="1,3", options="header"]
|===
| Stage | Function
| IF    | PC register, instruction fetch request via the RVC expander (`jv32_rvc`)
| EX    | Decode, register file read, ALU, address calculation, CSR, hazard detect
| WB    | Memory response, register writeback, redirect, exception
|===

The compact three-stage design keeps the branch misprediction penalty to a single
flush cycle and minimises the register-file-read-to-ALU latency.  The trade-off is
that every load instruction is directly followed by a one-cycle stall when the very
next instruction consumes the loaded value (load-use hazard).

The ideal CPI (no stalls, no hazards) is 1.0.  The sources of overhead in practice
are:

* *Load-use stalls* — the loaded value is not yet written back when the dependent
  instruction reaches EX.  This stall is inherent to a 3-stage pipeline and cannot
  be eliminated without a deeper pipeline or a store/load buffer.
* *Control hazards* — taken branches, JAL pre-decode misses, JALR redirects, and
  branch mispredictions each cost one pipeline flush cycle.
* *Multi-cycle arithmetic* — serial multiply/divide/shift (when FAST_* parameters
  are disabled) stall the entire pipeline until the operation completes.

=== Branch Predictor (`BP_EN`)

==== Motivation

In a 3-stage pipeline, a taken branch that is detected in the EX stage has already
caused the wrong-path instruction to enter the IF→EX register.  That instruction
must be squashed (one bubble inserted), costing one cycle.  For a workload with
~53 % taken-branch rate the overhead without any prediction is significant.

==== Implementation

JV32 implements a lightweight *static-plus-dynamic* predictor composed of three
layers that run in parallel at the RVC output (before the IF/EX register is written):

[cols="1,1,3", options="header"]
|===
| Layer | Type | Description
| BTFNT | Static | *Backward-Taken / Forward-Not-Taken*: if the branch immediate is
  negative (sign bit = 1 in `instr[31]`) the branch targets a lower address (a loop
  back-edge) and is predicted taken; otherwise not-taken.  This rule is correct for
  the majority of loop-back branches without any state.
| JAL pre-decode | Static unconditional | JAL encodes the full target in the
  instruction word.  The front-end pre-decodes JAL and redirects `pc_if` to the
  target in the same cycle the instruction is presented by the RVC, achieving
  *zero-penalty* JAL execution.
| L0 last-branch | 1-entry dynamic | A single entry that records the PC and target
  of the most recently *resolved* conditional branch plus whether it was actually
  taken.  On the next fetch of the same PC the L0 entry takes priority over BTFNT,
  allowing a forward-taken branch that was taken last time to be predicted taken
  again.  This catches recurring loop heads whose direction cannot be inferred from
  the sign bit alone.
| RAS | 2-entry Return Address Stack | A circular 2-entry stack that predicts JALR
  return targets.  On any JAL or JALR instruction with `rd ∈ {x1, x5}` (a call) the
  return address (PC+4 or PC+2 for compressed) is pushed.  On a JALR instruction
  with `rs1 ∈ {x1, x5}` and `rd ∉ {x1, x5}` (a return) the top of the stack is
  popped and used as the predicted next PC, redirecting `pc_if` in the same IF cycle
  and recording `bp_taken=1`.  In EX the actual JALR target is compared against
  `bp_pred_pc`; a mismatch causes a 1-cycle redirect flush; a match costs zero
  cycles.  The stack is flushed on any WB-stage redirect (exception, interrupt, mret).
  A 2-entry stack suffices for the call patterns in the target workloads (see
  <<RAS depth analysis>>).
|===

The predictor operates entirely in the IF stage, redirecting `pc_if` and recording
`bp_taken=1` in the IF/EX pipeline register.  In EX, the actual branch outcome is
compared against the prediction:

* *Correct prediction* (taken and predicted taken, or not-taken and not predicted):
  no redirect — zero-cycle penalty.
* *Misprediction* (wrong direction): one-cycle flush.
* *JALR with RAS hit* (return target correctly predicted at IF): zero-cycle penalty.
* *JALR with RAS miss* (mispredicted target or non-return JALR): one-cycle EX redirect.

==== Performance Impact

The branch predictor reduces the per-branch redirect rate from 52–53 % (all taken
branches) to 8.8–21.6 % (only mispredictions).  The result is a measurable CPI
improvement shown in <<Part II>>.

=== Register Forwarding

==== Motivation

In a 3-stage pipeline the write-back result of instruction _N_ is available at the
end of WB, one cycle after _N_ was in EX.  Without forwarding, instruction _N+1_
that reads the same register would have to stall two cycles waiting for the value to
propagate through WB back to the register file and be re-read in EX.

==== Implementation

JV32 implements a single WB→EX forwarding path.  Every cycle the WB stage checks
whether its write-back destination (`ex_wb_r.rd_addr`) matches either source
register (`dec_rs1`, `dec_rs2`) of the EX-stage instruction.  If a match is found
the forwarded result is selected instead of the register-file output:

[source,systemverilog]
----
always_comb begin
    fwd_rs1 = rs1_data;
    fwd_rs2 = rs2_data;
    if (ex_wb_r.valid && ex_wb_r.reg_we && ex_wb_r.rd_addr != 5'd0
        && (!load_uses_sram || dmem_resp_valid)) begin
        if (ex_wb_r.rd_addr == dec_rs1) fwd_rs1 = wb_rd_data;
        if (ex_wb_r.rd_addr == dec_rs2) fwd_rs2 = wb_rd_data;
    end
end
----

For non-load instructions (`wb_rd_data = ex_wb_r.rd_data`) the result is a
registered flip-flop output and is unconditionally stable, so forwarding is always
safe.  For load instructions the result is the combinatorial SRAM output
(`dmem_resp_data`) and forwarding is enabled only when `dmem_resp_valid=1`, i.e.
when the SRAM has provided a valid response.

==== Performance Impact

Forwarding eliminates all RAW (read-after-write) stalls *except* the load-use case.
Without forwarding, every instruction following a non-load register producer would
stall two cycles.  For the CoreMark workload this would add approximately 0.24 CPI
overhead (24 % of instructions produce a result consumed by the next instruction);
with forwarding only load-use stalls remain (~0.060 CPI).

==== Load-Use Stall (Residual Hazard)

When a load instruction is immediately followed by an instruction that consumes
the loaded register, the dependent instruction is stalled for exactly one cycle in
EX while the load completes its WB memory response:

[source]
----
Cycle N  : LOAD in EX — issues dmem_req_addr
Cycle N+1: LOAD in WB — dmem_resp_valid=1, wb_rd_data available
           Dependent in EX — STALL (load_use_stall=1)
           Forwarded wb_rd_data used by dependent in EX
Cycle N+2: Dependent in WB — retires
----

This is an inherent 3-stage pipeline constraint.  A *store buffer* (write queue)
would not eliminate this hazard; only a 4-stage pipeline (separating address
generation from data forwarding) or a value predictor could do so.

=== Fast Arithmetic Units

The pipeline stalls the entire pipeline while a multi-cycle arithmetic unit is in
use.  Three independent parameters control whether each unit is single-cycle or
multi-cycle.

==== Multiplier (`FAST_MUL`, `MUL_MC`)

[cols="1,1,1,3", options="header"]
|===
| FAST_MUL | MUL_MC | Latency | Description
| 0        | —      | Variable (1–32 cycles) | Serial shift-and-add.  Uses minimal
  flip-flop area but stalls the pipeline for each active bit.
| 1        | 1      | 2 cycles | Two-stage pipelined multiplier.  Stage 1 computes
  four unsigned 16×16 partial products; stage 2 accumulates and sign-corrects.
  Better timing closure than the 1-cycle variant.
| 1        | 0      | 1 cycle  | Fully combinatorial 32×32 multiplier.  No pipeline
  stall; `ready` is permanently asserted.  Maximum MUL throughput.
|===

For maximum performance this document uses `FAST_MUL=1 MUL_MC=0`.

==== Divider (`FAST_DIV`)

[cols="1,1,3", options="header"]
|===
| FAST_DIV | Latency | Description
| 0        | Variable (up to 32 cycles) | Serial restoring divider.  Very low area.
  Stalls the pipeline for the full quotient width.
| 1        | 1 cycle  | Fully combinatorial restoring divider.  Eliminates all DIV
  stall cycles.  Suitable when maximum performance is required and the timing
  constraint allows the combinatorial depth.
|===

==== Barrel Shifter (`FAST_SHIFT`)

[cols="1,1,3", options="header"]
|===
| FAST_SHIFT | Latency | Description
| 0          | Variable (0–31 cycles) | 1-bit-per-cycle serial shifter.  Minimum
  area but stalls for shift amounts > 0.
| 1          | 1 cycle  | Full-width barrel shifter (SLL/SRL/SRA all in one cycle).
  No pipeline stall for any shift amount.
|===

==== Performance Impact Summary

For a workload with 3.7 % MUL/DIV instructions (CoreMark) switching from fully
serial arithmetic (`FAST_MUL=0 FAST_DIV=0 FAST_SHIFT=0`) to fully fast arithmetic
can reduce arithmetic-stall overhead by tens of cycles per MUL and hundreds per DIV.
For Dhrystone (0.6 % MUL/DIV) the impact is smaller.  Both benchmarks in this
document use the maximum-performance configuration (`FAST_MUL=1 MUL_MC=0
FAST_DIV=1 FAST_SHIFT=1`).

=== RVC Instruction Decompressor (`jv32_rvc`)

==== Motivation

The RISC-V C extension (RVC) provides 16-bit encodings for the most common 32-bit
instructions.  Executing the same workload with compressed instructions reduces code
size by ~20–30 %, which improves utilisation of instruction-fetch bandwidth and
benefits real systems with an instruction cache.  The on-chip TCM used in simulation
does not cache, so the code-density advantage is absent in simulation; what
the RVC expander does cost is additional latency in the IF stage.

==== Implementation

`jv32_rvc` sits between the instruction memory response and the IF/EX pipeline
register.  It maintains a one-instruction buffer to handle the half-word alignment
case where a 32-bit instruction straddles a 4-byte boundary.  The expander converts
any 16-bit `C.*` instruction to its 32-bit `I/M` equivalent *before* the branch
predictor and decoder see the instruction, so all downstream logic remains ISA-width
agnostic.

The cost is:
* One extra cycle of fetch latency when a 32-bit instruction crosses a 4-byte
  boundary (one "alignment bubble").
* Slightly more complex `rvc_mem_ready` gating logic that can occasionally prevent
  the PC from advancing.

==== Performance Impact

In the simulation environment with single-cycle TCM the RVC path adds a small
overhead compared to uncompressed code (`rv32ima_zicsr`), as shown in <<Part II>>.
In a real system with instruction cache the picture reverses: smaller code means
fewer cache misses and higher effective fetch bandwidth.

=== Store Buffer

JV32 does *not* implement a store buffer.  Every store instruction issues its data
memory write from the WB stage and the pipeline waits for the write to complete
before the next instruction retires.  With single-cycle TCM this is not a bottleneck
because SRAM writes complete in one cycle.  In a system with a slower memory bus or
cache miss penalty a write buffer would improve performance by decoupling store
retirement from bus transactions, allowing subsequent instructions to execute while
the write is in flight.

=== Scoreboard (`SCOREBOARD_EN`)

==== Motivation

In a 3-stage in-order core, any multi-cycle ALU operation normally stalls the whole
pipeline until completion.  This is simple but wastes cycles when following
instructions are independent.

`SCOREBOARD_EN` introduces a lightweight non-blocking issue mode for selected
multi-cycle operations.  Instead of holding EX for the full operation latency, the
instruction can be dispatched into a dedicated in-flight slot while younger,
independent instructions continue to execute.

==== Current Implementation

The scoreboard mechanism in `jv32_core` is intentionally small and deterministic:

* A single in-flight slot tracks one outstanding multi-cycle op (`multi_slot_*`).
* A 32-bit busy vector (`reg_busy_sb`) tracks destination-register hazards.
* Issue-side checks enforce:
** RAW hazard (`sb_raw_hazard`): source reads blocked if source register is busy.
** WAW hazard (`sb_waw_hazard`): destination writes blocked if destination busy.
** Structural hazard (`sb_struct_hazard`): no second outstanding multi op.
* Dispatch occurs only when the op is known to be multi-cycle (`alu_ready=0`) and
  no exception/debug/redirect hazards are active.
* Completion occurs through decoupled ALU valid/result channels (`mul_mc_valid` and
  result lanes), then retires in program order via WB arbitration (`wb_arb_stall`
  protects ordering when EX/WB is occupied).

Current policy in this repository:

* Non-blocking path is enabled for MUL family only.
* DIV/REM remain on blocking path for strict trace-stability.
* When `FAST_SHIFT=0`, non-blocking MUL dispatch is disabled as a conservative
  stability guard.

Top-level integration (`jv32_top`) also applies an automatic no-benefit guard:

* `SCOREBOARD_ACTIVE = SCOREBOARD_EN && !(FAST_MUL && !MUL_MC && FAST_DIV && FAST_SHIFT)`

So in the fully single-cycle arithmetic configuration, the scoreboard is
automatically disabled before instantiating `jv32_core`.

// ============================================================================
[[Part II]]
== Part II: Performance Analysis

=== Simulation Environment

All results are obtained by running the Verilator RTL simulator of the JV32 SoC
with the following baseline parameters unless noted:

[source,make]
----
ARCH=rv32ima_zicsr  FAST_MUL=1  MUL_MC=0  FAST_DIV=1  FAST_SHIFT=1  BP_EN=1  IBUF_EN=1
----

The `rv32ima_zicsr` ISA selects RV32IMA with CSR instructions but *without* the C
(compressed) extension; `rv32imac_zicsr` additionally enables 16-bit compressed
instructions.  The simulation clock is 80 MHz (as assumed by the benchmarks for
score reporting).

NOTE: The detailed trace analyses (CPI decomposition, stall distribution) in
<<CPI Statistics from Trace Analysis>> were captured with `IBUF_EN=0`.
The impact of `IBUF_EN=1` is quantified separately in
<<Instruction Buffer (IBUF) Impact Analysis>>.

CPI is measured directly from the RTL trace: total clock cycles divided by total
retired instructions, both reported by the Verilator driver at end-of-simulation.

=== Maximum Performance Results

==== CoreMark

CoreMark v1.0 with 4 iterations (`-O3 -DITERATIONS=4 -DPERFORMANCE_RUN=1`).

[cols="2,2", options="header"]
|===
| Metric | Value
| CoreMark score | 374.65 iterations/s
| CoreMark/MHz | *3.75*
| Total cycles | 1,137,626
| Retired instructions | 1,033,494
| *CPI* | *1.101*
| Conditional branches | 196,858  (19.0 % of insns)
| Taken branches | 103,988  (52.8 % taken rate)
| BP mispredictions | 42,450  (21.6 % mispred rate, 78.4 % accuracy)
| JAL (pre-decoded) | 10,406  (0 % miss)
| JALR | 1,246
|===

==== Dhrystone

Dhrystone 2.1 with 1,000 runs (`-O3 -DREG= -DNO_PROTOTYPES`).

[cols="2,2", options="header"]
|===
| Metric | Value
| Dhrystones/s | 200,000
| DMIPS | 113
| *DMIPS/MHz* | *1.42*
| Total cycles | 456,914
| Retired instructions | 344,468
| *CPI* | *1.326*
| Conditional branches | 58,194  (16.9 % of insns)
| Taken branches | 31,073  (53.4 % taken rate)
| BP mispredictions | 5,108  (8.8 % mispred rate, 91.2 % accuracy)
| JAL (pre-decoded) | 10,643  (0 % miss)
| JALR | 9,584
|===

=== Scoreboard Impact Analysis

This section quantifies scoreboard benefit using fresh CoreMark runs from the
current RTL.

==== Results Table

[cols="3,1,1,1,1", options="header"]
|===
| Configuration
| SCOREBOARD_EN=1 cycles / CPI / CM/MHz
| SCOREBOARD_EN=0 cycles / CPI / CM/MHz
| Cycles saved (EN=1)
| Improvement

| `FAST_DIV=0 FAST_MUL=0 FAST_SHIFT=1` (serial MUL+DIV heavy)
| 1,400,506 / 1.359 / 3.023669
| 1,461,373 / 1.418 / 2.890107
| 60,867
| 4.17 % fewer cycles, 4.62 % higher CoreMark/MHz

| `FAST_MUL=1 MUL_MC=0 FAST_DIV=1 FAST_SHIFT=1` (all-fast arithmetic)
| 1,124,077 / 1.091 / 3.800894
| 1,124,077 / 1.091 / 3.800894
| 0
| No measurable benefit (auto-disabled in `jv32_top`)

| `FAST_MUL=1 MUL_MC=1 FAST_DIV=1 FAST_SHIFT=1` (pipelined MUL)
| 1,124,079 / 1.091 / 3.800894
| 1,124,079 / 1.091 / 3.800894
| 0
| No measurable CoreMark benefit; commit-order lock preserves correctness
|===

==== Analysis

In serial arithmetic mode, independent instructions can pass an outstanding MUL in
the scoreboard slot while preserving retirement order, reducing global pipeline
stall pressure.  The current implementation keeps DIV/REM on the blocking path,
so the observed gain comes from overlapping unrelated work with the outstanding
multi-cycle MUL.  This lowers CoreMark CPI from 1.418 to 1.359.

In all-fast mode, multiply/divide/shift are already single-cycle (or effectively
single-cycle for throughput), so there is no multi-cycle latency to hide.  The
scoreboard cannot improve issue bandwidth in this case; therefore auto-disabling it
at top level removes unnecessary logic activity without affecting performance.

With `MUL_MC=1`, the commit-order retirement lock enables safe overlap in the
non-blocking path, but CoreMark still shows no measurable gain because it does not
have enough long-latency multiply pressure for that overlap window to dominate CPI.

==== Notes: Scoreboard Overhead Estimate

This is a design-level estimate (not a measured synthesis/P&R report).

Expected hardware overhead of enabling scoreboard logic is small because the
implementation is a single in-flight slot plus lightweight hazard tracking:

* Gate-count estimate: low single-digit percent at core level, typically
  around ~1–3% of core control logic, and <1% at full-SoC level.
* Frequency impact estimate: negligible to small at target 80 MHz;
  practical expectation is no meaningful Fmax loss for this design point.

These estimates are consistent with the scoreboard structure used here
(`multi_slot_*`, `reg_busy_sb`, and simple RAW/WAW/structural checks), which adds
mostly narrow control/state logic rather than deep datapath arithmetic.

=== Branch Predictor Impact Analysis

To isolate the contribution of the branch predictor, `BP_EN=0` is used (all branches
default to predict-not-taken; JAL is no longer pre-decoded).  All other parameters
are unchanged.

==== Results Table

[cols="3,1,1,1,1,1,1", options="header"]
|===
| Configuration
| CoreMark/MHz | CoreMark CPI
| Cycles saved
| DMIPS/MHz | Dhry CPI
| Cycles saved

| `rv32ima, BP_EN=1` (BTFNT + L0 + JAL + RAS) *(current)*
| 3.75 | 1.101 | —
| 1.42 | 1.326 | —

| `rv32ima, BP_EN=1` (BTFNT + L0 + JAL, no RAS) *(pre-RAS)*
| 3.74 | 1.102 | +1,500
| 1.42 | 1.340 | +4,598

| `rv32ima, BP_EN=0` (predict-not-taken)
| 3.55 | 1.160 | +60,514
| 1.42 | 1.439 | +38,948
|===

==== Analysis

*CoreMark* (`BP_EN=1` vs `BP_EN=0`):

* Without the predictor, every taken branch (52.8 % of 196,892 = 104,004) and every
  JAL (10,407) causes a 1-cycle redirect: 114,411 potential stall cycles from
  control flow alone.
* With the predictor (BTFNT + L0 + JAL pre-decode), only mispredicted branches
  (42,471) and JALR (1,252) cause a redirect: ~43,723 stall cycles.
  JAL is always free (pre-decoded).
* Adding the RAS further eliminates most JALR redirect cycles (1,246 JALR).  Total
  cycle reduction (BP=0 vs BP=1+RAS): 1,198,463 − 1,137,949 = **60,514 cycles**
  (5.0 % of total).
* CPI improvement (BP=0 → BP=1+RAS): 1.160 → 1.101 = *5.4 %*.

*Dhrystone* (`BP_EN=1` vs `BP_EN=0`):

* Dhrystone's branch pattern is dominated by a small set of hot loops.  The L0
  last-branch entry learns each loop head quickly and reduces the misprediction rate
  from 53.4 % (BP=0) to only 8.8 % (BP=1).
* Without the predictor: 31,074 branch mispredictions + 10,644 JAL misses = 41,718
  stall cycles.  With predictor (no RAS): 5,108 mispredictions + 0 JAL misses = 5,108.
* Adding the RAS eliminates ~4,700 of the 9,584 JALR redirects (the remainder are
  calls deeper than the 8-entry stack or non-return indirect jumps).
* Total cycle reduction (BP=0 vs BP=1+RAS): 495,862 − 456,914 = **38,948 cycles**
  (7.9 % of total).
* CPI improvement (BP=0 → BP=1+RAS): 1.439 → 1.326 = *7.9 %*.

The larger relative gain on Dhrystone reflects the loop-heavy control flow: the L0
dynamic entry captures the dominant taken-loop pattern while BTFNT alone would
not.  CoreMark's more varied branch mix means the L0 entry gets evicted more
frequently, leaving BTFNT's static rule as the primary predictor.

==== Misprediction Rate Comparison

[cols="2,1,1,1,1", options="header"]
|===
| Benchmark
| BP_EN=0 mispred rate | BP_EN=0 accuracy
| BP_EN=1 mispred rate | BP_EN=1 accuracy

| CoreMark | 52.8 % | 47.2 % | 21.6 % | 78.4 %
| Dhrystone | 53.4 % | 46.6 % | 8.8 % | 91.2 %
|===

NOTE: With `BP_EN=0` the misprediction counter is incremented for every taken
branch (since the hardware always predicts not-taken) and for every JAL
(since JAL pre-decode is disabled).  The 100 % JAL miss rate and ~53 % branch
misprediction rate confirm the expected behavior.

=== Return Address Stack (RAS) Impact Analysis

The RAS provides zero-penalty prediction for JALR return instructions by pushing
return addresses on calls (JAL/JALR with `rd ∈ {x1, x5}`) and popping predicted
targets on returns (JALR with `rs1 ∈ {x1, x5}`, `rd ∉ {x1, x5}`).  Without the
RAS every JALR costs a 1-cycle EX redirect regardless of whether the target was
predictable.

==== No-RAS vs. RAS Results

[cols="3,1,1,1,1,1,1", options="header"]
|===
| Configuration
| CoreMark/MHz | CoreMark CPI
| Cycles saved
| DMIPS/MHz | Dhry CPI
| Cycles saved

| `BP_EN=1` + RAS 2-entry *(current)*
| 3.75 | 1.101 | —
| 1.42 | 1.326 | —

| `BP_EN=1`, `RAS_EN=0` (no RAS)
| 3.74 | 1.102 | +1,500
| 1.42 | 1.340 | +4,598
|===

==== No-RAS vs. RAS Analysis

*CoreMark*: Only 1,238 JALR instructions across 1,033,214 retired instructions
(0.12 %).  Even perfect RAS prediction would eliminate at most 1,238 redirect cycles
— a theoretical maximum gain of 0.001 CPI.  The measured improvement is
1,500 cycles (0.13 %), in line with this bound.  The RAS provides negligible benefit
for CoreMark.

*Dhrystone*: 9,584 JALR instructions across 344,468 retired instructions (2.8 %).
These arise from Dhrystone's call-heavy structure (`Proc_1` through `Proc_8`,
`strcmp`, `strcpy`).  The RAS correctly predicts approximately 4,600 returns
(~48 % hit rate), saving ~4,598 cycles (1.0 % of total) and improving CPI by 0.014
(1.04 %: 1.340 → 1.326).  The remaining ~4,984 JALR still cause a 1-cycle redirect
because the jump is not a standard function return or the return address was evicted.

NOTE: The DMIPS/MHz metric is computed using integer arithmetic inside the benchmark
firmware, producing a value of 1.41–1.42 depending on truncation rounding.  The
CPI measurement from the RTL simulator (`CPI=1.326`) is the authoritative figure;
it confirms a real 1.04 % cycle-count improvement over the no-RAS baseline.

[[RAS depth analysis]]
==== RAS Depth Analysis: 2-Entry vs. 8-Entry

[cols="3,1,1,1,1,1,1", options="header"]
|===
| RAS depth
| CoreMark/MHz | CoreMark CPI
| CoreMark cycles
| DMIPS/MHz | Dhry CPI
| Dhry cycles

| 8-entry RAS
| 3.75 | 1.101 | 1,137,949
| 1.42 | 1.326 | 456,914

| 2-entry RAS *(current)*
| 3.75 | 1.101 | 1,137,626
| 1.42 | 1.326 | 456,918
|===

The 2-entry RAS produces **identical CPI** to the 8-entry RAS on both benchmarks.
The cycle count difference is within simulation noise (< 0.03 % for CoreMark,
< 0.001 % for Dhrystone).  This result is explained by the call patterns of each
benchmark:

* *CoreMark*: JALR instructions are rare (0.12 % of all instructions); almost no
  return prediction occurs regardless of stack depth.
* *Dhrystone*: The hot call graph is shallow.  The main loop calls `Proc_1`, which
  calls `Proc_6` / `Proc_7` / `Proc_8` — a maximum observed nesting depth of 2
  live frames at any given time.  A 2-entry stack captures 100 % of these returns;
  a deeper stack offers no additional benefit.

The 2-entry RAS is therefore the optimal size for this design point: it captures all
practical return predictions at minimal area cost (two 32-bit registers + 1-bit
pointer vs. eight registers + 3-bit pointer for the 8-entry version).

=== Compressed Instruction (RVC) Impact Analysis

To assess the effect of the RVC decompressor, the same benchmarks are compiled and
simulated with `rv32imac_zicsr` (compressed enabled) and `rv32ima_zicsr` (no
compressed).  `BP_EN=1` throughout.

==== Results Table

[cols="3,1,1,1,1", options="header"]
|===
| Configuration
| CoreMark/MHz | CoreMark CPI
| DMIPS/MHz | Dhry CPI

| `rv32ima_zicsr` (no RVC)
| 3.74 | *1.102* | 1.42 | *1.340*

| `rv32imac_zicsr` (with RVC)
| 3.66 | 1.124   | 1.42 | 1.355
|===

==== Analysis

*CoreMark*:

* With compressed instructions the compiler generates a slightly different code
  layout.  Total retired instructions change marginally (1,033,749 → 1,035,673,
  +0.2 %) while total cycles increase more (1,139,449 → 1,163,737, +2.1 %).
* Net CPI increase: 1.102 → 1.124 (+2.0 %).
* The overhead comes from RVC alignment bubbles: whenever a 32-bit instruction
  straddles a 4-byte boundary the RVC expander holds the pipeline for one extra
  cycle while the second half-word arrives.

*Dhrystone*:

* CPI increase: 1.340 → 1.355 (+1.1 %).  The effect is smaller because Dhrystone
  has a higher proportion of memory-access and call/return instructions which
  compress well and benefit from shorter code paths.

*Simulation vs. real hardware trade-off*:

In the TCM-based simulation there is no instruction cache, so the reduced code size
from compressed encoding brings no bandwidth benefit.  On real silicon with an
instruction cache, compressed code reduces cache pressure, lowers the eviction rate,
and decreases power consumption — typically outweighing the small alignment overhead.
The simulation results therefore *understate* the true benefit of RVC in hardware.

=== CPI Statistics from Trace Analysis

The following analysis is derived from the `--rtl-trace` output
(`build/rtl_trace.txt`) by parsing instruction retirement cycle numbers.  Each trace
line records `N:C PC (INSTR) ...` where _N_ is the retirement index and _C_ is the
clock cycle.  The gap between consecutive retirement cycles reveals pipeline stalls.

Configuration: `ARCH=rv32ima_zicsr FAST_MUL=1 MUL_MC=0 FAST_DIV=1 FAST_SHIFT=1
BP_EN=1 TRACE=1`.

==== CPI Decomposition

The total CPI overhead is decomposed into two independent contributors by combining
trace data with the hardware branch predictor counters:

[.text-center]
*CPI = 1.0 (ideal) + CPI~redirect~ + CPI~mem-stall~*

[cols="3,1,1,1,1", options="header"]
|===
| CPI Component
| CoreMark value | CoreMark share
| Dhrystone value | Dhrystone share

| Ideal (1 instruction/cycle)
| 1.000 | 90.8 % | 1.000 | 75.4 %

| Redirect stalls (branch mispred + JALR miss)
| 0.041 | 3.7 %  | 0.029 |  2.2 %

| Memory stalls (load-use + alignment)
| 0.060 | 5.5 %  | 0.297 | 22.4 %

| *Total CPI*
| *1.101* | — | *1.326* | —
|===

Redirect stall contribution is calculated as:
CPI~redirect~ = (mispredictions + JALR_miss count) / retired instructions,
where JALR_miss counts JALR instructions that caused an EX-stage redirect (i.e.,
RAS mispredictions and non-return indirect jumps).

Memory stall contribution is the remainder: CPI~mem-stall~ = CPI − 1.0 − CPI~redirect~.

==== CoreMark Instruction Mix

Configuration: `rv32ima_zicsr`, 4-iteration performance run.

[cols="2,1,1", options="header"]
|===
| Instruction Class | Count | Share
| ALU (R-type, I-type, LUI, AUIPC) | 512,447 | 49.6 %
| Memory loads | 214,719 | 20.8 %
| Conditional branches | 196,892 | 19.0 %
| Memory stores | 59,583 | 5.8 %
| MUL / DIV | 38,249 | 3.7 %
| Jumps (JAL + JALR) | 11,655 | 1.1 %
| CSR operations | 3 | 0.0 %
| *Total* | *1,033,749* | —
|===

==== Dhrystone Instruction Mix

Configuration: `rv32ima_zicsr`, 1,000 runs.

[cols="2,1,1", options="header"]
|===
| Instruction Class | Count | Share
| ALU (R-type, I-type, LUI, AUIPC) | 184,532 | 53.6 %
| Memory loads | 83,752 | 24.3 %
| Conditional branches | 58,195 | 16.9 %
| Memory stores | 53,346 | 15.5 %
| Jumps (JAL + JALR) | 20,228 | 5.9 %
| MUL / DIV | 2,172 | 0.6 %
| CSR operations | 13 | 0.0 %
| *Total* | *344,473* | —
|===

NOTE: ALU count is computed as total minus the explicitly categorised classes; some
instructions fall into multiple categories (e.g. AUIPC is both ALU and PC-relative)
so the sum slightly exceeds 100 %.

==== Stall Cycle Distribution

The stall distribution is obtained by counting the cycle gap between consecutive
retired instructions.  Gap = 1 means no stall cycle; gap = _k_ means _k_−1 stall
cycles between two consecutive retirements.

.CoreMark stall distribution (`rv32ima_zicsr`, BP_EN=1)
[cols="2,1,1,2", options="header"]
|===
| Stall cycles between retirements | Count | Share of retired insns | Stall cycles contributed
| 0  (gap=1, no stall) | 958,445 | 92.7 % | 0
| 1  (gap=2)           | 50,092  | 4.8 %  | 50,092
| 2  (gap=3)           | 22,484  | 2.2 %  | 44,968
| 3  (gap=4)           | 1,585   | 0.2 %  | 4,755
| 5  (gap=6)           | 1,143   | 0.1 %  | 5,715
| *Total stall cycles* | —       | —      | *105,530 (9.3 % of all cycles)*
|===

.Dhrystone stall distribution (`rv32ima_zicsr`, BP_EN=1)
[cols="2,1,1,2", options="header"]
|===
| Stall cycles between retirements | Count | Share of retired insns | Stall cycles contributed
| 0  (gap=1, no stall) | 286,704 | 83.2 % | 0
| 1  (gap=2)           | 11,413  | 3.3 %  | 11,413
| 2  (gap=3)           | 36,774  | 10.7 % | 73,548
| 3  (gap=4)           | 8,001   | 2.3 %  | 24,003
| 5  (gap=6)           | 1,581   | 0.5 %  | 7,905
| *Total stall cycles* | —       | —      | *116,869 (25.3 % of all cycles)*
|===

==== Observations

*CoreMark* is a compute-intensive workload with a balanced instruction mix.  With
90.7 % of instructions retiring without any stall cycle, the pipeline is highly
efficient.  The dominant stall source is single-cycle gaps (4.8 %) from a
combination of load-use hazards (~6,369 instances) and the 42,471 branch
mispredictions.  The 2-cycle stalls (2.2 %) arise from dependent load-then-load
address chains (pointer dereference of a freshly loaded pointer), where the second
load must wait for both the first load's data and its own memory response.

*Dhrystone* has a very different profile.  Only 83.2 % of instructions retire
without stalling, and memory-related stalls dominate.  The 10.7 % share of 2-cycle
stall events is large: Dhrystone's string operations (`strcpy`, `strcmp`) generate
dense load/store sequences with heavy pointer chasing — the loaded pointer is
immediately used as the address of the next load, creating a load→address→load chain
that incurs one stall per hop.  With 24.3 % loads and 15.5 % stores (40 % combined
memory-access rate versus 26.6 % for CoreMark), load-use stalls dominate to such an
extent that CPI~mem-stall~ = 0.297 vs 0.060 for CoreMark — a
5× difference.  The branch predictor contribution has diverged significantly now that the RAS is
included: CPI~redirect~ = 0.041 for CoreMark vs 0.029 for Dhrystone.  The lower
Dhrystone value reflects the RAS successfully predicting ~4,700 of the 9,584 JALR
return instructions, reducing redirect-CPI from 0.043 (no RAS) to 0.029.

*Key insight*: the bottleneck for Dhrystone is *load-use latency*, not branch
prediction.  A deeper pipeline with a dedicated memory stage (4-stage IF→EX→MEM→WB)
would eliminate the load-use stall entirely; the current 3-stage design accepts this
stall as the price of a simpler, shorter pipeline with lower absolute clock-cycle
count for non-memory-intensive code.

=== B-Extension (Zba/Zbb/Zbs) Impact Analysis

When `RV32B_EN=1` (the default), the core implements three RISC-V bit-manipulation
sub-extensions:

* **Zba** (address generation): `SH1ADD`, `SH2ADD`, `SH3ADD` — scaled shift-and-add
  for computing array element addresses in a single instruction.
* **Zbb** (basic bit manipulation): `CLZ`, `CTZ`, `CPOP`, `ANDN`/`ORN`/`XNOR`,
  `MIN`/`MAX`/`MINU`/`MAXU`, `SEXT.B`/`SEXT.H`/`ZEXT.H`, `REV8`, `ORC.B`,
  `ROL`/`ROR`/`RORI`.
* **Zbs** (single-bit): `BCLR`, `BEXT`, `BINV`, `BSET` and their immediate forms.

The GCC compiler (`-march=rv32ima_zicsr_zba_zbb_zbs`) emits these instructions when
the extension is specified, replacing multi-instruction sequences.  The principal
benefits are reduced instruction count and shorter code size.  Each B instruction
executes in a single cycle with the same pipeline stall rules as ALU instructions.

==== Results Table

[cols="3,1,1,1,1,1,1", options="header"]
|===
| Configuration
| CoreMark/MHz | CoreMark CPI
| CoreMark insns
| DMIPS/MHz | Dhry CPI
| Dhry insns

| `rv32ima` + Zba/Zbb/Zbs *(B-ext, max perf)*
| *3.78* | 1.105 | 1,018,934
| 1.41 | 1.328 | 342,289

| `rv32ima` (no B-ext baseline)
| 3.75 | 1.101 | 1,033,494
| 1.42 | 1.326 | 344,468

| `rv32imac` + Zba/Zbb/Zbs *(B-ext + compressed)*
| 3.70 | 1.127 | 1,019,805
| 1.41 | 1.339 | 342,289

| `rv32imac` (no B-ext)
| 3.67 | 1.123 | 1,035,785
| 1.41 | 1.342 | 344,468
|===

All configurations use `FAST_MUL=1 MUL_MC=0 FAST_DIV=1 FAST_SHIFT=1 BP_EN=1 RAS_EN=1`.
Total cycle counts: rv32ima+B = 1,125,868; rv32ima = 1,137,626;
rv32imac+B = 1,149,474; rv32imac = 1,162,781.

==== Analysis

*CoreMark* — B-extension impact on `rv32ima`:

* Retired instructions: 1,033,494 → 1,018,934 (**−1.4 %**).  The compiler replaces
  multi-instruction bit-test, rotate, and address-computation sequences with single
  B instructions; the dominant substitution in CoreMark is array indexing using
  `SH2ADD`/`SH3ADD` and bitmask operations using `ANDN`/`ORN`.
* Total cycles: 1,137,626 → 1,125,868 (**−1.0 %**).  The smaller instruction count
  reduces pipeline pressure; CPI rises marginally (1.101 → 1.105) because the
  denser instruction stream produces slightly more load-use proximity, but the
  absolute cycle reduction dominates.
* **CoreMark/MHz gain: 3.75 → 3.78 (+0.8 %)**.

With compressed instructions (`rv32imac`) the gain is nearly identical at **+0.9 %**
(3.665 → 3.697), confirming that B-extension benefit is orthogonal to RVC.

*Dhrystone* — B-extension impact on `rv32ima`:

* Retired instructions: 344,468 → 342,289 (−0.6 %).  Dhrystone's string operations
  (`strcpy`, `strcmp`) and simple arithmetic loop benefit less from Zba/Zbb/Zbs than
  CoreMark's array-indexed workload.
* Total cycles: 456,914 → 454,707 (−0.5 %).
* CPI: 1.326 → 1.328 (within noise; the DMIPS firmware integer-rounds to 1.41 vs
  1.42, a truncation artefact of the benchmark's own reporting).
* **Net Dhrystone gain: negligible** — the Dhrystone instruction mix does not heavily
  exercise the instructions covered by Zba/Zbb/Zbs.

=== Instruction Buffer (IBUF) Impact Analysis

The 2-entry first-word-fall-through (FWFT) instruction buffer allows the fetch unit
to pre-fetch the next instruction word while the execute stage is occupied by a
multi-cycle operation or a load-use stall.  When the FIFO is empty the incoming
instruction word is forwarded directly to the decode stage without any pipeline
bubble (FWFT bypass); only when the decode stage is stalled does the fetched word
get written into the FIFO.

`IBUF_EN=0` disables the buffer entirely; `IBUF_EN=1` enables it (the default).
For RV32E targets the buffer is disabled regardless of `IBUF_EN` because the
reduced-register ISA profile is typically used in area-constrained contexts.

==== Results Table

All configurations use `FAST_MUL=1 MUL_MC=0 FAST_DIV=1 FAST_SHIFT=1 BP_EN=1 RAS_EN=1`.

[cols="3,1,1,1,1,1,1,1,1", options="header"]
|===
| Configuration
| CoreMark/MHz | CoreMark CPI | CoreMark cycles | CoreMark Δ cycles
| DMIPS/MHz | Dhry CPI | Dhry cycles | Dhry Δ cycles

| `rv32ima_zicsr`, IBUF_EN=0
| 3.746 | 1.101 | 1,137,626 | —
| 1.41  | 1.326 | 456,918   | —

| `rv32ima_zicsr`, IBUF_EN=1
| 3.753 | 1.097 | 1,133,293 | −4,333
| 1.41  | 1.328 | 457,604   | +686

| `rv32imac_zicsr`, IBUF_EN=0
| 3.665 | 1.123 | 1,162,781 | —
| 1.41  | 1.342 | 462,311   | —

| `rv32imac_zicsr`, IBUF_EN=1
| 3.670 | 1.119 | 1,158,391 | −4,390
| 1.41  | 1.347 | 463,897   | +1,586
|===

==== Analysis

*CoreMark* — IBUF benefit:

* `rv32ima`: enabling IBUF saves 4,333 cycles (−0.38 % cycles, +0.19 % CoreMark/MHz),
  reducing CPI from 1.101 to 1.097.  The improvement arises because the IBUF hides
  the gap between the end of a load-use or branch-redirect stall and the next
  instruction arriving from the memory subsystem: the buffer pre-fetches the
  following word during the stall cycle and delivers it immediately when the pipeline
  resumes.

* `rv32imac`: a similar saving of 4,390 cycles (−0.38 % cycles, +0.14 % CoreMark/MHz)
  reduces CPI from 1.123 to 1.119.  The relative cycle reduction is identical to the
  uncompressed case, confirming that the IBUF gain is driven by pipeline stall
  patterns rather than instruction alignment.

*Dhrystone* — IBUF overhead:

* IBUF_EN=1 increases Dhrystone cycle counts by 686 (+0.15 %) for `rv32ima` and
  1,586 (+0.34 %) for `rv32imac`.  The DMIPS/MHz headline score (integer-rounded) is
  unchanged at 1.41 in all cases, and the CPI difference is within ±0.005 — within
  simulation run-to-run variation for 1,000 Dhrystone iterations.

* The apparent overhead reflects Dhrystone's dense load-store access pattern:
  store-load sequences generate frequent FIFO drain-and-refill cycles.  Because the
  IBUF push condition includes a downstream-readiness check, the buffer accepts a new
  word slightly later in these patterns, adding the occasional extra cycle.

*Summary*: `IBUF_EN=1` is a net positive for CoreMark-style compute workloads (~+0.2 %
CoreMark/MHz) and neutral-to-negligible for Dhrystone.  The default setting of
`IBUF_EN=1` is recommended; `IBUF_EN=0` may be used to reduce area at the cost of a
~0.2 % CoreMark regression.

=== Summary Table

[cols="3,1,1,1,1", options="header"]
|===
| Configuration | CoreMark/MHz | CoreMark CPI | DMIPS/MHz | Dhry CPI

| `rv32ima` + Zba/Zbb/Zbs, BP=1+RAS, FAST_MUL=1 MUL_MC=0, FAST_DIV=1, FAST_SHIFT=1, IBUF_EN=1 *(B-ext, max perf)*
| *3.80* | *1.093* | *1.77* | *1.245*

| `rv32ima`, BP=1+RAS, FAST_MUL=1 MUL_MC=0, FAST_DIV=1, FAST_SHIFT=1, IBUF_EN=1 *(no B-ext baseline)*
| 3.77 | 1.089 | 1.77 | 1.244

| `rv32imac` + Zba/Zbb/Zbs, BP=1+RAS, IBUF_EN=0 *(B-ext + compressed)*
| 3.70 | 1.127 | 1.41 | 1.339

| `rv32ima`, BP=1 (no RAS), IBUF_EN=0 *(no RAS baseline)*
| 3.74 | 1.102 | 1.42 | 1.340

| `rv32ima`, BP=0, IBUF_EN=0 *(no branch predictor)*
| 3.55 | 1.160 | 1.42 | 1.439

| `rv32imac`, BP=1+RAS, IBUF_EN=1 *(with compressed)*
| 3.67 | 1.119 | 1.41 | 1.347
|===

NOTE: Rows marked `IBUF_EN=0` were measured before the IBUF feature was added and
represent the baseline for that sub-analysis; their relative deltas remain valid.
Rows with `IBUF_EN=1` reflect the current default.  The top two rows also include the
2-entry store queue improvement; older rows pre-date that change.

[cols="3,1,1", options="header"]
|===
| Feature | CoreMark gain | Dhrystone gain
| B-extension (Zba/Zbb/Zbs) | +0.8 % CoreMark | negligible
| Branch predictor (BTFNT + L0 + JAL pre-decode) | +5.3 % CPI | +6.9 % CPI
| Return Address Stack (2-entry RAS) | +0.1 % CPI | +1.0 % CPI
| Uncompressed vs compressed (rv32ima vs rv32imac) | +2.0 % CPI (simulation only) | +1.1 % CPI (simulation only)
| Instruction buffer (IBUF_EN=0 → 1) | +0.2 % CoreMark | negligible
| 2-entry store queue (gap=3 → 1 for sw→sw) | +0.6 % CPI | +6.5 % CPI
|===
