kuopinghsu/jv32.dev/fpga/rtl/jv32_fpga_top.sv

// ============================================================================
// File   : jv32_fpga_top.sv
// Project: JV32 RISC-V SoC
// Brief  : FPGA top-level wrapper – Xilinx KU5P (XCKU5PFFVB676)
//          Configurable for 4-wire JTAG (USE_CJTAG=0, default) or
//          2-wire cJTAG / OScan1 (USE_CJTAG=1).
//
// Pins
// ----
//   clk_50m       E18   LVCMOS18  50 MHz system clock
//
//   JTAG / cJTAG (LVCMOS33, shared physical connector)
//   jtag_tck_i    D11   TCK  (JTAG) / TCKC (cJTAG) – always input
//   jtag_tmsc_io  E12   TMS  (JTAG) / TMSC (cJTAG) – bidir IOBUF
//   jtag_tdi_i    C12   TDI  (JTAG only; tie to GND in cJTAG)
//   jtag_tdo_o    J12   TDO  (JTAG) / TMSC-out mirror (cJTAG) – J12
//
//   UART (LVCMOS33)
//   uart_tx_o     J14   TX
//   uart_rx_i     G12   RX
//
//   Heartbeat LED (LVCMOS33)
//   heartbeat_o   H9    LED6 — toggles every 2^24 retired instructions
//
//   1 Hz blink LED (LVCMOS33)
//   led1_o        J11   LED3 — 1 s on / 1 s off, generated from clk/rst_n
//   led2_o        J10   LED4 — invert of led1_o for cJTAG. 0 for JTAG
//
// Parameters
// ----------
//   USE_CJTAG  0 (default) = 4-wire JTAG
//              1           = 2-wire cJTAG (IEEE 1149.7 OScan1)
//
// Block Design
// ------------
//   jv32_bd_wrapper (IP Integrator BD) contains:
//     clk_wiz_0        – MMCM 50 MHz → 50 MHz clean clock
//     proc_sys_reset_0 – rst_n held low until MMCM locked
//     u_soc            – jv32_soc_fpga.v (Verilog BD wrapper for jv32_soc)
//   JTAG signals and UART are routed through the BD.
//   IOBUF and USE_CJTAG I/O mux remain in this top-level (Xilinx primitive).
// ============================================================================

module jv32_fpga_top #(
    parameter bit USE_CJTAG = 1'b1  // 0 = 4-wire JTAG, 1 = 2-wire cJTAG (default; matches fpga/Makefile)
) (
    input logic clk_50m,

    // JTAG / cJTAG – shared physical connector
    input  logic jtag_tck_i,    // TCK  (JTAG) / TCKC (cJTAG)  – D11
    inout  wire  jtag_tmsc_io,  // TMS  (JTAG) / TMSC (cJTAG)  – E12 bidir
    input  logic jtag_tdi_i,    // TDI  (JTAG only)             – C12
    output logic jtag_tdo_o,    // TDO (JTAG) / TMSC-out mirror (cJTAG) – J12

    // UART
    output logic uart_tx_o,
    input  logic uart_rx_i,

    // Heartbeat LED – H9, LVCMOS33 (LED6)
    output logic heartbeat_o,

    // 1 Hz blink LED – J11, LVCMOS33 (LED3)
    output logic led1_o,

    // 1 Hz blink LED – J10, LVCMOS33 (LED4)
    output logic led2_o
);

    // -----------------------------------------------------------------------
    // IP Integrator block design
    //   Contains: clk_wiz_0, proc_sys_reset_0, u_soc (jv32_soc_fpga)
    //   All AXI tie-offs, trace disable, and nTRST/ext_irq tie-offs are
    //   handled inside jv32_soc_fpga.v; this top only routes I/O.
    // -----------------------------------------------------------------------
    logic jtag_pin1_tms_o, jtag_pin1_tms_oe, jtag_pin3_tdo_o;

    jv32_bd_wrapper u_bd (
        .clk_in1         (clk_50m),
        .jtag_pin0_tck_i (jtag_tck_i),
        .jtag_pin1_tms_i (tmsc_in),     // from IOBUF below
        .jtag_pin2_tdi_i (jtag_tdi_i),  // jv32_soc_fpga muxes to 0 when USE_CJTAG=1
        .jtag_pin1_tms_o (jtag_pin1_tms_o),
        .jtag_pin1_tms_oe(jtag_pin1_tms_oe),
        .jtag_pin3_tdo_o (jtag_pin3_tdo_o),
        .uart_rx_i       (uart_rx_i),
        .uart_tx_o       (uart_tx_o),
        .heartbeat_o     (heartbeat_o),
        .led1_o          (led1_o),
        .led2_o          (led2_o)
    );

    // -----------------------------------------------------------------------
    // IOBUF for TMS / TMSC (C12)
    //
    // Xilinx IOBUF primitive:
    //   IO – bidirectional FPGA pad
    //   I  – fabric data driven to pad when T=0
    //   O  – fabric data read from pad
    //   T  – tristate enable: 1=tristate (input mode), 0=drive output
    //
    // JTAG mode  (USE_CJTAG=0): T is permanently 1 → pad is a pure input.
    // cJTAG mode (USE_CJTAG=1): T follows jtag_pin1_tms_oe; the SoC drives TMSC
    //                            during the TDO-capture OScan1 phase.
    // -----------------------------------------------------------------------
    logic tmsc_in;    // data read from TMS / TMSC pad
    logic tmsc_out;   // data driven to TMSC pad  (cJTAG only)
    logic tmsc_oe_n;  // IOBUF T: 1=tristate/input, 0=drive output

    IOBUF u_tmsc_iobuf (
        .IO(jtag_tmsc_io),
        .I (tmsc_out),
        .O (tmsc_in),
        .T (tmsc_oe_n)
    );

    if (USE_CJTAG) begin : g_cjtag_io
        // cJTAG: SoC drives TMSC and controls output-enable
        assign tmsc_out   = jtag_pin1_tms_o;
        assign tmsc_oe_n  = jtag_pin1_tms_oe;
        // FPGA workaround: in cJTAG (OScan1) TDO is embedded in TMSC, so
        // route tmsc_out to J12 (jtag_tdo_o / ADBUS2) to allow a standard
        // 4-wire probe to read TDO without bridging ADBUS2+ADBUS3 to TMSC.
        assign jtag_tdo_o = jtag_pin1_tms_o;
    end
    else begin : g_jtag_io
        // JTAG: TMS is always an input – permanently tristate the IOBUF
        assign tmsc_out   = 1'b0;
        assign tmsc_oe_n  = 1'b1;
        assign jtag_tdo_o = jtag_pin3_tdo_o;
    end

endmodule
