kuopinghsu/jv32.dev/testbench/tb_jv32_soc.sv

// ============================================================================
// File: tb_jv32_soc.sv
// Project: JV32 RISC-V Processor
// Description: Verilator Testbench Wrapper for JV32 SoC
// ============================================================================

`timescale 1ns / 1ps

/* verilator coverage_off */
module tb_jv32_soc #(
    parameter int unsigned        CLK_FREQ      = 80_000_000,
    parameter bit                 USE_CJTAG     = 1'b0,
    parameter int unsigned        IRAM_SIZE     = 128 * 1024,
    parameter int unsigned        DRAM_SIZE     = 128 * 1024,
    parameter bit                 RV32E_EN      = 1'b0,
    parameter bit                 RV32M_EN      = 1'b1,
    parameter bit                 JTAG_EN       = 1'b1,
    parameter bit                 AMO_EN        = 1'b1,
    parameter bit                 FAST_MUL      = 1'b1,
    parameter bit                 MUL_MC        = 1'b1,
    parameter bit                 FAST_DIV      = 1'b0,
    parameter bit                 FAST_SHIFT    = 1'b1,
    parameter bit                 SCOREBOARD_EN = 1'b1,
    parameter bit                 BP_EN         = 1'b1,
    parameter bit                 RAS_EN        = 1'b1,
    parameter bit                 IBUF_EN       = 1'b1,
    parameter bit                 RV32B_EN      = 1'b1,
    parameter bit                 ZCMP_EN       = 1'b1,
    parameter logic        [31:0] BOOT_ADDR     = 32'h8000_0000,
    parameter logic        [31:0] IRAM_BASE     = 32'h8000_0000,
    parameter logic        [31:0] DRAM_BASE     = 32'h9000_0000
) (
    input logic clk,
    input logic rst_n,

    // Trace enable: set 1 to enable trace outputs, 0 to suppress (save power)
    input logic trace_en,

    // Trace outputs
    output logic        trace_valid,
    output logic        trace_reg_we,
    output logic [31:0] trace_pc,
    output logic [ 4:0] trace_rd,
    output logic [31:0] trace_rd_data,
    output logic [31:0] trace_instr,
    output logic        trace_mem_we,
    output logic        trace_mem_re,
    output logic [31:0] trace_mem_addr,
    output logic [31:0] trace_mem_data,
    output logic        trace_irq_taken,
    output logic [31:0] trace_irq_cause,
    output logic [31:0] trace_irq_epc,
    output logic        trace_irq_store_we,
    output logic [31:0] trace_irq_store_addr,
    output logic [31:0] trace_irq_store_data,

    // Branch predictor performance counters
    output logic perf_bp_branch,
    output logic perf_bp_taken,
    output logic perf_bp_mispred,
    output logic perf_bp_jal,
    output logic perf_bp_jal_miss,
    output logic perf_bp_jalr,
    output logic heartbeat_o,

    // DPI-C memory init
    input  logic uart_rx_i,
    output logic uart_tx_o_monitor, // UART TX line for exit-drain detection

    // Exposed JTAG / cJTAG pins for debugger-driven simulation
    input  logic jtag_ntrst_i,
    input  logic jtag_pin0_tck_i,
    input  logic jtag_pin1_tms_i,
    output logic jtag_pin1_tms_o,
    output logic jtag_pin1_tms_oe,
    input  logic jtag_pin2_tdi_i,
    output logic jtag_pin3_tdo_o,
    output logic jtag_pin3_tdo_oe
);
    import "DPI-C" function void sim_request_exit(input int exit_code);

    // DPI-C exports for ELF loading (called from elfloader.cpp)
    export "DPI-C" function mem_write_byte;
    export "DPI-C" function mem_read_byte;

    // DPI-C export: read GPR by index (used for Ctrl-C register dump)
    export "DPI-C" function get_gpr;

    // DPI-C export: pipeline snapshot for Konata pipeline visualizer
    export "DPI-C" function get_pipeline_snapshot;

    localparam int unsigned IRAM_LIMIT      = IRAM_BASE + IRAM_SIZE;
    localparam int unsigned DRAM_LIMIT      = DRAM_BASE + DRAM_SIZE;
    localparam logic [31:0] IRAM_ALIAS_BASE = 32'h6000_0000;
    localparam logic [31:0] DRAM_ALIAS_BASE = 32'h7000_0000;
    localparam logic [31:0] EXTRAM_BASE     = 32'hA000_0000;
    localparam int unsigned EXTRAM_SIZE     = 2 * 1024 * 1024;  // 2 MB

    // External TCM AXI master wires (driven by testbench alias bridge)
    logic [31:0] s_iram_tcm_araddr;
    logic        s_iram_tcm_arvalid;
    logic        s_iram_tcm_arready;
    logic [31:0] s_iram_tcm_rdata;
    logic [ 1:0] s_iram_tcm_rresp;
    logic        s_iram_tcm_rvalid;
    logic        s_iram_tcm_rready;
    logic [31:0] s_iram_tcm_awaddr;
    logic        s_iram_tcm_awvalid;
    logic        s_iram_tcm_awready;
    logic [31:0] s_iram_tcm_wdata;
    logic [ 3:0] s_iram_tcm_wstrb;
    logic        s_iram_tcm_wvalid;
    logic        s_iram_tcm_wready;
    logic [ 1:0] s_iram_tcm_bresp;
    logic        s_iram_tcm_bvalid;
    logic        s_iram_tcm_bready;

    logic [31:0] s_dram_tcm_araddr;
    logic        s_dram_tcm_arvalid;
    logic        s_dram_tcm_arready;
    logic [31:0] s_dram_tcm_rdata;
    logic [ 1:0] s_dram_tcm_rresp;
    logic        s_dram_tcm_rvalid;
    logic        s_dram_tcm_rready;
    logic [31:0] s_dram_tcm_awaddr;
    logic        s_dram_tcm_awvalid;
    logic        s_dram_tcm_awready;
    logic [31:0] s_dram_tcm_wdata;
    logic [ 3:0] s_dram_tcm_wstrb;
    logic        s_dram_tcm_wvalid;
    logic        s_dram_tcm_wready;
    logic [ 1:0] s_dram_tcm_bresp;
    logic        s_dram_tcm_bvalid;
    logic        s_dram_tcm_bready;

    // SoC external AXI slave interface (out-of-peripheral path).
    logic [31:0] ext_axi_araddr;
    logic        ext_axi_arvalid;
    logic        ext_axi_rready;
    logic [31:0] ext_axi_awaddr;
    logic        ext_axi_awvalid;
    logic [31:0] ext_axi_wdata;
    logic [ 3:0] ext_axi_wstrb;
    logic        ext_axi_wvalid;
    logic        ext_axi_bready;
    logic        ext_axi_arready;
    logic [31:0] ext_axi_rdata;
    logic [ 1:0] ext_axi_rresp;
    logic        ext_axi_rvalid;
    logic        ext_axi_awready;
    logic        ext_axi_wready;
    logic [ 1:0] ext_axi_bresp;
    logic        ext_axi_bvalid;

    // External RAM (axi_memory at 0xA000_0000, 2 MB)
    logic extram_arready, extram_rvalid, extram_rlast;
    logic [31:0] extram_rdata;
    logic [ 1:0] extram_rresp;
    logic extram_awready, extram_wready, extram_bvalid;
    logic [1:0] extram_bresp;
    logic extram_arvalid_d, extram_awvalid_d, extram_wvalid_d;
    logic extram_bready_d, extram_rready_d;

    function automatic logic in_iram_alias(input logic [31:0] addr);
        return (addr & ~(32'(IRAM_SIZE) - 32'h1)) == (IRAM_ALIAS_BASE & ~(32'(IRAM_SIZE) - 32'h1));
    endfunction

    function automatic logic in_dram_alias(input logic [31:0] addr);
        return (addr & ~(32'(DRAM_SIZE) - 32'h1)) == (DRAM_ALIAS_BASE & ~(32'(DRAM_SIZE) - 32'h1));
    endfunction

    function automatic logic in_extram(input logic [31:0] addr);
        return (addr >= EXTRAM_BASE) && (addr < 32'(EXTRAM_BASE + EXTRAM_SIZE));
    endfunction

    function automatic logic [31:0] alias_to_tcm_addr(input logic [31:0] addr);
        if (in_iram_alias(addr)) return IRAM_BASE + (addr - IRAM_ALIAS_BASE);
        if (in_dram_alias(addr)) return DRAM_BASE + (addr - DRAM_ALIAS_BASE);
        return addr;
    endfunction

    typedef enum logic [2:0] {
        TB_ALIAS_IDLE,
        TB_ALIAS_RD_ADDR,
        TB_ALIAS_RD_RESP,
        TB_ALIAS_WR_REQ,
        TB_ALIAS_WR_RESP
    } tb_alias_state_e;

    tb_alias_state_e        tb_alias_state;
    logic            [31:0] tb_alias_addr_r;
    logic tb_alias_aw_done, tb_alias_w_done;
    logic tb_alias_is_iram;
    logic tb_alias_rd_sel, tb_alias_wr_sel;
    logic tb_alias_active;
    logic tb_is_extram;
    logic tb_extram_rd_sel, tb_extram_wr_sel;
    logic decerr_bpending;
    logic alias_arready, alias_rvalid, alias_awready, alias_wready, alias_bvalid;
    logic [31:0] alias_rdata;
    logic [1:0] alias_rresp, alias_bresp;

    assign tb_alias_rd_sel = (tb_alias_state == TB_ALIAS_IDLE) && ext_axi_arvalid && (in_iram_alias(
        ext_axi_araddr
    ) || in_dram_alias(
        ext_axi_araddr
    ));

    assign tb_alias_wr_sel = (tb_alias_state == TB_ALIAS_IDLE) && ext_axi_awvalid && (in_iram_alias(
        ext_axi_awaddr
    ) || in_dram_alias(
        ext_axi_awaddr
    ));

    assign tb_extram_rd_sel = (tb_alias_state == TB_ALIAS_IDLE) && ext_axi_arvalid && in_extram(ext_axi_araddr);
    assign tb_extram_wr_sel = (tb_alias_state == TB_ALIAS_IDLE) && ext_axi_awvalid && in_extram(ext_axi_awaddr);

    assign tb_alias_active = (tb_alias_state != TB_ALIAS_IDLE);

    assign alias_arready = tb_is_extram ? extram_arready : (tb_alias_is_iram ? s_iram_tcm_arready : s_dram_tcm_arready);
    assign alias_rvalid = tb_is_extram ? extram_rvalid : (tb_alias_is_iram ? s_iram_tcm_rvalid : s_dram_tcm_rvalid);
    assign alias_rdata = tb_is_extram ? extram_rdata : (tb_alias_is_iram ? s_iram_tcm_rdata : s_dram_tcm_rdata);
    assign alias_rresp = tb_is_extram ? extram_rresp : (tb_alias_is_iram ? s_iram_tcm_rresp : s_dram_tcm_rresp);
    assign alias_awready = tb_is_extram ? extram_awready : (tb_alias_is_iram ? s_iram_tcm_awready : s_dram_tcm_awready);
    assign alias_wready = tb_is_extram ? extram_wready : (tb_alias_is_iram ? s_iram_tcm_wready : s_dram_tcm_wready);
    assign alias_bvalid = tb_is_extram ? extram_bvalid : (tb_alias_is_iram ? s_iram_tcm_bvalid : s_dram_tcm_bvalid);
    assign alias_bresp = tb_is_extram ? extram_bresp : (tb_alias_is_iram ? s_iram_tcm_bresp : s_dram_tcm_bresp);

    always_ff @(posedge clk or negedge rst_n) begin
        if (!rst_n) begin
            tb_alias_state   <= TB_ALIAS_IDLE;
            tb_alias_addr_r  <= 32'h0;
            tb_alias_aw_done <= 1'b0;
            tb_alias_w_done  <= 1'b0;
            tb_alias_is_iram <= 1'b0;
            tb_is_extram     <= 1'b0;
        end
        else begin
            case (tb_alias_state)
                TB_ALIAS_IDLE: begin
                    tb_alias_aw_done <= 1'b0;
                    tb_alias_w_done  <= 1'b0;
                    tb_is_extram     <= 1'b0;
                    if (tb_alias_rd_sel) begin
                        tb_alias_addr_r  <= alias_to_tcm_addr(ext_axi_araddr);
                        tb_alias_is_iram <= in_iram_alias(ext_axi_araddr);
                        tb_alias_state   <= TB_ALIAS_RD_ADDR;
                    end
                    else if (tb_alias_wr_sel) begin
                        tb_alias_addr_r  <= alias_to_tcm_addr(ext_axi_awaddr);
                        tb_alias_is_iram <= in_iram_alias(ext_axi_awaddr);
                        tb_alias_state   <= TB_ALIAS_WR_REQ;
                    end
                    else if (tb_extram_rd_sel) begin
                        tb_alias_addr_r  <= ext_axi_araddr;
                        tb_alias_is_iram <= 1'b0;
                        tb_is_extram     <= 1'b1;
                        tb_alias_state   <= TB_ALIAS_RD_ADDR;
                    end
                    else if (tb_extram_wr_sel) begin
                        tb_alias_addr_r  <= ext_axi_awaddr;
                        tb_alias_is_iram <= 1'b0;
                        tb_is_extram     <= 1'b1;
                        tb_alias_state   <= TB_ALIAS_WR_REQ;
                    end
                end

                TB_ALIAS_RD_ADDR: begin
                    if (alias_arready) tb_alias_state <= TB_ALIAS_RD_RESP;
                end

                TB_ALIAS_RD_RESP: begin
                    if (alias_rvalid && ext_axi_rready) tb_alias_state <= TB_ALIAS_IDLE;
                end

                TB_ALIAS_WR_REQ: begin
                    if (!tb_alias_aw_done && alias_awready) tb_alias_aw_done <= 1'b1;
                    if (!tb_alias_w_done && ext_axi_wvalid && alias_wready) tb_alias_w_done <= 1'b1;
                    if ((tb_alias_aw_done || alias_awready) && (tb_alias_w_done || (ext_axi_wvalid && alias_wready)))
                        tb_alias_state <= TB_ALIAS_WR_RESP;
                end

                TB_ALIAS_WR_RESP: begin
                    if (alias_bvalid && ext_axi_bready) tb_alias_state <= TB_ALIAS_IDLE;
                end

                default: tb_alias_state <= TB_ALIAS_IDLE;
            endcase
        end
    end

    // Latch a pending DECERR B-response for non-alias unmapped writes.
    // bvalid must stay asserted until bready, but wvalid drops before
    // jv32_top transitions from BUS_DAW to BUS_DB and asserts bready.
    always_ff @(posedge clk or negedge rst_n) begin
        if (!rst_n) begin
            decerr_bpending <= 1'b0;
        end
        else begin
            if (!tb_alias_active && !tb_alias_wr_sel && !tb_extram_wr_sel && ext_axi_wvalid && !decerr_bpending)
                decerr_bpending <= 1'b1;
            else if (decerr_bpending && ext_axi_bready) decerr_bpending <= 1'b0;
        end
    end

    // Extram axi_memory inputs driven from FSM state
    assign extram_arvalid_d = (tb_alias_state == TB_ALIAS_RD_ADDR) && tb_is_extram;
    assign extram_awvalid_d = (tb_alias_state == TB_ALIAS_WR_REQ) && !tb_alias_aw_done && tb_is_extram;
    assign extram_wvalid_d  = (tb_alias_state == TB_ALIAS_WR_REQ) && !tb_alias_w_done && ext_axi_wvalid && tb_is_extram;
    assign extram_bready_d  = (tb_alias_state == TB_ALIAS_WR_RESP) && tb_is_extram ? ext_axi_bready : 1'b0;
    assign extram_rready_d  = (tb_alias_state == TB_ALIAS_RD_RESP) && tb_is_extram ? ext_axi_rready : 1'b0;

    // Drive external TCM slave interfaces from testbench alias bridge.
    always_comb begin
        s_iram_tcm_araddr = tb_alias_addr_r;
        s_iram_tcm_arvalid = (tb_alias_state == TB_ALIAS_RD_ADDR) && tb_alias_is_iram && !tb_is_extram;
        s_iram_tcm_rready = (tb_alias_state == TB_ALIAS_RD_RESP && tb_alias_is_iram && !tb_is_extram) ? ext_axi_rready : 1'b0;
        s_iram_tcm_awaddr = tb_alias_addr_r;
        s_iram_tcm_awvalid = (tb_alias_state == TB_ALIAS_WR_REQ) && !tb_alias_aw_done && tb_alias_is_iram && !tb_is_extram;
        s_iram_tcm_wdata = ext_axi_wdata;
        s_iram_tcm_wstrb = ext_axi_wstrb;
        s_iram_tcm_wvalid  = (tb_alias_state == TB_ALIAS_WR_REQ) && !tb_alias_w_done && ext_axi_wvalid && tb_alias_is_iram && !tb_is_extram;
        s_iram_tcm_bready = (tb_alias_state == TB_ALIAS_WR_RESP && tb_alias_is_iram && !tb_is_extram) ? ext_axi_bready : 1'b0;

        s_dram_tcm_araddr = tb_alias_addr_r;
        s_dram_tcm_arvalid = (tb_alias_state == TB_ALIAS_RD_ADDR) && !tb_alias_is_iram && !tb_is_extram;
        s_dram_tcm_rready = (tb_alias_state == TB_ALIAS_RD_RESP && !tb_alias_is_iram && !tb_is_extram) ? ext_axi_rready : 1'b0;
        s_dram_tcm_awaddr = tb_alias_addr_r;
        s_dram_tcm_awvalid = (tb_alias_state == TB_ALIAS_WR_REQ) && !tb_alias_aw_done && !tb_alias_is_iram && !tb_is_extram;
        s_dram_tcm_wdata = ext_axi_wdata;
        s_dram_tcm_wstrb = ext_axi_wstrb;
        s_dram_tcm_wvalid  = (tb_alias_state == TB_ALIAS_WR_REQ) && !tb_alias_w_done && ext_axi_wvalid && !tb_alias_is_iram && !tb_is_extram;
        s_dram_tcm_bready = (tb_alias_state == TB_ALIAS_WR_RESP && !tb_alias_is_iram && !tb_is_extram) ? ext_axi_bready : 1'b0;

        // Alias hits are rerouted into TCM; extram hits go to axi_memory;
        // non-alias external accesses return DECERR so unmatched traffic
        // does not hang simulation.
        // Treat pending alias/extram selection in IDLE as owned by that path to
        // avoid issuing a premature DECERR response in the handoff cycle.
        if (tb_alias_active || tb_alias_rd_sel || tb_alias_wr_sel || tb_extram_rd_sel || tb_extram_wr_sel) begin
            ext_axi_arready = (tb_alias_state == TB_ALIAS_RD_ADDR) ? alias_arready : 1'b0;
            ext_axi_rvalid  = (tb_alias_state == TB_ALIAS_RD_RESP) ? alias_rvalid : 1'b0;
            ext_axi_rdata   = alias_rdata;
            ext_axi_rresp   = (tb_alias_state == TB_ALIAS_RD_RESP) ? alias_rresp : 2'b00;
            ext_axi_awready = (tb_alias_state == TB_ALIAS_WR_REQ && !tb_alias_aw_done) ? alias_awready : 1'b0;
            ext_axi_wready  = (tb_alias_state == TB_ALIAS_WR_REQ && !tb_alias_w_done) ? alias_wready : 1'b0;
            ext_axi_bvalid  = (tb_alias_state == TB_ALIAS_WR_RESP) ? alias_bvalid : 1'b0;
            ext_axi_bresp   = (tb_alias_state == TB_ALIAS_WR_RESP) ? alias_bresp : 2'b00;
        end
        else begin
            ext_axi_arready = 1'b1;
            ext_axi_rvalid  = ext_axi_arvalid;
            ext_axi_rdata   = 32'h0;
            ext_axi_rresp   = 2'b11;
            ext_axi_awready = 1'b1;
            ext_axi_wready  = 1'b1;
            ext_axi_bvalid  = decerr_bpending;
            ext_axi_bresp   = 2'b11;
        end
    end

    function void mem_write_byte(input int addr, input byte data);
        automatic int unsigned uaddr = unsigned'(addr);
        if (uaddr >= IRAM_BASE && uaddr < IRAM_LIMIT) begin
            automatic int offset = uaddr - IRAM_BASE;
            automatic int bank = offset & 3;
            automatic int widx = offset >> 2;
            u_soc.u_jv32.u_iram.mem[widx][bank*8+:8] = data;
        end
        else if (uaddr >= DRAM_BASE && uaddr < DRAM_LIMIT) begin
            automatic int offset = uaddr - DRAM_BASE;
            automatic int bank = offset & 3;
            automatic int widx = offset >> 2;
            u_soc.u_jv32.u_dram.mem[widx][bank*8+:8] = data;
        end
        else if (uaddr >= EXTRAM_BASE && uaddr < 32'(EXTRAM_BASE + EXTRAM_SIZE)) begin
            automatic int offset = uaddr - EXTRAM_BASE;
            u_extram.mem[offset] = data;
        end
    endfunction

    function byte mem_read_byte(input int addr);
        automatic int unsigned uaddr = unsigned'(addr);
        if (uaddr >= IRAM_BASE && uaddr < IRAM_LIMIT) begin
            automatic int offset = uaddr - IRAM_BASE;
            automatic int bank = offset & 3;
            automatic int widx = offset >> 2;
            return byte'(u_soc.u_jv32.u_iram.mem[widx][bank*8+:8]);
        end
        else if (uaddr >= DRAM_BASE && uaddr < DRAM_LIMIT) begin
            automatic int offset = uaddr - DRAM_BASE;
            automatic int bank = offset & 3;
            automatic int widx = offset >> 2;
            return byte'(u_soc.u_jv32.u_dram.mem[widx][bank*8+:8]);
        end
        else if (uaddr >= EXTRAM_BASE && uaddr < 32'(EXTRAM_BASE + EXTRAM_SIZE)) begin
            automatic int offset = uaddr - EXTRAM_BASE;
            return byte'(u_extram.mem[offset]);
        end
        return 8'hFF;
    endfunction

    // Read GPR by index (0=zero..31=t6) for Ctrl-C register dump
    function int get_gpr(input int idx);
        if (idx <= 0 || idx > 31) return 0;
        return int'(u_soc.u_jv32.u_core.u_regfile.regs[idx]);
    endfunction

    // Pipeline snapshot for Konata visualizer (called once per rising edge).
    // Exports IF/EX/WB pipeline register state, stall, flush, and branch
    // redirect information for use by the KanataRTL C++ class.
    //
    // IF stage  : instruction at rvc_instr output (ready to enter EX)
    // EX stage  : instruction in if_ex_r (decode + execute)
    // WB stage  : instruction in ex_wb_r (writeback / memory completion)
    function void get_pipeline_snapshot(
        // IF stage
        output bit if_valid,
        output bit [31:0] pc_if,
        output bit [31:0] orig_instr_if,
        // EX stage
        output bit ex_valid,
        output bit [31:0] pc_ex,
        output bit [31:0] orig_instr_ex,
        // WB stage
        output bit wb_valid, output bit retire,  // instruction retired this cycle
        output bit [31:0] pc_wb,
        output bit [31:0] orig_instr_wb,
        // Stall / flush / redirect
        output bit if_stall,  // EX/WB stall: if_ex_r held
        output bit ex_stall,  // WB stall: ex_wb_r held (multi-cycle/load)
        output bit if_flush,  // IF-stage flush (bp mispred / exception)
        output bit ex_flush,  // EX-stage flush (inject bubble into EX)
        // Branch prediction (EX stage, for misprediction annotation)
        output bit bp_taken_ex,        // prediction carried into EX (bp_taken field)
        output bit        redirect_ex  // actual EX redirect fired (misprediction)
    );
        // IF stage: instruction about to enter EX next cycle
        if_valid       = u_soc.u_jv32.u_core.rvc_instr_valid
                         & ~u_soc.u_jv32.u_core.if_stall
                         & ~u_soc.u_jv32.u_core.if_flush
                         & ~u_soc.u_jv32.u_core.ex_flush;
        pc_if = 32'(u_soc.u_jv32.u_core.rvc_instr_pc);
        orig_instr_if = 32'(u_soc.u_jv32.u_core.rvc_orig_instr);

        // EX stage: if_ex_r pipeline register
        ex_valid = u_soc.u_jv32.u_core.if_ex_r.valid;
        pc_ex = u_soc.u_jv32.u_core.if_ex_r.pc;
        orig_instr_ex = u_soc.u_jv32.u_core.if_ex_r.orig_instr;

        // WB stage: ex_wb_r pipeline register
        wb_valid = u_soc.u_jv32.u_core.ex_wb_r.valid;
        retire = logic'(u_soc.u_jv32.u_core.wb_retire);
        pc_wb = u_soc.u_jv32.u_core.ex_wb_r.pc;
        orig_instr_wb = u_soc.u_jv32.u_core.ex_wb_r.orig_instr;

        // Control
        if_stall = logic'(u_soc.u_jv32.u_core.if_stall);
        ex_stall = logic'(u_soc.u_jv32.u_core.ex_stall);
        if_flush = logic'(u_soc.u_jv32.u_core.if_flush);
        ex_flush = logic'(u_soc.u_jv32.u_core.ex_flush);

        // Branch/redirect info
        bp_taken_ex = logic'(u_soc.u_jv32.u_core.if_ex_r.bp_taken);
        redirect_ex = logic'(u_soc.u_jv32.u_core.ex_wb_r.redirect) & ~logic'(u_soc.u_jv32.u_core.ex_stall);
    endfunction

    logic uart_tx_o;
    logic uart_loopback_tx;

    assign uart_tx_o_monitor = uart_tx_o;

    // SIM_CLKS_PER_BIT: must be >= 4 for uart_loopback to centre-sample correctly.
    // Use 8 cycles/bit; the large TX FIFO prevents back-pressure on the CPU.
    localparam int unsigned SIM_CLKS_PER_BIT      = 8;
    localparam int unsigned SIM_BAUD_RATE         = CLK_FREQ / SIM_CLKS_PER_BIT;
    localparam logic [15:0] LOOPBACK_CLKS_PER_BIT = 16'(SIM_CLKS_PER_BIT);

    uart_loopback u_uart_loopback (
        .clk         (clk),
        .rst_n       (rst_n),
        .rx          (uart_tx_o),
        .tx          (uart_loopback_tx),
        .clks_per_bit(LOOPBACK_CLKS_PER_BIT)
    );

    // Protocol checks on both crossbar master paths and every slave port.
    assert property (@(posedge clk) disable iff(!u_soc.soc_rst_n)
        u_soc.core_mbus_awvalid && !u_soc.core_mbus_awready |=> u_soc.core_mbus_awvalid && $stable({u_soc.core_mbus_awaddr}));
    assert property (@(posedge clk) disable iff(!u_soc.soc_rst_n)
        u_soc.core_mbus_arvalid && !u_soc.core_mbus_arready |=> u_soc.core_mbus_arvalid && $stable({u_soc.core_mbus_araddr}));
    assert property (@(posedge clk) disable iff(!u_soc.soc_rst_n)
        u_soc.core_mbus_wvalid && !u_soc.core_mbus_wready |=> u_soc.core_mbus_wvalid && $stable({u_soc.core_mbus_wdata,u_soc.core_mbus_wstrb}));
    assert property (@(posedge clk) disable iff(!u_soc.soc_rst_n)
        u_soc.core_mbus_rvalid && !u_soc.core_mbus_rready |=> u_soc.core_mbus_rvalid && $stable({u_soc.core_mbus_rdata,u_soc.core_mbus_rresp}));
    assert property (@(posedge clk) disable iff(!u_soc.soc_rst_n)
        u_soc.core_mbus_bvalid && !u_soc.core_mbus_bready |=> u_soc.core_mbus_bvalid && $stable({u_soc.core_mbus_bresp}));
    assert property (@(posedge clk) disable iff(!u_soc.soc_rst_n)
        u_soc.mbus_awvalid && !u_soc.mbus_awready |=> u_soc.mbus_awvalid && $stable({u_soc.mbus_awaddr}));
    assert property (@(posedge clk) disable iff(!u_soc.soc_rst_n)
        u_soc.mbus_arvalid && !u_soc.mbus_arready |=> u_soc.mbus_arvalid && $stable({u_soc.mbus_araddr}));
    assert property (@(posedge clk) disable iff(!u_soc.soc_rst_n)
        u_soc.mbus_wvalid && !u_soc.mbus_wready |=> u_soc.mbus_wvalid && $stable({u_soc.mbus_wdata,u_soc.mbus_wstrb}));
    assert property (@(posedge clk) disable iff(!u_soc.soc_rst_n)
        u_soc.mbus_rvalid && !u_soc.mbus_rready |=> u_soc.mbus_rvalid && $stable({u_soc.mbus_rdata,u_soc.mbus_rresp}));
    assert property (@(posedge clk) disable iff(!u_soc.soc_rst_n)
        u_soc.mbus_bvalid && !u_soc.mbus_bready |=> u_soc.mbus_bvalid && $stable({u_soc.mbus_bresp}));
    for(genvar port_idx=0;port_idx<4;port_idx++) begin : bus_checks
    assert property (@(posedge clk) disable iff(!u_soc.soc_rst_n)
        u_soc.xs_awvalid[port_idx] && !u_soc.xs_awready[port_idx] |=> u_soc.xs_awvalid[port_idx] && $stable({u_soc.xs_awaddr[port_idx]}));
    assert property (@(posedge clk) disable iff(!u_soc.soc_rst_n)
        u_soc.xs_arvalid[port_idx] && !u_soc.xs_arready[port_idx] |=> u_soc.xs_arvalid[port_idx] && $stable({u_soc.xs_araddr[port_idx]}));
    assert property (@(posedge clk) disable iff(!u_soc.soc_rst_n)
        u_soc.xs_wvalid[port_idx] && !u_soc.xs_wready[port_idx] |=> u_soc.xs_wvalid[port_idx] && $stable({u_soc.xs_wdata[port_idx],u_soc.xs_wstrb[port_idx]}));
    assert property (@(posedge clk) disable iff(!u_soc.soc_rst_n)
        u_soc.xs_rvalid[port_idx] && !u_soc.xs_rready[port_idx] |=> u_soc.xs_rvalid[port_idx] && $stable({u_soc.xs_rdata[port_idx],u_soc.xs_rresp[port_idx]}));
    assert property (@(posedge clk) disable iff(!u_soc.soc_rst_n)
        u_soc.xs_bvalid[port_idx] && !u_soc.xs_bready[port_idx] |=> u_soc.xs_bvalid[port_idx] && $stable({u_soc.xs_bresp[port_idx]}));
    end
    assert property (@(posedge clk) disable iff(!u_soc.soc_rst_n)
        int'(u_soc.u_jv32.iram_addr) < IRAM_SIZE/4 && int'(u_soc.u_jv32.dram_addr) < DRAM_SIZE/4);
    assert property (@(posedge clk) disable iff(!u_soc.soc_rst_n)
        u_soc.u_jv32.u_core.ex_wb_r.is_amo && u_soc.u_jv32.u_core.dmem_req_valid &&
        u_soc.u_jv32.u_core.dmem_req_addr == u_soc.u_jv32.u_core.ex_wb_r.mem_addr
        |-> u_soc.u_jv32.u_core.dmem_req_addr[1:0]==0);

    // Optional randomized channel delays, enabled by +AXI_STALLS.
    logic mem_awvalid, mem_awready;
    axi_test_delay delay_aw (.clk(clk), .rst_n(rst_n), .s_valid(extram_awvalid_d), .s_ready(extram_awready), .m_valid(mem_awvalid), .m_ready(mem_awready));
    logic mem_wvalid, mem_wready;
    axi_test_delay delay_w (.clk(clk), .rst_n(rst_n), .s_valid(extram_wvalid_d), .s_ready(extram_wready), .m_valid(mem_wvalid), .m_ready(mem_wready));
    logic mem_arvalid, mem_arready;
    axi_test_delay delay_ar (.clk(clk), .rst_n(rst_n), .s_valid(extram_arvalid_d), .s_ready(extram_arready), .m_valid(mem_arvalid), .m_ready(mem_arready));
    logic mem_bvalid, mem_bready;
    axi_test_delay delay_b (.clk(clk), .rst_n(rst_n), .s_valid(mem_bvalid), .s_ready(mem_bready), .m_valid(extram_bvalid), .m_ready(extram_bready_d));
    logic mem_rvalid, mem_rready;
    axi_test_delay delay_r (.clk(clk), .rst_n(rst_n), .s_valid(mem_rvalid), .s_ready(mem_rready), .m_valid(extram_rvalid), .m_ready(extram_rready_d));
    assert property (@(posedge clk) disable iff(!rst_n)
        ext_axi_awvalid && !ext_axi_awready |=> ext_axi_awvalid && $stable(ext_axi_awaddr));
    assert property (@(posedge clk) disable iff(!rst_n)
        ext_axi_arvalid && !ext_axi_arready |=> ext_axi_arvalid && $stable(ext_axi_araddr));
    assert property (@(posedge clk) disable iff(!rst_n)
        ext_axi_wvalid && !ext_axi_wready |=> ext_axi_wvalid && $stable({ext_axi_wdata,ext_axi_wstrb}));
    assert property (@(posedge clk) disable iff(!rst_n)
        ext_axi_bvalid && !ext_axi_bready |=> ext_axi_bvalid && $stable(ext_axi_bresp));
    assert property (@(posedge clk) disable iff(!rst_n)
        ext_axi_rvalid && !ext_axi_rready |=> ext_axi_rvalid && $stable({ext_axi_rdata,ext_axi_rresp}));

    // External RAM: 2 MB AXI4 memory model at 0xA000_0000 (simulation only)
    axi_memory #(
        .ADDR_WIDTH       (32),
        .DATA_WIDTH       (32),
        .MEM_SIZE         (EXTRAM_SIZE),
        .BASE_ADDR        (EXTRAM_BASE),
        .MEM_READ_LATENCY (1),
        .MEM_WRITE_LATENCY(1),
        .MEM_DUAL_PORT    (1)
    ) u_extram (
        .clk        (clk),
        .rst_n      (rst_n),
        .axi_awaddr (tb_alias_addr_r),
        .axi_awlen  (8'h0),
        .axi_awsize (3'h2),
        .axi_awburst(2'h1),
        .axi_awvalid(mem_awvalid),
        .axi_awready(mem_awready),
        .axi_wdata  (ext_axi_wdata),
        .axi_wstrb  (ext_axi_wstrb),
        .axi_wlast  (1'b1),
        .axi_wvalid (mem_wvalid),
        .axi_wready (mem_wready),
        .axi_bresp  (extram_bresp),
        .axi_bvalid (mem_bvalid),
        .axi_bready (mem_bready),
        .axi_araddr (tb_alias_addr_r),
        .axi_arlen  (8'h0),
        .axi_arsize (3'h2),
        .axi_arburst(2'h1),
        .axi_arvalid(mem_arvalid),
        .axi_arready(mem_arready),
        .axi_rdata  (extram_rdata),
        .axi_rresp  (extram_rresp),
        .axi_rlast  (extram_rlast),
        .axi_rvalid (mem_rvalid),
        .axi_rready (mem_rready)
    );

    jv32_soc #(
        .CLK_FREQ       (CLK_FREQ),
        .BAUD_RATE      (SIM_BAUD_RATE),  // 8 cycles/bit — fast yet loopback-safe
        .UART_FIFO_DEPTH(4096),           // deep FIFO; CPU never stalls on TX
        .USE_CJTAG      (USE_CJTAG),
        .IRAM_SIZE      (IRAM_SIZE),
        .DRAM_SIZE      (DRAM_SIZE),
        .RV32E_EN       (RV32E_EN),
        .RV32M_EN       (RV32M_EN),
        .JTAG_EN        (JTAG_EN),
        .AMO_EN         (AMO_EN),
        .FAST_MUL       (FAST_MUL),
        .MUL_MC         (MUL_MC),
        .FAST_DIV       (FAST_DIV),
        .FAST_SHIFT     (FAST_SHIFT),
        .SCOREBOARD_EN  (SCOREBOARD_EN),
        .BP_EN          (BP_EN),
        .RAS_EN         (RAS_EN),
        .IBUF_EN        (IBUF_EN),
        .RV32B_EN       (RV32B_EN),
        .ZCMP_EN        (ZCMP_EN),
        .IRAM_BASE      (IRAM_BASE),
        .DRAM_BASE      (DRAM_BASE),
        .BOOT_ADDR      (BOOT_ADDR)
    ) u_soc (
        .clk             (clk),
        .rst_n           (rst_n),
        .uart_rx_i       (uart_rx_i),
        .uart_tx_o       (uart_tx_o),
        .jtag_ntrst_i    (jtag_ntrst_i),
        .jtag_pin0_tck_i (jtag_pin0_tck_i),
        .jtag_pin1_tms_i (jtag_pin1_tms_i),
        .jtag_pin1_tms_o (jtag_pin1_tms_o),
        .jtag_pin1_tms_oe(jtag_pin1_tms_oe),
        .jtag_pin2_tdi_i (jtag_pin2_tdi_i),
        .jtag_pin3_tdo_o (jtag_pin3_tdo_o),
        .jtag_pin3_tdo_oe(jtag_pin3_tdo_oe),
        .ext_irq_i       (16'h0),

        // TCM slaves driven by testbench alias bridge
        .s_iram_tcm_araddr   (s_iram_tcm_araddr),
        .s_iram_tcm_arvalid  (s_iram_tcm_arvalid),
        .s_iram_tcm_arready  (s_iram_tcm_arready),
        .s_iram_tcm_rdata    (s_iram_tcm_rdata),
        .s_iram_tcm_rresp    (s_iram_tcm_rresp),
        .s_iram_tcm_rvalid   (s_iram_tcm_rvalid),
        .s_iram_tcm_rready   (s_iram_tcm_rready),
        .s_iram_tcm_awaddr   (s_iram_tcm_awaddr),
        .s_iram_tcm_awvalid  (s_iram_tcm_awvalid),
        .s_iram_tcm_awready  (s_iram_tcm_awready),
        .s_iram_tcm_wdata    (s_iram_tcm_wdata),
        .s_iram_tcm_wstrb    (s_iram_tcm_wstrb),
        .s_iram_tcm_wvalid   (s_iram_tcm_wvalid),
        .s_iram_tcm_wready   (s_iram_tcm_wready),
        .s_iram_tcm_bresp    (s_iram_tcm_bresp),
        .s_iram_tcm_bvalid   (s_iram_tcm_bvalid),
        .s_iram_tcm_bready   (s_iram_tcm_bready),
        .s_dram_tcm_araddr   (s_dram_tcm_araddr),
        .s_dram_tcm_arvalid  (s_dram_tcm_arvalid),
        .s_dram_tcm_arready  (s_dram_tcm_arready),
        .s_dram_tcm_rdata    (s_dram_tcm_rdata),
        .s_dram_tcm_rresp    (s_dram_tcm_rresp),
        .s_dram_tcm_rvalid   (s_dram_tcm_rvalid),
        .s_dram_tcm_rready   (s_dram_tcm_rready),
        .s_dram_tcm_awaddr   (s_dram_tcm_awaddr),
        .s_dram_tcm_awvalid  (s_dram_tcm_awvalid),
        .s_dram_tcm_awready  (s_dram_tcm_awready),
        .s_dram_tcm_wdata    (s_dram_tcm_wdata),
        .s_dram_tcm_wstrb    (s_dram_tcm_wstrb),
        .s_dram_tcm_wvalid   (s_dram_tcm_wvalid),
        .s_dram_tcm_wready   (s_dram_tcm_wready),
        .s_dram_tcm_bresp    (s_dram_tcm_bresp),
        .s_dram_tcm_bvalid   (s_dram_tcm_bvalid),
        .s_dram_tcm_bready   (s_dram_tcm_bready),
        .ext_axi_araddr      (ext_axi_araddr),
        .ext_axi_arvalid     (ext_axi_arvalid),
        .ext_axi_rready      (ext_axi_rready),
        .ext_axi_awaddr      (ext_axi_awaddr),
        .ext_axi_awvalid     (ext_axi_awvalid),
        .ext_axi_wdata       (ext_axi_wdata),
        .ext_axi_wstrb       (ext_axi_wstrb),
        .ext_axi_wvalid      (ext_axi_wvalid),
        .ext_axi_bready      (ext_axi_bready),
        .ext_axi_arready     (ext_axi_arready),
        .ext_axi_rdata       (ext_axi_rdata),
        .ext_axi_rresp       (ext_axi_rresp),
        .ext_axi_rvalid      (ext_axi_rvalid),
        .ext_axi_awready     (ext_axi_awready),
        .ext_axi_wready      (ext_axi_wready),
        .ext_axi_bresp       (ext_axi_bresp),
        .ext_axi_bvalid      (ext_axi_bvalid),
        .trace_en            (trace_en),
        .trace_valid         (trace_valid),
        .trace_reg_we        (trace_reg_we),
        .trace_pc            (trace_pc),
        .trace_rd            (trace_rd),
        .trace_rd_data       (trace_rd_data),
        .trace_instr         (trace_instr),
        .trace_mem_we        (trace_mem_we),
        .trace_mem_re        (trace_mem_re),
        .trace_mem_addr      (trace_mem_addr),
        .trace_mem_data      (trace_mem_data),
        .trace_irq_taken     (trace_irq_taken),
        .trace_irq_cause     (trace_irq_cause),
        .trace_irq_epc       (trace_irq_epc),
        .trace_irq_store_we  (trace_irq_store_we),
        .trace_irq_store_addr(trace_irq_store_addr),
        .trace_irq_store_data(trace_irq_store_data),
        .perf_bp_branch      (perf_bp_branch),
        .perf_bp_taken       (perf_bp_taken),
        .perf_bp_mispred     (perf_bp_mispred),
        .perf_bp_jal         (perf_bp_jal),
        .perf_bp_jal_miss    (perf_bp_jal_miss),
        .perf_bp_jalr        (perf_bp_jalr),
        .heartbeat_o         (heartbeat_o)
    );

    // Lint sink: output signals received but not consumed in simulation
    logic _unused_tb;
    assign _unused_tb = &{1'b0, uart_loopback_tx, extram_rlast};

endmodule
/* verilator coverage_on */

// A delay gate never withdraws VALID after exposing it to the receiver.
module axi_test_delay(input logic clk, rst_n, s_valid, m_ready,
                      output logic s_ready, m_valid);
    bit enabled;
    logic allow, held;
    initial enabled=$test$plusargs("AXI_STALLS");
    always_ff @(posedge clk or negedge rst_n) begin
        if(!rst_n) begin allow<=0; held<=0; end
        else begin
            allow<=($urandom_range(0,3)==0);
            held<=m_valid && !m_ready;
        end
    end
    assign m_valid=s_valid && (!enabled || allow || held);
    assign s_ready=m_ready && (!enabled || allow || held);
endmodule
