kuopinghsu/jv32.dev/rtl/jv32/core/jv32_rvc.sv

// ============================================================================
// File        : jv32_rvc.sv
// Project     : JV32 RISC-V Processor
// Description : RVC (Zca + Zcb + Zcmp) Compressed-Instruction Expander
//
// Handles: (1) two compressed per word, (2) split 32-bit across words,
// (3) halfword-aligned fetch targets.
//
// hold[1:0]==11 -> case_d (split 32-bit lower half buffered)
// hold[1:0]!=11 -> case_c (compressed instruction buffered)
// init_offset   -> skip lower halfword on first post-flush fetch
//
// SPDX-License-Identifier: MIT
// Copyright (c) 2026 Kuoping Hsu
//
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
module jv32_rvc #(
    parameter bit RVM23_EN = 1'b1,
    parameter bit ZCMP_EN  = 1'b1
) (
    input  logic        clk,
    input  logic        rst_n,
    input  logic        imem_resp_valid,
    input  logic [31:0] imem_resp_data,
    input  logic [31:0] imem_resp_pc,
    input  logic        stall,
    input  logic        flush,
    input  logic [31:0] flush_pc,
    output logic        instr_valid,
    output logic [31:0] instr_data,
    output logic [31:0] orig_instr,
    output logic [31:0] instr_pc,
    output logic        is_compressed,
    output logic        mem_ready
);

`ifndef DBG_GRP_FETCH
    `define DBG_GRP_FETCH 0
`endif

`ifndef DEBUG2
    `define DEBUG2(grp, msg)
`endif

    import jv32_pkg::*;

    logic        hold_valid;
    logic [15:0] hold;
    logic [31:0] hold_pc;
    logic        hold_from_split;  // hold was set from split32 path; don't re-advance pc_if on output
    logic        init_offset;
    /* verilator coverage_off */  // stale_rsp is architecturally always 0 (IFETCH_PREADVANCE)
    logic        stale_rsp;  // 1 cycle after mr=1: SRAM echoes the old word, must discard
    /* verilator coverage_on */

    // -------------------------------------------------------------------------
    // Zcmp microsequencer state
    //   zcmp_seq     : 1 while a multi-op Zcmp instruction is in progress
    //   zcmp_step    : current micro-op index (0 = first op not yet emitted)
    //   zcmp_total   : total number of micro-ops for this instruction
    //   zcmp_op      : 2'b00=push, 2'b01=pop, 2'b10=popret, 2'b11=popretz,
    //                  3'b100=mvsa01, 3'b101=mva01s  (uses bit 2 for mv group)
    //   zcmp_pc      : PC of the Zcmp instruction (all micro-ops share it)
    //   zcmp_orig    : original 16-bit compressed word (for orig_instr trace)
    //   zcmp_rcount  : number of registers in rlist (1-12)
    //   zcmp_sadj    : stack adjustment in bytes
    //   zcmp_sreg1   : s-reg index for mvsa01/mva01s operand 1  (3-bit, maps to GPR)
    //   zcmp_sreg2   : s-reg index for mvsa01/mva01s operand 2  (3-bit, maps to GPR)
    // -------------------------------------------------------------------------
    logic        zcmp_seq;
    logic [ 3:0] zcmp_step;     // current micro-op (0-based)
    logic [ 3:0] zcmp_total;    // total micro-ops
    logic [ 2:0] zcmp_op;       // operation code
    logic [31:0] zcmp_pc;
    logic [15:0] zcmp_orig;
    logic [ 3:0] zcmp_rcount;   // registers in list
    logic [ 7:0] zcmp_sadj;     // stack adjustment (positive magnitude)
    logic [ 2:0] zcmp_sreg1;    // 3-bit s-reg encoding for mvsa01/mva01s
    logic [ 2:0] zcmp_sreg2;    // 3-bit s-reg encoding
    logic        zcmp_last_mr;  // mem_ready to drive on the last Zcmp micro-op

    // Zcmp detection wires (combinational): used by both comb and FF blocks
    logic        zcmp_det_hold;     // Zcmp detected from hold path
    logic        zcmp_det_eff_lo;   // Zcmp from eff_data[15:0] path
    logic        zcmp_det_eff_hi;   // Zcmp from eff_data[31:16] path (init_offset)
    logic [15:0] zcmp_det_ci;       // the triggering CI word
    logic [ 2:0] zcmp_det_op;       // decoded op code
    logic [ 3:0] zcmp_det_rcount;   // decoded register count
    logic [ 7:0] zcmp_det_sadj;     // decoded stack adjustment
    logic [ 2:0] zcmp_det_sreg1;    // sreg1 (mv variants)
    logic [ 2:0] zcmp_det_sreg2;    // sreg2 (mv variants)
    logic [31:0] zcmp_det_pc;       // PC of the Zcmp instruction
    logic        zcmp_det_last_mr;  // mem_ready for the last micro-op
    logic [ 3:0] zcmp_det_total;    // total micro-ops for this instruction

    // Map 3-bit s-register encoding to 5-bit GPR number
    // 0->s0(x8), 1->s1(x9), 2->s2(x18), 3->s3(x19), 4->s4(x20), 5->s5(x21), 6->s6(x22), 7->s7(x23)
    function automatic logic [4:0] zcmp_sreg_to_gpr(input logic [2:0] s);
        case (s)
            3'd0:    zcmp_sreg_to_gpr = 5'd8;   // s0
            3'd1:    zcmp_sreg_to_gpr = 5'd9;   // s1
            3'd2:    zcmp_sreg_to_gpr = 5'd18;  // s2
            3'd3:    zcmp_sreg_to_gpr = 5'd19;  // s3
            3'd4:    zcmp_sreg_to_gpr = 5'd20;  // s4
            3'd5:    zcmp_sreg_to_gpr = 5'd21;  // s5
            3'd6:    zcmp_sreg_to_gpr = 5'd22;  // s6
            default: zcmp_sreg_to_gpr = 5'd23;  // 3'd7: s7
        endcase
    endfunction

    // Map save-list index (0=ra, 1=s0, 2=s1, 3+=s{i-1}) to GPR number
    function automatic logic [4:0] zcmp_save_gpr(input logic [3:0] idx);
        case (idx)
            4'd0:    zcmp_save_gpr = 5'd1;   // ra
            4'd1:    zcmp_save_gpr = 5'd8;   // s0
            4'd2:    zcmp_save_gpr = 5'd9;   // s1
            4'd3:    zcmp_save_gpr = 5'd18;  // s2
            4'd4:    zcmp_save_gpr = 5'd19;  // s3
            4'd5:    zcmp_save_gpr = 5'd20;  // s4
            4'd6:    zcmp_save_gpr = 5'd21;  // s5
            4'd7:    zcmp_save_gpr = 5'd22;  // s6
            4'd8:    zcmp_save_gpr = 5'd23;  // s7
            4'd9:    zcmp_save_gpr = 5'd24;  // s8
            4'd10:   zcmp_save_gpr = 5'd25;  // s9
            4'd11:   zcmp_save_gpr = 5'd26;  // s10
            4'd12:   zcmp_save_gpr = 5'd27;  // s11
            default: zcmp_save_gpr = 5'd0;
        endcase
    endfunction

    // Compute stack adjustment from rlist value (4-bit field from CI[7:4])
    // rlist 4-7 -> min=16, 8-11 -> min=32, 12-14 -> min=48, 15 -> min=64
    function automatic logic [7:0] zcmp_min_stack(input logic [3:0] rlist);
        case (rlist[3:2])
            2'b01:   zcmp_min_stack = 8'd16;                             // rlist 4-7
            2'b10:   zcmp_min_stack = 8'd32;                             // rlist 8-11
            2'b11:   zcmp_min_stack = (rlist == 4'd15) ? 8'd64 : 8'd48;  // 12-14 -> 48, 15 -> 64
            default: zcmp_min_stack = 8'd0;                              // rlist 0-3: reserved/invalid
        endcase
    endfunction

    // Compute number of registers from rlist (4-bit)
    // rlist 4 -> 1 reg, rlist r -> r-3 regs; max rlist=15 -> 12 regs
    function automatic logic [3:0] zcmp_rcount_f(input logic [3:0] rlist);
        zcmp_rcount_f = (rlist < 4'd4) ? 4'd0 : (rlist - 4'd3);
    endfunction

    function automatic logic [31:0] c_sext6(input logic [5:0] v);
        c_sext6 = {{26{v[5]}}, v};
    endfunction

    // c_imm6: sign-extend 6-bit value to 12-bit I-type immediate field
    function automatic logic [11:0] c_imm6(input logic [5:0] v);
        c_imm6 = {{6{v[5]}}, v};
    endfunction

    function automatic logic [31:0] c_sext9(input logic [8:0] v);
        c_sext9 = {{23{v[8]}}, v};
    endfunction

    function automatic logic [31:0] c_sext10(input logic [9:0] v);
        c_sext10 = {{22{v[9]}}, v};
    endfunction

    function automatic logic [31:0] c_sext12(input logic [11:0] v);
        c_sext12 = {{20{v[11]}}, v};
    endfunction

    // c_j_off: J-type offset [20:1] from C.JAL/C.J encoding (inlined sign-extension, no temp needed)
    function automatic logic [20:1] c_j_off(input logic [12:2] ci);
        c_j_off = {{9{ci[12]}}, ci[12], ci[8], ci[10:9], ci[6], ci[7], ci[2], ci[11], ci[5:3]};
    endfunction

    // c_b_off: B-type offset [12:1] from C.BEQZ/C.BNEZ encoding (inlined sign-extension, no temp needed)
    function automatic logic [12:1] c_b_off(input logic [2:0] ci_hi, input logic [4:0] ci_lo);
        c_b_off = {{4{ci_hi[2]}}, ci_hi[2], ci_lo[4:3], ci_lo[0], ci_hi[1:0], ci_lo[2:1]};
    endfunction

    // enc_jal: encode J-type instruction; im[20:1] are the offset bits (bit 0 always 0)
    function automatic logic [31:0] enc_jal(input logic [4:0] rd, input logic [20:1] im);
        enc_jal = {im[20], im[10:1], im[11], im[19:12], rd, 7'h6F};
    endfunction

    // enc_br: encode B-type instruction; im[12:1] are the offset bits (bit 0 always 0)
    function automatic logic [31:0] enc_br(input logic [2:0] f3, input logic [4:0] rs1, input logic [4:0] rs2,
                                           input logic [12:1] im);
        enc_br = {im[12], im[10:5], rs2, rs1, f3, im[4:1], im[11], 7'h63};
    endfunction

    function automatic logic [31:0] expand_c(input logic [15:0] ci);
        logic [1:0] quad, funct2;
        logic [2:0] funct3;
        logic [4:0] rd_rs1, rs2, rd_p, rs1_p, rs2_p;
        logic [11:0] nzuimm12, uimm12;
        logic [31:0] nzimm;
        logic [11:0] _sext;  // lower 12 bits of sign-extended value (I-type immediate field)
        logic        f1;
        logic [ 1:0] f2_low;

        // Default all locals to silence Yosys latch inference on partial paths
        funct2   = '0;
        rd_rs1   = '0;
        rs2      = '0;
        nzuimm12 = '0;
        uimm12   = '0;
        nzimm    = '0;
        _sext    = '0;
        f1       = '0;
        f2_low   = '0;
        expand_c = 32'h0;
        quad     = ci[1:0];
        funct3   = ci[15:13];
        rd_p     = {2'b01, ci[4:2]};
        rs1_p    = {2'b01, ci[9:7]};
        rs2_p    = {2'b01, ci[4:2]};
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
