kuopinghsu/jv32.dev/(commit log)

2026-04-07 Add Hello World and Trap Test for JV32 RISC-V Processor
    - Implemented a simple Hello World test in `hello.c` that writes to UART and demonstrates basic functionality.
    - Created a comprehensive trap handling test in `trap_test.c` covering various exceptions including ecall, ebreak, misaligned loads, illegal instructions, and timer interrupts.
    - Developed an ELF file loader in `elfloader.cpp` and its header `elfloader.h` to facilitate loading RISC-V ELF binaries into simulated memory.
    - Added a Verilator testbench driver in `tb_jv32_soc.cpp` to manage simulation, including ELF loading and cycle counting.
    - Created a SystemVerilog wrapper `tb_jv32_soc.sv` for the JV32 SoC, integrating DPI-C fun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
    [hello.c, jv32sim.cpp, printf.c, putc.c, riscv-dis.cpp, riscv-dis.h, trace_compare.py, uart_loopback.sv]
2026-04-07 Refactor CLIC interrupt handling and enhance trace functionality
    - Updated jv32_core to replace clic_vector_pc input with clic_id for IRQ handling.
    - Introduced tail-chain mechanism in jv32_core and jv32_csr to optimize interrupt handling.
    - Enhanced trace outputs in jv32_core to include trace_reg_we signal for register write events.
    - Modified jv32_top and jv32_soc to accommodate changes in CLIC handling and trace outputs.
    - Improved memory response handling in jv32_rvc to manage stale responses effectively.
    - Updated Makefile to streamline test builds and added support for hello world and trap test examples.
    - Adjusted startup.S to clarify the default handle_trap implementation.
    - Refined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
    [axi_clic.sv, axi_uart.sv, elfloader.cpp, jv32_core.sv, jv32_csr.sv, jv32_pkg.sv, jv32_rvc.sv, jv32_soc.sv]
2026-04-08 feat(disassembler): add support for floating-point instructions and improve CSR handling
    - Implement decoding for FMADD, FMSUB, FNMSUB, and FNMADD instructions in the RISC-V disassembler.
    - Enhance OP-FP instruction decoding to handle various floating-point operations.
    - Introduce rounding mode suffixes for floating-point instructions.
    - Update CSR handling to include floating-point CSRs and jump-vector-table base.
    - Fix instruction decoding for ORC.B by correcting funct7 value.
    - Improve trap test handling to determine instruction size for ebreak and illegal instructions.
    - Modify Makefile to streamline test building and improve documentation.
    - Update startup code to handle exit requests m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
    [axi_clic.sv, axi_xbar.sv, jv32_core.sv, jv32_csr.sv, jv32_rvc.sv, jv32_soc.sv, jv32_top.sv, jv32sim.cpp]
2026-04-09 Refactor putc, putchar, and fputc implementations to use jv_putc
    - Updated `putc`, `putchar`, and `fputc` functions in `putc.c` to directly call `jv_putc` for character output, removing reliance on the external `_write` function.
    - Streamlined code by eliminating unnecessary variable declarations and checks.
    Add 64-bit instret counter read function in csr.h
    - Introduced `read_csr_minstret64` to safely read the 64-bit instruction retired counter, ensuring correct handling of carry-over.
    - Added aliases for cycle and instret counters to maintain consistency with unprivileged CSR names.
    Modify ELF loader to use stderr for logging
    - Changed `printf` statements to `fprintf(stderr, ...)` in `e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
    [elfloader.cpp, jv32_core.sv, jv32_csr.sv, jv32_pkg.sv, jv32_soc.sv, jv32_top.sv]
2026-04-10 Add Nangate 45nm Open Cell Library support for OpenLane 2
    - Introduced config.tcl for NangateOpenCellLibrary to set up standard-cell parameters and required environment variables.
    - Created a PDK-level config.tcl for FreePDK45 to define default library and top-level parameters.
    - Implemented report_timing.tcl for post-route static timing analysis, generating comprehensive timing, power, and area reports.
    - Developed run_pnr.tcl for standalone OpenROAD P&R flow, including steps for reading LEFs, liberty files, netlist, timing constraints, floorplanning, placement, clock tree synthesis, routing, and final STA.
2026-04-11 Add JV32 SoC and SRAM modules; configure FreePDK45 support
    - Introduced `jv32_soc.sv`, the top-level module for the JV32 RISC-V processor, integrating core components and peripherals with a defined memory map.
    - Added `sram_1rw.sv`, a synthesis wrapper for single-port SRAM, supporting IRAM and DRAM configurations.
    - Created KLayout and Magic configuration files for FreePDK45, including layer mappings and setup scripts.
    - Implemented Netgen LVS setup for FreePDK45.
    - Updated NangateOpenCellLibrary configuration to enhance compatibility with OpenLane2, including adjustments for power/ground nets, routing layers, and timing corners.
    - Added scripts for running OpenLane2 within a Nix shell for d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
    [macro_placement.cfg]
2026-04-11 Refactor JV32 SoC RTL and add JTAG/cJTAG support
    - Removed synthesis conditionals for package imports in CSR, decoder, and RVC modules.
    - Added JTAG/cJTAG debug interface to the SoC, including necessary input/output pins.
    - Enhanced the register file to support debug sideband access while the hart is halted.
    - Updated SRAM memory module to support byte write enables for more flexible memory operations.
    - Modified the testbench to initialize JTAG signals and ensure proper reset handling.
    - Added a README.md file with project overview, repository layout, quick start instructions, and useful targets for building and running simulations.
    - Adjusted CoreMark makefile to suppress unused parameter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
    [axi_clic.sv, axi_ram_ctrl.sv, axi_uart.sv, cjtag_bridge.sv, jtag_top.sv, jv32_alu.sv, jv32_core.sv, jv32_csr.sv]
2026-04-12 Update SRAM configuration for evaluation: change sizes to 16 KB and adjust related files
    [macro_placement.cfg]
2026-04-12 Add OpenOCD configuration and test scripts for JV32 RISC-V processor
    - Created jv32.cfg and jv32_cjtag.cfg for JTAG and cJTAG configurations.
    - Added jv32_gdb.cfg for GDB integration.
    - Implemented various test scripts including:
    - test_breakpoint.tcl for software breakpoint testing.
    - test_cjtag.tcl for cJTAG transport validation.
    - test_halt_resume.tcl for halt and resume functionality.
    - test_memory.tcl for memory access verification.
    - test_programbuf.tcl for program buffer capability checks.
    - test_registers.tcl for register access testing.
    - test_reset.tcl for reset functionality validation.
    - test_watchpoint.tcl for watchpoint testing.
    - Introduced tb_jv32_vpi.cpp as a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
    [jv32.cfg, jv32_cjtag.cfg, jv32_gdb.cfg]
2026-04-12 Enhance DPC Handling and Debug State Management
    - Introduced a new logic register `dpc_reg` to persist the saved DPC across CMD_EXEC operations.
    - Updated the logic to capture the current program counter (PC) into `dpc_reg` when entering debug mode, unless in CMD_EXEC state.
    - Modified the read operation for CSR DPC to return the value from `dpc_reg` instead of the current PC.
    - Ensured that writes to CSR DPC update `dpc_reg` to maintain consistency across debug operations.
    - Adjusted the command completion state to restore the PC from `dpc_reg`, effectively undoing CMD_EXEC side effects.
    - Improved handling of debug state transitions to prevent stale write-back (WB) states during debug entr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
    [jv32_core.sv, jv32_dtm.sv]
2026-04-13 Add trigger interface enhancements and fault handling in jv32 core
    - Introduced per-trigger hit bits in jtag_tap, jtag_top, and jv32_dtm modules to track which triggers fired during execution.
    - Updated jv32_core to handle trigger matches and maintain a latch for trigger hits, ensuring accurate reporting during debug sessions.
    - Enhanced exception handling in jv_irq.c to differentiate between illegal instruction faults and data access faults, allowing for proper fault recovery.
    - Added support for data memory fault detection in the jv32 core, raising appropriate exceptions for load/store access faults.
    - Improved the handling of debug resumes and flushes to ensure the correct state is mainta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
    [jv32_gdb.cfg]
2026-04-16 Add error handling for memory access in DTM and JTAG modules; enhance test coverage for JTAG/cJTAG interfaces
    [cjtag_bridge.sv, jtag_tap.sv, jtag_top.sv, jv32_dtm.sv, jv32_soc.sv]
2026-04-16 Increase hold-buffer budget cap for Stage 36 to prevent RSZ-0060 termination in macro-heavy designs
    [config.yaml]
2026-04-18 Update JV32 SoC configuration and simulation parameters
    - Changed FAST_DIV parameter from combinatorial (1) to serial (0) in jv32_pkg.sv, jv32_top.sv, and jv32_soc.sv for improved stability.
    - Adjusted clock frequency from 100 MHz to 80 MHz in various files including config.yaml, jv32_soc_pnr.sdc, and tb_jv32_soc.sv to align with new design requirements.
    - Enhanced signal handling in jv32sim.cpp to allow for graceful shutdown and register dumping on SIGINT.
    - Introduced a new function to dump registers during simulation for better debugging.
    - Updated Makefile configurations to support new parameters and ensure compatibility with the latest design changes.
    - Added a Makefile.cfg for centrali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
    [Makefile.cfg, macro_placement.cfg]
2026-04-18 Refactor and align code formatting across multiple files
    - Updated the formatting of input and output ports in `sram_1rw.sv` for consistency.
    - Improved readability by aligning comments and parameters in `align_localparams.py` and `align_trailing_comments.py`.
    - Enhanced the testbench `tb_jv32_soc.sv` by aligning parameter declarations and input/output signals.
    - Refactored the `uart_loopback.sv` to improve variable alignment and readability.
    - Modified the `Makefile` in the verification directory to streamline the generation of configuration files and added support for extension listing.
    - Updated `sail_spike_wrapper.sh.in` to infer ISA width from ELF headers, ensuring compatibility with RV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
    [Makefile.cfg]
2026-04-18 Fix irq_cancel assignment logic to include ex_wb_r.valid and dbg_halted_r checks
    [jv32_core.sv]
2026-04-19 Add support for TCM alias mapping in JV32 RISC-V Processor
    - Introduced IRAM and DRAM alias base addresses in jv32sim.cpp.
    - Updated memory read/write functions to handle alias addresses for both IRAM and DRAM.
    - Enhanced the testbench (tb_jv32_soc.sv) to include TCM alias interfaces and logic for alias detection.
    - Modified the verification Makefile to improve error handling during the arch-test run.
    - Created a new OpenOCD script (test_debug_ext_alias.tcl) to validate out-of-TCM alias routing.
    - Implemented a new C test (tcm_alias.c) to verify TCM alias mapping functionality, including basic coherence and mixed-width access tests.
    [axi_clic.sv, axi_xbar.sv, jv32_core.sv, jv32_soc.sv, jv32_top.sv, jv32sim.cpp, tb_jv32_soc.sv, tcm_alias.c]
2026-04-19 Add script to snap OpenRAM LEF RECT coordinates to manufacturing grid
    [fix_openram_lef_grid.py]
2026-04-19 Update Makefile to snap OpenRAM LEF pin geometry to manufacturing grid; modify config.yaml for antenna diode insertion settings
    [config.yaml]
2026-04-19 Add resume functionality to OpenLane synthesis flow and enhance config settings
2026-04-20 Enhance JV32 Core and Simulation with Async Interrupt Support
    - Updated jv32_core.sv to include new outputs for async interrupt tracing: trace_irq_taken and trace_irq_cause.
    - Modified jv32_top.sv and jv32_soc.sv to propagate the new async interrupt signals through the design hierarchy.
    - Enhanced FreeRTOS sample to adjust task priorities for better scheduling.
    - Improved jv32sim.cpp to support sync-trace events, allowing for precise alignment of software and RTL simulation states.
    - Updated testbench files to accommodate new trace signals for async interrupts and mtime.
    - Adjusted Makefile for verification to ensure sanitized test directories are created and used during the build process.
    -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
2026-04-20 feat: Add report generation script for OpenLane2 runs
    - Introduced `gen_report.py` to generate a comprehensive report from OpenLane2 run directories, including sections for configuration, floorplan, cell count, timing, power, routing, manufacturability, and output files.
    - Implemented helper functions for reading files, extracting values, and generating report sections based on STA, power, area, and wirelength data.
    fix: Enhance openlane_resume_step.py for Magic and ODB checks
    - Added bypass logic for `Magic.SpiceExtraction` and `Odb.CheckDesignAntennaProperties` steps to handle cases where required inputs are missing.
    feat: Update testbench for new MUL_MC parameter
    - Added `MUL_MC` para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
    [Makefile.cfg]
2026-04-20 feat: Add trace enable functionality to core, top, and SoC modules for power management
2026-04-20 feat: Implement reset synchronizer in jv32_soc module to prevent metastability
    [jv32_soc.sv]
2026-04-21 feat: add gate count analysis and reporting
    - Updated Makefile to include a new target `gate-count` for hierarchical gate count analysis using NAND2 equivalents.
    - Enhanced `gen_report.py` to support reporting NAND2-equivalent counts by reading the Nangate liberty file.
    - Introduced `gen_gate_count.py` script to parse Yosys stat.json and generate detailed gate count reports.
    - Added `config_gate_count.yaml` for OpenLane2 synthesis configuration to preserve module hierarchy.
    - Created `jv32_macros.svh` for debug display macros and group definitions.
    - Modified testbench files to enable trace outputs for better debugging and analysis.
    - Updated submodule reference for riscv-arch-test.
2026-04-22 Add nested interrupt test and hierarchical synthesis script
    - Implemented a nested interrupt test in `nested_irq.c` for the JV32 RISC-V processor, utilizing two AXI timer channels via PLIC. The test verifies the correct handling of nested interrupts with specific timing constraints and pass criteria.
    - Introduced a new script `hier_synth.sh` for standalone Yosys hierarchical synthesis, preserving module boundaries to generate detailed gate counts in `stat.json`. The script is designed to be executed within the OpenLane nix-shell environment.
2026-04-22 Refactor trap handlers and enhance gate count reporting
    - Updated trap handlers in `trap_test.c` to use a unified `jv_trap_frame_t` structure for better readability and maintainability.
    - Modified the `Makefile` to streamline gate count analysis, including improved environment variable handling and output reporting.
    - Updated `REPORT.md` with the latest synthesis results, including changes in configuration parameters and area utilization metrics.
    - Enhanced the testbench in `tb_jv32_soc.cpp` and `tb_jv32_soc.sv` to emit additional trace information for IRQ handling, including store hints for better synchronization with the RTL simulation.
2026-04-23 fix: update constraints and improve call-stack frame pointer validation
    [constraints.xdc]
2026-04-23 feat: add OpenOCD configuration files for cJTAG and JTAG interfaces, and script for log extraction
    [jv32_fpga_cjtag.cfg, jv32_fpga_jtag.cfg]
2026-04-23 Enhance timing report and design checks in OpenLane2 flow
    - Updated REPORT.md with new clock and area metrics, including detailed ALU area breakdown and improved cell count reporting.
    - Adjusted hold slack margins in config.yaml to address observed hold-time violations.
    - Modified gen_report.py to include design checks for slew, capacitance, and fanout violations, and improved timing convergence reporting.
    - Added clock tree synthesis statistics section to the report.
    - Enhanced wirelength reporting to include total routed nets and via counts from detailed routing metrics.
    - Implemented hold-time repair in report_timing.tcl to address specific timing violations before generating reports.
    Co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
2026-04-23 Add syscall stubs for Newlib and implement C++ test program
    - Introduced `syscall.c` with custom implementations for Newlib syscalls
    to support bare-metal testing on the JV32 RISC-V Processor.
    - Implemented `_write`, `_sbrk`, and other necessary syscall stubs to
    facilitate standard I/O operations without triggering ecall exceptions.
    - Added a C++ test program (`cpp_test.cpp`) demonstrating global and
    static constructors, C++ class features, and integration with C library
    functions.
    - Created a README for the C++ test outlining features, expected output,
    and known issues.
    - Added a test program (`fence.c`) to validate the functionality of the
    FENCE instruction, ensuring correct ex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
    [syscall.c]
2026-04-23 Add support for RV32E and RV32M configurations
    - Updated jv32_csr module to compute MISA value based on RV32E_EN, RV32M_EN, and AMO_EN parameters.
    - Enhanced jv32_decoder to handle illegal instructions for RV32E and RV32M configurations.
    - Modified jv32_regfile to support 16 registers in RV32E mode and ensure illegal accesses to x16-x31 are handled.
    - Updated jv32_top and jv32_soc to pass RV32E_EN and RV32M_EN parameters through the hierarchy.
    - Adjusted FreeRTOS build process to skip builds for RV32E targets due to register limitations.
    - Enhanced startup.S to handle different trap frame sizes for RV32E and RV32I.
    - Updated jv_irq.h to reflect the new trap frame structure for RV32E.
    - Modif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
    [Makefile.cfg]
2026-04-23 feat: add clock gating support with ICG cells in synthesis flow
2026-04-23 feat: add DFT support with clock gating and scan flip-flops
    [gen_gate_count.py]
2026-04-24 Enhance clock gating and DFT support in synthesis flow
    - Updated clockgate_dft_map.v to support $_DFFE_PN0P_ cells with async reset handling for DFT.
    - Modified clockgate_map.v to include $_DFFE_PN0P_ for async reset support and clarified comments.
    - Improved sram_1rw.sv documentation for clarity and consistency in comments.
    - Configured Magic to treat SRAM macros as abstract cells to prevent errors during extraction.
    - Added functionality in gen_gate_count.py to count gated DFFs based on netlist connectivity.
    - Enhanced reporting in gen_report.py to include CPI (cycles per instruction) in simulation statistics.
    - Updated hier_synth.sh to support hierarchical clock gating and DFT techmaps, e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
    [Makefile.cfg]
2026-04-25 feat: add implementation-only timing constraints for 4-wire JTAG support
2026-04-26 Fix file path in trap.c header comment
    [trap.c]
2026-04-26 chore: remove outdated plan for JV32 RV32IMAC 3-Stage Pipeline Processor
2026-04-26 feat: implement CLIC external interrupt handling and UART simulation state
2026-04-26 feat: enhance RTL trace handling and improve UART simulation accuracy
2026-04-27 Enhance branch predictor functionality and reporting
    - Updated `jv32_pkg.sv` to clarify the purpose of the `bp_taken` signal.
    - Refactored `jv32_rvc.sv` to simplify handling of stale responses under IFETCH_PREADVANCE.
    - Added performance counters for the branch predictor in `jv32_top.sv` and `jv32_soc.sv`.
    - Removed the IFETCH_PREADVANCE configuration option from the synthesis Makefile and related scripts.
    - Updated testbench files to include branch predictor performance metrics and reporting.
    - Adjusted synthesis and report scripts to reflect the removal of IFETCH_PREADVANCE.
    [Makefile.cfg]
2026-04-27 fix: defer debug halt until pending dmem load completes
    When a load instruction (LW) is in the WB stage and dmem_stall=1
    (waiting for the SRAM read response), the previous code would allow
    dbg_halted_r to set immediately. On the next cycle dbg_halted_r=1
    freezes ex_stall, so the load result is never written to the register
    file. OpenOCD then reads the stale register value (the load address)
    instead of the loaded data.
    trigger match, halt request and single-step halt are all deferred until
    any in-flight memory response has been consumed and the register write
    has completed.
    This fixes the three openocd-test failures (test_memory, test_programbuf,
    test_sba) where program-buffer LW from IRA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
    [jv32_core.sv]
2026-04-27 Update clock assumptions and adjust related parameters
    - Changed clock assumption from 100 MHz to 80 MHz in multiple files:
    - Updated UART_LIMIT and baud-rate divisor examples in `clic.c`, `dhry_1.c`, and `jv_uart.h`.
    - Adjusted timing calculations in `dhry_1.c` to reflect the new clock speed.
    - Updated synthesis results in `README.md` to reflect changes in area and flip-flop counts due to the new clock assumption.
    - Minor adjustments to NAND2-equivalent counts and areas for various modules.
    [clic.c]
2026-04-28 Add TODO list and IP-XACT register map for JV32 SoC
    - Created a TODO.md file outlining architecture improvements, ISA extensions, verification tasks, software/RTOS enhancements, synthesis/physical design goals, and documentation updates.
    - Added a comprehensive IP-XACT 2.1 register map in docs/jv32_soc_ipxact.xml, detailing the memory maps for UART, CLIC/CLINT, Magic simulation device, and machine CSRs.
2026-04-28 Enhance JV32 architecture with Zba, Zbb, and Zbs extensions
    - Added support for Zba (address generation), Zbb (basic bit manipulation), and Zbs (single-bit instructions) in the core architecture.
    - Updated the jv32_rvc module to include new instruction encodings for Zbb and Zbs operations.
    - Modified jv32_top and jv32_soc modules to enable configuration parameters for RAS and ZB features.
    - Enhanced the testbench to accommodate new parameters and validate the functionality of the added extensions.
    - Updated Sail configuration files to reflect the new extensions and their supported versions.
    - Refactored the Sail wrapper script to streamline execution and improve compatibility with the new ar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
    [Makefile.cfg]
2026-04-28 Refactor RV32B parameter naming and update related code
    - Renamed ZB_EN parameter to RV32B_EN in jv32_top and jv32_soc modules to better reflect its purpose.
    - Updated corresponding connections in the jv32_top and jv32_soc instantiations.
    - Modified the software Makefile to conditionally append B-extension sub-extensions based on RV32B_EN.
    - Enhanced the simulation code to track the next RTL PC after interrupts, improving interrupt handling accuracy.
    - Updated the verification scripts and formal properties to align with the new parameter naming and ensure correctness in CSR behavior.
    - Adjusted the synthesis report to reflect changes in area and utilization metrics.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
    [Makefile.cfg]
2026-04-28 Add heartbeat LED functionality and related updates
    - Updated constraints file to include heartbeat LED configuration (H9, LVCMOS33).
    - Modified block design script to create and connect heartbeat LED output.
    - Enhanced top-level module to include heartbeat LED output signal.
    - Updated SOC and core modules to support heartbeat signal toggling every 2^24 retired instructions.
    - Added heartbeat output to CSR and RVC modules.
    - Updated simulation and testbench files to handle heartbeat signal and ensure coverage.
    - Refactored illegal instruction tests in trap.c to improve coverage analysis.
    - Initialized source buffers in zcb.c to avoid misalignment issues during tests.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
    [axi_magic.sv, constraints.xdc, jv32_core.sv, jv32_csr.sv, jv32_fpga_top.sv, jv32_rvc.sv, jv32_soc.sv, jv32_soc_fpga.v]
2026-04-29 Add jv32 SoC support and various samples
    - Introduced a new SoC for RISC-V architecture named jv32, including necessary Kconfig and linker files.
    - Implemented UART echo sample demonstrating TX/RX functionality with console output.
    - Added thread synchronization sample showcasing producer-consumer pattern and worker threads using mutexes and semaphores.
    - Created CMakeLists.txt and configuration files for both samples to facilitate building and running.
    - Included metadata for twister test runner in the stress test case.
2026-04-29 feat: replace k_yield with k_sleep for improved synchronization in tests
    [main.c]
2026-04-29 Add IBUF_EN support and update related files
    - Added `--ibuf-en` argument to `gen_report.py` for enabling/disabling input buffer.
    - Updated `hier_synth.sh` to include `IBUF_EN` in synthesis parameters.
    - Modified `axi_memory.sv` to track and handle `IBUF_EN` in the AXI memory module.
    - Updated project references from KV32 to JV32 in `elfloader.cpp` and `elfloader.h`.
    - Added `IBUF_EN` parameter to the testbench `tb_jv32_soc.sv` module.
    [Makefile.cfg]
2026-04-29 Refactor Dmem driver to implement a 2-entry store queue
    - Changed sb_valid, sb_addr, sb_wdata, and sb_wstrb to support two entries.
    - Updated logic to handle enqueueing and draining of stores from the queue.
    - Introduced sb_enqueue_wstrb for write-strobe calculation based on memory operation.
    - Modified stall conditions to account for the new store queue structure.
    - Ensured that the store queue operates correctly during memory operations in EX/WB stages.
    [jv32_core.sv]
2026-04-29 Update memory map and external RAM support
    - Changed DRAM base address from 0xC0000000 to 0x90000000 and updated related documentation.
    - Introduced EXTRAM at 0xA0000000 with 2 MB size for external AXI RAM, applicable for simulation.
    - Updated linker script to define sections for external RAM (.text.ext, .rodata.ext, .data.ext).
    - Modified startup assembly to reflect new memory layout.
    - Enhanced extram.c to test various read/write operations on the new external RAM.
    - Updated platform header and TCM alias definitions to align with new memory addresses.
    - Adjusted testbench files to accommodate the new DRAM and EXTRAM configurations.
    - Updated verification configurations to reflect changes i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
    [Makefile.cfg]
2026-04-29 Add documentation for coverage reports, OpenOCD debug interface, RTOS support, and verification processes
    - Created COVERAGE.md to document the coverage report generated by Verilator, including overall metrics and per-file coverage details.
    - Added README.md in the openocd directory detailing the OpenOCD configuration files and Tcl test scripts for the JV32 JTAG/cJTAG debug interface, including tool requirements and test execution instructions.
    - Introduced README.md in the rtos directory outlining support for FreeRTOS and Zephyr, including sample applications and build instructions for running on the RTL simulator.
    - Established README.md in the verif directory to describe the RISC-V Archit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
2026-04-29 Update documentation for RTOS support and tool requirements
    - Enhanced README.md to include Zephyr support details alongside FreeRTOS.
    - Updated tool requirements section to reference full per-flow tool list in TOOLS.md.
    - Revised coverage report in COVERAGE.md for clarity and consistency.
    - Added explanations for clock gating rates and architectural correctness in syn/README.md.
2026-04-30 feat: enhance trace control signals and data registers for improved power efficiency
2026-04-30 feat: improve IRQ trace handling and power efficiency with conditional resets
    [jv32_core.sv]
2026-04-30 feat: improve async-reset condition handling in synthesis style checker
    [check_synth_style.py, jv32_core.sv]
2026-04-30 update cJTAG openocd script
    [jv32_fpga_cjtag.cfg]
2026-05-01 feat: add 1 Hz blink LED functionality and update related documentation
2026-05-01 add ThreadX and RIOT
2026-05-01 Add Thread-Metric Component for Preemptive Scheduling Test
    - Implemented porting layer for ThreadX in `tm_porting_layer_threadx.c` for cooperative scheduling.
    - Created main application entry point in `main.c` for preemptive scheduling.
    - Developed porting layer for ThreadX in `tm_porting_layer_threadx.c` for preemptive scheduling.
    - Added preemptive scheduling test logic in `tm_preemptive_scheduling_test.c` with multiple threads and reporting mechanism.
2026-05-01 feat: add support for Eclipse ThreadX and RIOT OS in documentation and performance tests
2026-05-04 feat: implement sysbus memory access mode and enhance SBA testing scripts
    [jv32.cfg, jv32_cjtag.cfg, jv32_fpga_cjtag.cfg, jv32_fpga_jtag.cfg]
2026-05-05 fix: improve stability and timing for sbaddress0 handling in jv32_dtm module
    [jv32_dtm.sv]
2026-05-06 verif: update riscv-arch-test submodule to latest (141 commits)
    Update riscv-arch-test from 2b1d76fb to 8d88d502 (act4 branch)
    Notable changes:
    - Replace COVER_ZCA with ZCA_SUPPORTED in coverage files
    - Fix vector coverage
    - Route cp_csr_frm through formatter pipeline
    - Cleanup priv generators
    - Coverage fix for PMP extensions
    - Add InterruptsSstc and improve interrupt suites
    - Update toolchain and Spike dependencies
    This brings in 141 commits with test improvements, bug fixes, and
    updated dependencies.
2026-05-06 Enhance TCM Address Mapping and Alias Handling in jv32 SoC
    - Introduced functions to map alias addresses to canonical TCM addresses for both IRAM and DRAM.
    - Updated address validation functions to account for both canonical and out-of-TCM alias addresses.
    - Added logic to track core alias address and data phase completion to prevent repeated valid signals to TCM.
    - Implemented blocking of external TCM slave access during debug or core alias access.
    - Enhanced debug tracing in the testbench to monitor alias bridge activity for read and write operations.
    [jv32_dtm.sv, jv32_soc.sv, jv32_top.sv, tb_jv32_soc.sv]
2026-05-06 Update README and test scripts for enhanced JTAG/cJTAG debug interface support and error handling
    [jv32_dtm.sv]
2026-05-07 Add sticky flag for step-halt condition to improve debug handling during stalls
    [jv32_core.sv]
2026-05-07 Add jtag-no-trace-step target and update trace handling for FPGA simulation
2026-05-07 Add script to render OpenROAD GDS as KLayout-style PNG
    This commit introduces a new Python script, `gen_layout_gds.py`, which reads the OpenROAD native GDS and final DEF files from an OpenLane2 run directory. The script generates a color PNG image that visualizes various elements, including metal routing polygons, SRAM macro boundaries, standard-cell row areas, and annotations such as die outline and scale bar.
    Key features:
    - Supports customizable output resolution and layer selection.
    - Automatically detects GDS to physical µm scale.
    - Utilizes libraries such as gdstk, Pillow, and numpy for rendering.
    - Provides options to include device layers and customize the output title and legend.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
2026-05-07 Refactor code structure for improved readability and maintainability
    [Makefile.cfg, macro_placement.cfg]
2026-05-07 Update JTAG and cJTAG wiring configurations for accuracy in FPGA setup
    [jv32_fpga_cjtag.cfg, jv32_fpga_jtag.cfg]
2026-05-07 Set default USE_CJTAG parameter to 1 for 2-wire cJTAG compatibility
2026-05-08 Update cJTAG configuration for accurate TDO routing and signal handling
    [jv32_fpga_cjtag.cfg]
2026-05-08 Update README and configuration files for cJTAG and JTAG clarity and accuracy
    [jv32_fpga_cjtag.cfg]
2026-05-08 Refactor SRAM macro from 2048x32 to 1024x64
    - Updated the SRAM macro implementation in `sram_1rw.sv` to use 1024x64 sub-banks instead of 2048x32.
    - Adjusted address mapping and data handling to accommodate the new word size and bank structure.
    - Modified the OpenLane configuration to reflect the new SRAM macro dimensions and paths.
    - Updated macro placement configuration for the new SRAM size.
    - Changed gate count script to reference the new SRAM macro.
    - Enhanced testbench to include additional boot address parameter and added a lint sink for unused signals.
    [macro_placement.cfg]
2026-05-09 Update placement density and die/core area metrics in documentation
    [macro_placement.cfg]
2026-05-10 add gdb test to test step/next/watchpoint
    [jv32_gdb.cfg]
2026-05-10 Enhance RTL trace comparison and debugging support in testbench and hello.c
    - Improved performance of RTL trace file comparison by implementing parallel file reading and optimized string operations.
    - Added detailed comments and constructs in hello.c for GDB debugging, including access watchpoints and breakpoint labels.
    - Updated tb_jv32_vpi.cpp to support RTL instruction tracing with new command-line options and trace output handling.
2026-05-10 Add Zcmp extension architecture tests for cm.popret, cm.popretz, and cm.push instructions
    - Implemented `Zcmp-cm.popret-00.S` to test the cm.popret instruction, verifying the correct restoration of registers and stack pointer.
    - Implemented `Zcmp-cm.popretz-00.S` to test the cm.popretz instruction, ensuring a0 is zeroed upon return and registers are restored correctly.
    - Implemented `Zcmp-cm.push-00.S` to test the cm.push instruction, checking the correct storage of registers to the stack and the adjustment of the stack pointer.
    - Added a new test configuration file `test_config.yaml` for the JV32 RV32IMAC with Zcmp extension, specifying the reference model and necessary paths.
    [gen_icg_clocks.py, zcmp.c]
2026-05-10 Enhance OpenLane flow and add Zcmp support
    - Updated Makefile to check for extracted SPICE files and provide error messages if not found.
    - Modified config.yaml for OpenLane to adjust die and core area dimensions, target density, and routing parameters to improve layout and reduce congestion.
    - Enhanced SDC file to dynamically create generated clocks for core-domain ICG cells and set clock groups for asynchronous domains.
    - Revised macro placement configuration to implement a 2x2 grid layout for SRAM, improving routing corridors.
    - Updated testbench to include ZCMP_EN parameter for the SOC.
    - Expanded verification Makefile to include Zcmp-specific configurations and targets for running arch-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
    [Makefile.cfg, macro_placement.cfg]
2026-05-11 Add UART backend implementation and related I/O stubs for jv_putc()/jv_exit()
2026-05-11 Enhance semihosting support and improve I/O backend handling
    - Added support for multiple I/O backends (semihost, magic, uart) in the Makefile.
    - Updated the common startup sequence to utilize semihosting for exit handling.
    - Implemented semihosting syscall handling in jv_irq.c for character output and exit.
    - Refactored jv_putc and jv_exit functions to support raw magic-device fallback.
    - Removed unnecessary trap handler definitions in atomic and fence tests.
    - Updated C++ test files to handle exceptions with weak symbol definitions.
    - Adjusted macro placement and routing configurations in OpenLane for improved layout.
    - Enhanced verification scripts and README to reflect changes in Zcmp su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
    [macro_placement.cfg]
2026-05-11 Refactor Zcb and Zcmp instruction handling; update macro placement configuration
    - Updated comments in zcb.c to use consistent arrow notation for instruction mappings.
    - Improved clarity in zcmp.c comments regarding instruction classes and encoding references.
    - Adjusted macro placement configuration in macro_placement.cfg for better layout.
    - Enhanced GDS generation script to improve visual representation of SRAM macros.
    - Added semihosting support in tb_jv32_soc.cpp for better interaction with simulation.
    - Modified SDC constraints in jv32_soc_pnr.sdc to optimize timing margins.
    - Updated OpenLane configuration to reflect new macro placement and timing adjustments.
    [macro_placement.cfg]
2026-05-12 Enhance Makefile and GDB scripts for improved I/O backend handling and test accuracy; update memory mapping in device tree and configuration files
    [macro_placement.cfg]
2026-05-13 Enhance OpenOCD Makefile and README for semihosting support; update hello.c for printf usage in semihost path; revise REPORT and config files for updated design metrics and macro placements.
    [macro_placement.cfg]
2026-05-13 Implement semihosting support in RISC-V architecture; add compile-time checks in axi_uart, enhance exit handling in riot_start, and update trap handling in irq_arch; revise macro placements in config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
    [macro_placement.cfg]
2026-05-15 Enhance UART and Semihost I/O Functionality
    - Added runtime checks for CLKS_PER_BIT in axi_uart module to ensure valid baud rate configurations during simulation.
    - Introduced semihost_mem_ptr function to optimize memory access in semihosting by reducing host I/O calls.
    - Implemented jv_write function in jv_io_magic.c, jv_io_semihost.c, and jv_io_uart.c to handle writing data more efficiently.
    - Updated syscall.c to utilize jv_write for improved write operations.
    - Modified jv_platform.h to declare jv_write function for consistency across I/O implementations.
    - Adjusted Makefile to enable ZCMP feature based on RV32EC configuration.
    - Updated REPORT.md with new synthesis metrics and design ar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
2026-05-17 Update Makefile, REPORT.md, and configuration files for improved OpenRAM integration and layout adjustments; enhance macro placement and update Python dependencies.
    [macro_placement.cfg]
2026-05-18 Update design report and configuration for jv32_soc
    - Updated the date in REPORT.md to 2026-05-18.
    - Added `ZCMP_EN` to the design parameters in REPORT.md.
    - Revised area metrics, instance utilization, and module breakdown in REPORT.md.
    - Adjusted clock metrics and design checks in REPORT.md, including hold WNS and slew violations.
    - Modified layout dimensions in config.yaml for a smaller die area (1400 um).
    - Updated macro placement configuration to reflect new die dimensions.
    - Added explicit false paths for clock domains in jv32_soc_pnr.sdc.
    - Enhanced timing constraints with max slew and capacitance limits in jv32_soc_pnr.sdc.
    - Improved report generation script to include notes on max c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
    [macro_placement.cfg]
2026-05-20 Fix toggle counter reset logic in cJTAG bridge to handle coincident TCKC and TMSC edges
    [cjtag_bridge.sv]
2026-05-20 Enhance cJTAG support by routing tap_tdo to J12 for FT2232H probe compatibility; stabilize TDO output in cJTAG mode.
    [jtag_top.sv, jv32_fpga_top.sv]
2026-05-21 Add ZCmp extension support and update related files
    - Enabled ZCmp extension in the Makefile by exporting ZCMP_EN and updating architecture extensions.
    - Updated README.md to reflect the toolchain version used for performance measurements.
    - Corrected FPGA pin assignments for LED outputs in README.md, constraints.xdc, jv32_fpga_top.sv, and create_bd.tcl.
    - Enhanced portASM.S and portContext.h to support ZCmp context frame and register saving/restoring.
    - Updated makefile.mak to clarify ZCmp integration and its impact on assembly instructions.
    - Modified zcmp.c to include ZCmp-specific assembly instructions and conditionally compile tests based on ZCmp availability.
    - Updated riscv-arch-test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
    [constraints.xdc, jv32_fpga_top.sv, zcmp.c]
2026-05-25 Update Makefiles and documentation for improved clarity and structure; adjust linker flags and Python dependencies for OpenRAM setup
    [macro_placement.cfg]
2026-05-26 Update memory test scripts and JTAG configurations for improved accuracy and performance; adjust timings and test parameters
    [jv32_fpga_cjtag.cfg, jv32_fpga_jtag.cfg]
2026-06-01 Add SCOREBOARD_EN parameter to jv32_top and jv32_soc modules
    - Introduced SCOREBOARD_EN parameter to enable non-blocking scoreboard for MUL_MC in jv32_top and jv32_soc.
    - Updated instantiation of jv32_core to pass SCOREBOARD_EN.
    - Modified Makefile and synthesis scripts to include SCOREBOARD_EN in synthesis parameters.
    - Adjusted testbench to accommodate SCOREBOARD_EN parameter.
    - Cleaned up initialization of statistics in axi_memory module.
    - Updated synthesis report with new metrics and corrected values.
    [Makefile.cfg]
2026-06-02 Update font configurations in jv32-tech-report-theme.yml
    - Removed Noto Serif font references and replaced with Noto Sans for body text.
    - Updated base font family to Noto Sans for improved readability.
    - Changed inline code and code block font family from M+ 1mn to Courier for consistency.
    [jv32-tech-report-theme.yml]
2026-09-04 Add atomic compatibility tests, fence instruction checks, and memory ordering validation
    - Introduced a new file for atomic compatibility tests addressing misaligned accesses and reserved AMO encodings.
    - Added a self-modifying code test for FENCE.I to ensure visibility of stores before instruction fetches.
    - Implemented single-hart memory-ordering checks for atomic instructions and FENCE behavior.
    - Created a JTAG testbench for focused TAP/DTM/DMI testing to validate debug interface functionality.
    [tb_jtag_dtm.sv]
2026-09-22 Enhance Makefile and CI configuration for compliance testing
    - Added new compliance test targets in the Makefile for various components, including CLIC and CSR testbenches.
    - Updated CI workflow to include directed compliance regressions and preserve results.
    - Modified the JV32 SoC datasheet to clarify compliance status and verification boundaries.
    - Improved memory mapping in the linker script for IRAM and DRAM configurations.
    - Enhanced OpenOCD scripts for better error handling and protocol checks.
    [axi_clic.sv, axi_magic.sv, axi_ram_ctrl.sv, axi_uart.sv, axi_xbar.sv, jtag_top.sv]
2026-09-23 fix simulation failure on arch-test and gdb-test
    [jv32_core.sv]
